aeobrien/DronemakerClonev3/docs/audio-interface/Whole-Component-Left-Sideview.JPG

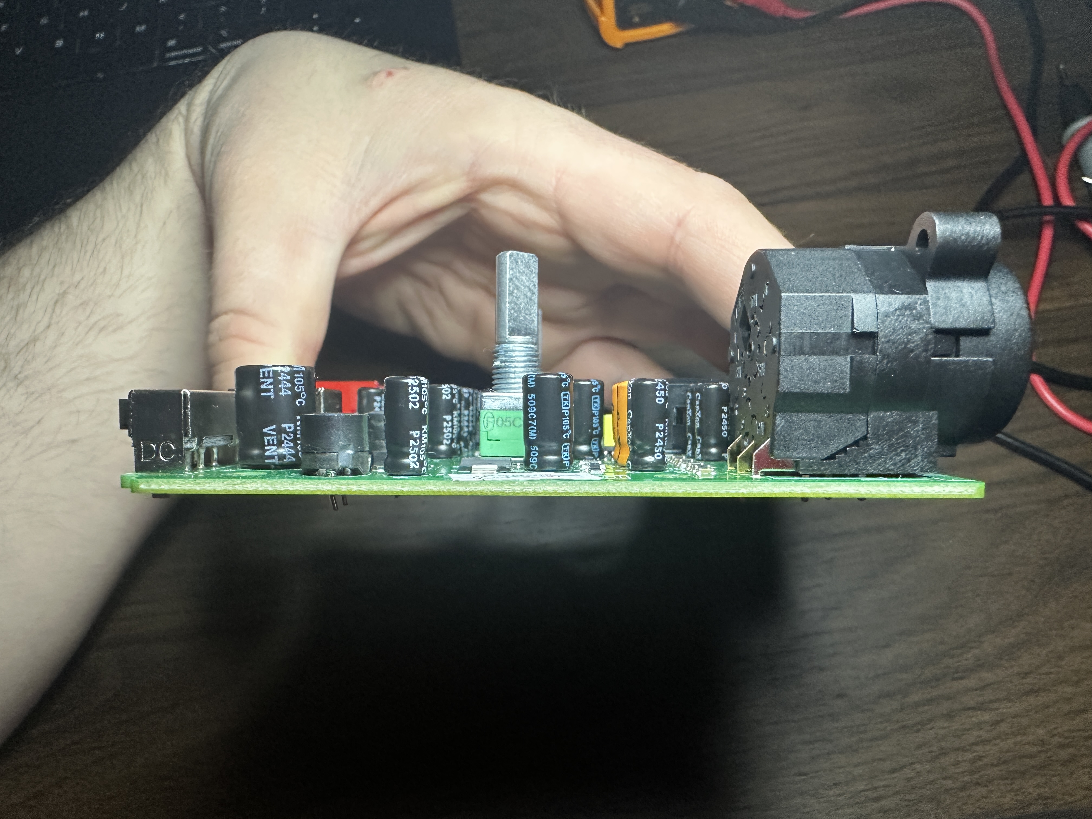
docs/audio-interface/Whole-Component-Left-Sideview.JPG
