aeobrien/DronemakerClonev3/docs/audio-interface/Whole-Component-Above.JPG

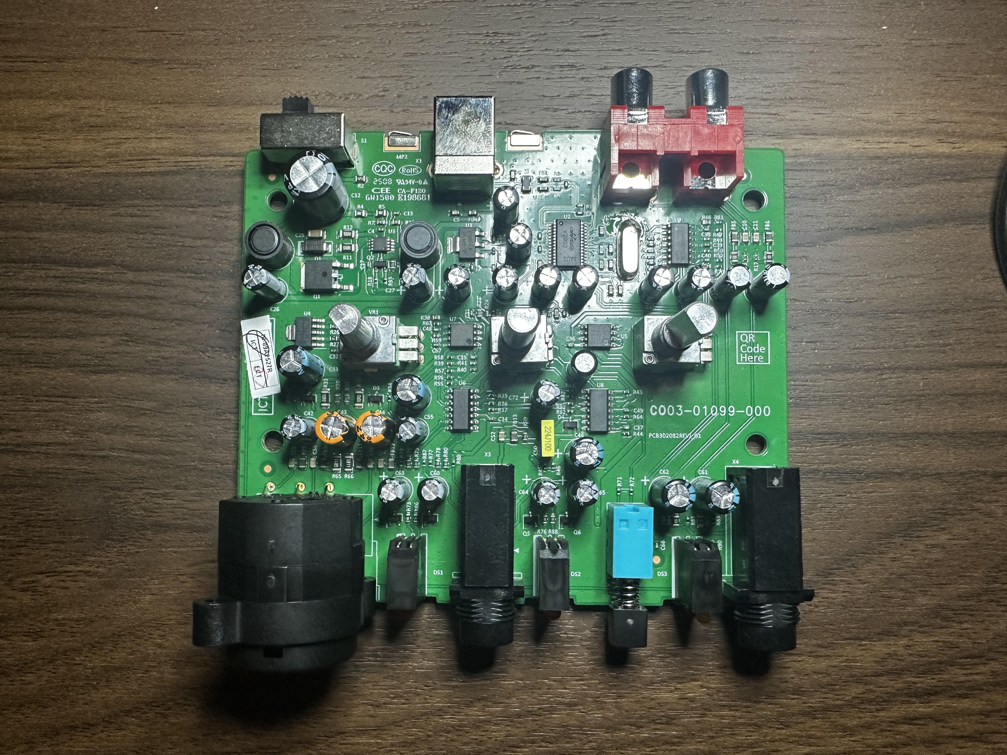
docs/audio-interface/Whole-Component-Above.JPG
