aeobrien/DronemakerClonev3/docs/reference/DronemakerClone — Notepad.md

A3 Printer: https://www.printpond.co.uk/
