aeobrien/DronemakerClonev3/ledger/decisions/LOG.md

# Decision Log

Decisions are recorded when there was a genuine choice between alternatives. Routine implementation details do not need entries.

| # | Date | Decision | Alternatives | Rationale | Impacts |
|---|---|---|---|---|---|
| 1 | 2026-03-30 | Use Behringer UM2 as audio interface, modified for panel-mount | Custom audio input stage; higher-end interface | Affordable (low-risk to modify), single PCB, all through-hole, USB audio class compliant on Linux | Audio Interface, Enclosure |
| 2 | 2026-03-30 | Teensy 4.1 for MIDI controller MCU | Direct Pi GPIO; Arduino | Native USB MIDI, ample pins, 3.3V logic, hardware encoder support, small footprint | MIDI Controller |
| 3 | 2026-03-30 | Shift registers at 3.3V (not 5V) for LED driving | 5V logic with level shifters | Teensy is 3.3V logic; common-anode LEDs still switch correctly (5V anode, 3.3V cathode = below Vf = off) | MIDI Controller |
| 4 | 2026-03-30 | Independent headphone output via Pi (not UM2 headphone jack) | Rewire UM2 headphone output | UM2 headphone was linked to main output; need independent monitor bus for loops/sub-mixes | Headphone Monitor, Audio Interface |
| 5 | 2026-03-30 | USB MIDI for encoder communication (not Pi GPIO) | Direct GPIO encoder reading | Modular, avoids Linux userspace jitter, leverages JUCE MIDI handling, extends to external controllers | MIDI Controller, Software |
| 6 | 2026-03-30 | Reuse original UM2 pots (not replacements) | Alpha replacement pots | Originals cleanly removed; eliminates value/taper matching concerns | Audio Interface |
| 7 | 2026-03-30 | Neutrik NAUSB3-W-B for Pi power input (USB-C, D-size) | Panel-mount DC jack + PD trigger; hardwired | Clean, consistent with other Neutrik connectors, standard D-size cutout | Enclosure |
| 8 | 2026-03-30 | Neutrik NAUSB-W-B for external MIDI USB-A (D-size) | Custom USB-A panel mount | Matches other Neutrik D-size connectors on backplate | Enclosure |
| 9 | 2026-03-30 | InnoMaker HiFi DAC HAT (PCM5122) for headphone output | Second USB DAC; rewire UM2 headphone | Already owned, I2S (no USB contention), well-supported on Pi | Headphone Monitor |
| 10 | 2026-03-30 | Headphone default mirrors main output; PFL button solos selected channel | Always-independent mix | Simpler default, PFL gives the preview capability needed for performance | Headphone Monitor, Software |
| 11 | 2026-03-30 | Phantom power switch stays on board, not panel-mounted; phantom left permanently on | Panel-mount toggle switch | No realistic risk — ribbon mics are the only concern, and user has never encountered one in 20 years of engineering | Audio Interface, Enclosure |
| 12 | 2026-03-30 | Reuse original UM2 pots with hookup wire (not Alpha replacements) | Replace with Alpha 9mm pots | Originals cleanly removed; eliminates all value/taper matching concerns | Audio Interface |
| 13 | 2026-03-31 | JLCPCB for MIDI controller PCB fabrication (DHL Express) | PCBWay; PCB Train (UK domestic) | Cheapest option (~£15-25 all-in), 5-7 day delivery, VAT at checkout (no customs risk), gerbers already packaged | MIDI Controller |
| 14 | 2026-03-31 | No separate headphone amp — use TPA6133A2 built into InnoMaker DAC HAT | External amp module (PAM8403, MAX97220, etc.); opamp circuit | HAT already includes TPA6133A2 headphone amp (138mW@16Ω, adequate for 32-250Ω). Eliminates extra board, power draw, and enclosure space | Headphone Monitor |
| 15 | 2026-03-31 | Passive pot for headphone volume (dual A10K spare) | Software-only volume; active gain stage | Simple wiring (amp output → pot → jack), no extra electronics. A10K functional, A1K ideal. Software volume via PCM5122 digital register available as secondary trim | Headphone Monitor |
| 16 | 2026-03-31 | Software level meters on touchscreen (not hardware VU/LED bargraph) | Tap UM2 audio signal + hardware peak detector + LED bargraph | Hardware metering would require modifying UM2 analogue circuit. JUCE already has level data — just needs UI rendering. Much simpler, no circuit risk | Audio Interface, Software |
| 17 | 2026-03-31 | Faceplate layout: buttons on short edge, screen on slope, 8 encoders below screen, 2 pots left (gains), 2 pots right (volumes), 4 LEDs by left pots | Various alternative arrangements | Encoder knobs align with screen width (19.87mm c-to-c, 4.77mm gaps). Pots grouped by function (input left, output right). LEDs indicate input levels only | Enclosure |
| 18 | 2026-03-31 | Headphone jack on backplate (not faceplate) | Faceplate | Groups all audio I/O connectors together on rear panel. Backplate has space (7 D-size cutouts in 233.4mm) | Enclosure |
| 19 | 2026-03-31 | TUK KUCC1820BPM for USB-C power input (not Neutrik NAUSB3-W-B) | Neutrik NAUSB3-W-B (unavailable); Cliff CP30201X (disclaims PD) | Pigtail design avoids PD passthrough risk — plug goes directly into Pi. Keystone mount, not D-size. Cutout dimensions TBD. | Enclosure |
| 20 | 2026-03-31 | Neutrik NAUSB3-B for USB-A data (USB-A outside, USB-B inside) | USB-A to USB-A feedthrough | Standard USB-A/B cable connects inside to Pi. D-size cutout, USB 3.0. | Enclosure |
| 21 | 2026-04-01 | TUK KUCC1820BPM is standard keystone mount (16.2 × 14.7mm cutout) | N/A | Confirmed from TUK product page: "standard profile keystone socket" | Enclosure |
| 22 | 2026-04-01 | Screen cutout sized to active display area (155 × 87mm, Option A) | Full board cutout (165 × 107mm, Option B) | Board mounts behind panel, bezel overlaps cutout edges. Hides asymmetry and positioning errors. Display active area offset from mount holes by X=+1.9mm, Z=-5.15mm. | Enclosure |
| 23 | 2026-04-01 | Headphone volume pot taper shaping: 1KΩ resistor wiper-to-ground per channel | Source a dual A1K pot (unavailable in 9mm dual-gang) | Standard technique reshapes A10K taper for low-impedance headphone loads. Two resistors, no new pot needed. | Headphone Monitor |
| 24 | 2026-04-01 | Outsource panel CAD to professional designer (Fiverr) | Continue iterating with FreeCAD scripting | Boolean STEP operations produced persistent geometry artifacts. A CAD designer with proper parametric modelling will produce a clean manufacturing-ready file. Design brief prepared. | Enclosure |
| 25 | 2026-04-02 | LED bezel hole size: 6.2mm | 6.3mm (extra clearance) | Measured: body ~6.1-6.2mm, flange 7.8mm. 6.2mm gives 0.8mm flange overlap per side — sufficient retention. 6.3mm buys nothing. | Enclosure |
| 26 | 2026-04-02 | Backplate connector order: Headphone, L Out, R Out, Instrument XLR, TRS, USB-A, USB-C | Previous order (XLR first) | Groups outputs on the left, inputs in the middle, data/power on the right | Enclosure |
| 27 | 2026-04-02 | Screen cutout centred on panel; mount holes offset −1.9mm from centre | Centre mount holes on panel | Active display area must appear centred to the user. The display board's active area is offset +1.9mm from its mount holes, so mount holes shift left. HDMI/USB ports on right edge (viewed from front). | Enclosure |
| 28 | 2026-04-02 | Design brief restructured: SVGs are layout guides, not technical drawings; designer owns accuracy | Provide DXF technical drawings | We cannot guarantee DXF accuracy — safer to provide visual guides + dimensions table and let the designer produce the technical files. | Enclosure |
| 29 | 2026-04-06 | MIDI-learned mappings take priority over VirtualEncoderBank dispatch | Encoder bank intercepts first (original order) | Encoder bank hardcodes CC 20-27; any MIDI Learn mapping for those CCs was silently dead because the encoder bank handled them first. Now learned mappings are checked before the encoder bank. | Software — UI & Control |
| 30 | 2026-04-06 | Pi layout as default on all platforms | Only auto-enable on Linux | Pi layout is the primary target UI; defaulting to it on macOS enables testing without CLI flags. `--desktop-layout` still available as override. | Software — UI & Control |
| 31 | 2026-04-08 | Mount Waveshare display inverted (180°), flip in software | Rearrange panel layout for right-way-up mounting | Designer's CAD requires inverted screen. Mounting right-way-up would push encoder row further from screen — unacceptable for ergonomics. Software rotation is trivial (`display_rotate=2` or JUCE transform). | Enclosure, Software — UI & Control, Raspberry Pi Platform |
| 32 | 2026-04-08 | Encoder holes reduced to 9.3mm (from 9.5mm), 3.3mm locator holes added | Previous spec (9.5mm, no locator holes) | Datasheet specifies 9.3mm mounting hole. Locator holes (3.3mm, 9mm above encoder centre) were missing from original design brief — needed to prevent encoder rotation in panel. Sent to designer. | Enclosure |
| 33 | 2026-04-10 | Non-polarised 47µF electrolytic capacitors acceptable for C4/C5 | Order specified polarised caps | Same capacitance (47µF) and voltage rating (100V). NP caps work in either direction — superset of the DC application. Physically larger (10×20mm vs 8×10mm) but fits pad spacing. Marked NP on body. | MIDI Controller |
| 34 | 2026-04-10 | Cheltenham Hackspace for CNC fabrication advice and membership | Online CNC services; Fiverr machinist | Emily's suggestion. Local resource, can learn CNC there. Visited open evening Apr 9, email sent Apr 10. Signing up for Standard + Plus One membership. | Enclosure |
| 35 | 2026-04-10 | PEC16-4xxxF encoder pinout: A (bottom left), B (bottom middle), C/common (bottom right), S/W (top two, interchangeable) | N/A | Confirmed from datasheet page 2 bottom diagram. GND bridges C and one S/W pin. Wiring: black=A, red=B, yellow=GND(C+S), white=SW. | MIDI Controller |
| 36 | 2026-04-11 | Swap CLOCK/LATCH in firmware (pin 34=CLOCK, pin 33=LATCH) + physical pin swap on U2 only | Pin-lift U1 and U3 (2 chips); cut traces and bodge wire; re-order corrected PCBs | PCB layout bug: SRCLK (pin 11) and RCLK (pin 12) are transposed on U1 and U3 but correct on U2. Confirmed by continuity testing. Firmware swap fixes the majority (2 of 3 chips), leaving only U2 needing a physical pin-lift — one chip instead of two. Least invasive fix. | MIDI Controller |
| 37 | 2026-04-13 | Request PCB revision from Tanveer: (1) correct U1/U3 SRCLK/RCLK swap, (2) add encoder RC debounce filters (32x 10kΩ + 16x 10nF) | Continue with firmware workaround + manual pin-lift | Proper fix is cheaper than debugging time. Encoder filters needed per PEC16 datasheet (same issue found independently on Loom). Combined £100 revision request with Loom brain board. | MIDI Controller |
