aeobrien/DronemakerClonev3/docs/audio-interface/Headphone-Out-Below.JPG

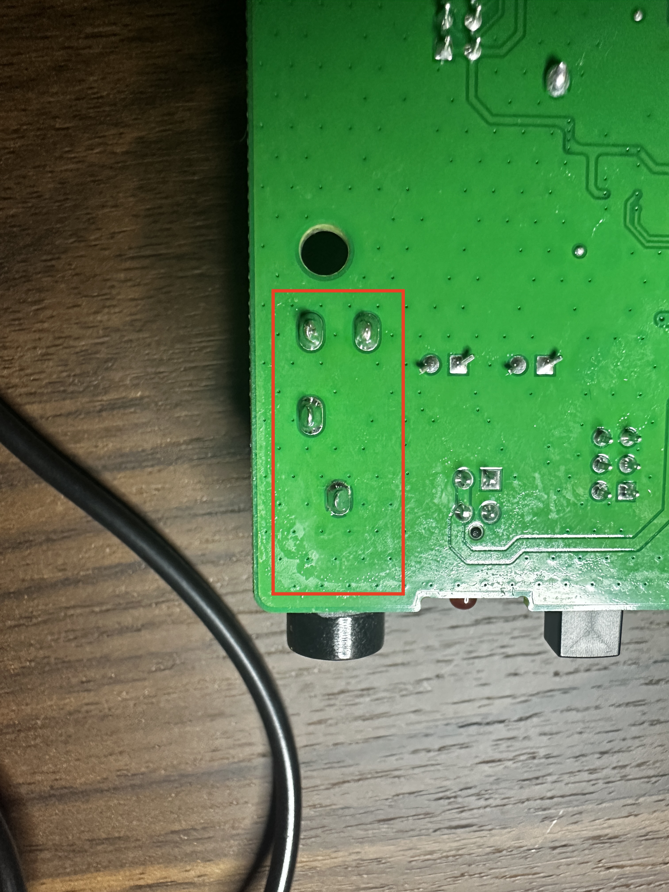
docs/audio-interface/Headphone-Out-Below.JPG
