aeobrien/DronemakerClonev3/docs/audio-interface/Instrument-In-Below.JPG

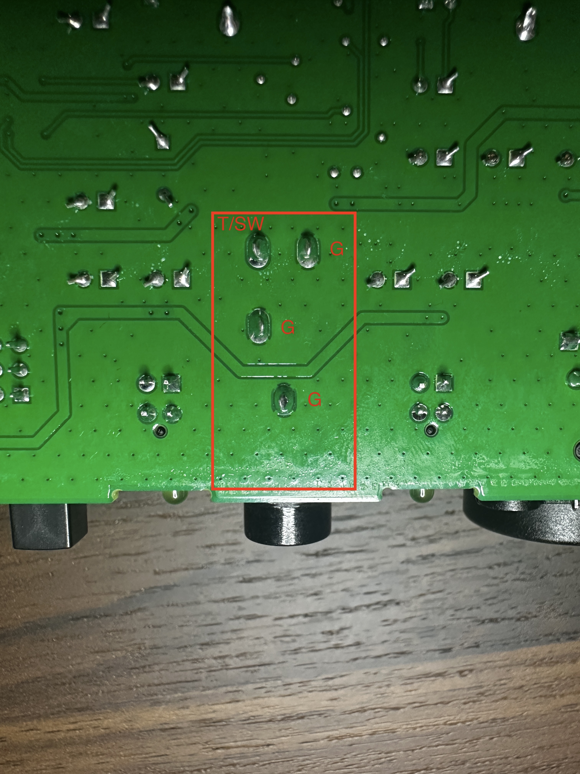
docs/audio-interface/Instrument-In-Below.JPG
