aeobrien/DronemakerClonev3/docs/audio-interface/Instrument-In-LEDs-Above.JPG

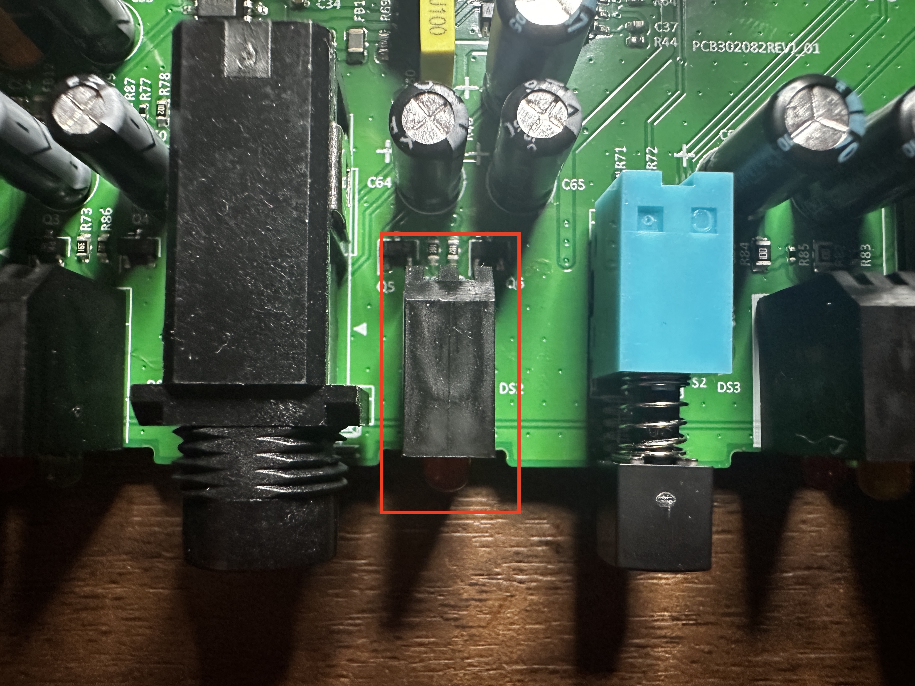
docs/audio-interface/Instrument-In-LEDs-Above.JPG
