aeobrien/DronemakerClonev3/docs/audio-interface/Instrument-In-LEDs-Below.JPG

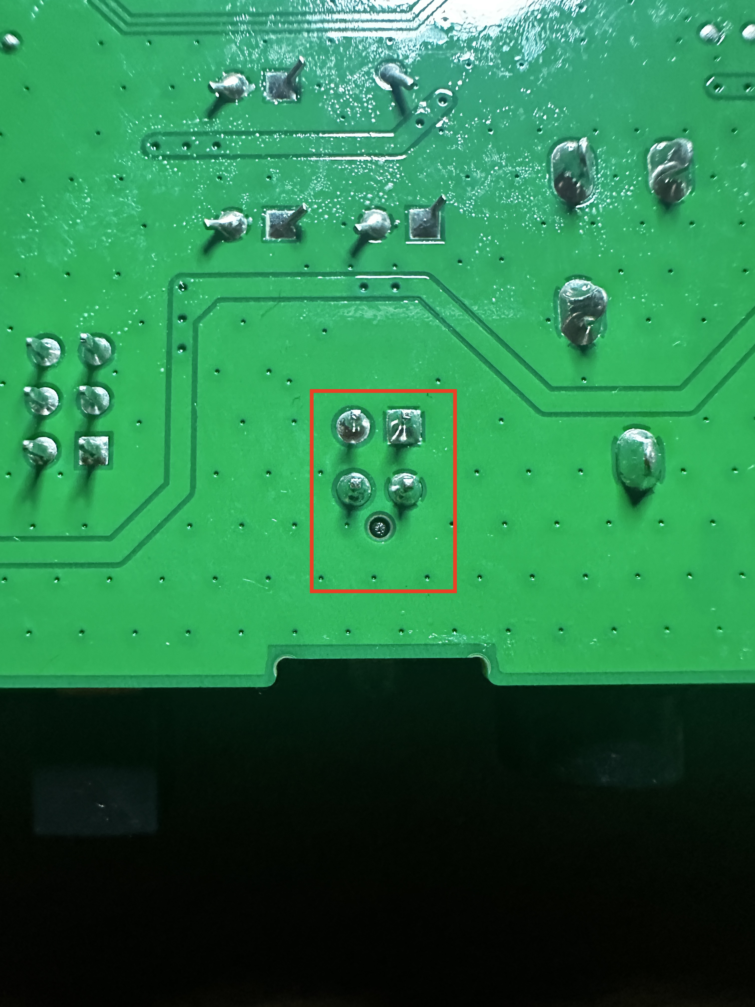
docs/audio-interface/Instrument-In-LEDs-Below.JPG
