aeobrien/DronemakerClonev3/docs/audio-interface/Instrument-In-Pot-Below.JPG

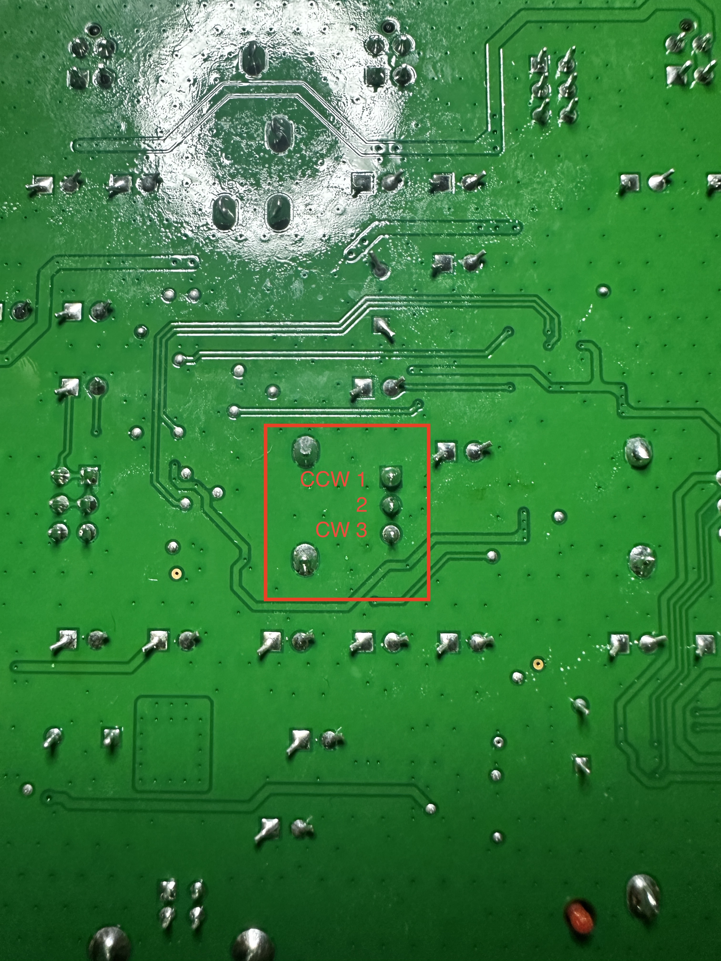
docs/audio-interface/Instrument-In-Pot-Below.JPG
