aeobrien/DronemakerClonev3/docs/audio-interface/Output-Pot-Below.JPG

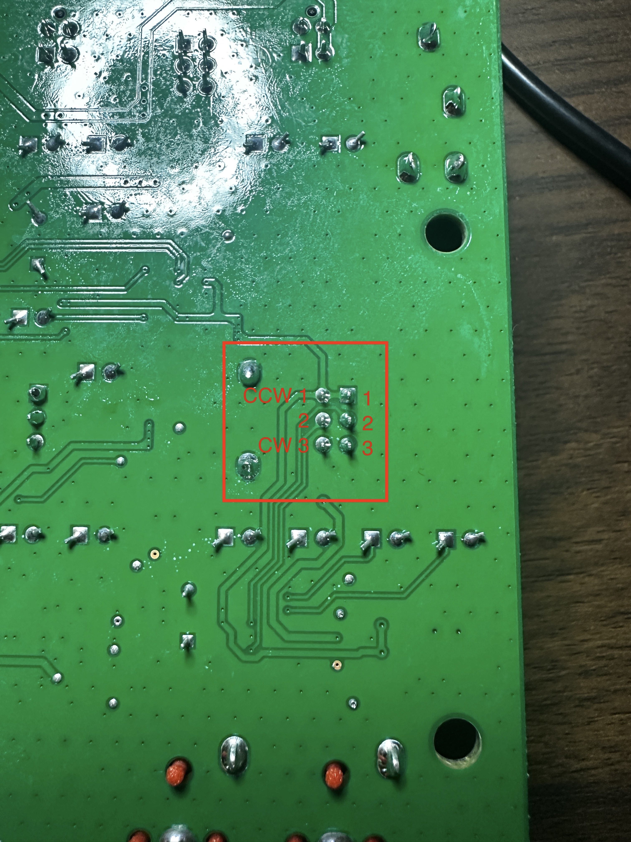
docs/audio-interface/Output-Pot-Below.JPG
