aeobrien/DronemakerClonev3/docs/audio-interface/Phantom-Switch-Below.JPG

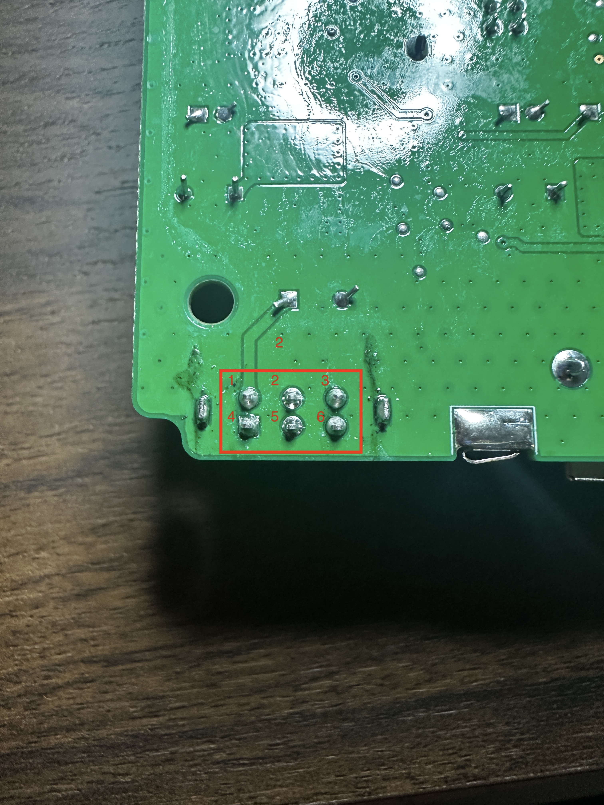
docs/audio-interface/Phantom-Switch-Below.JPG
