aeobrien/DronemakerClonev3/docs/audio-interface/Power-Phantom-LEDs-Above.JPG

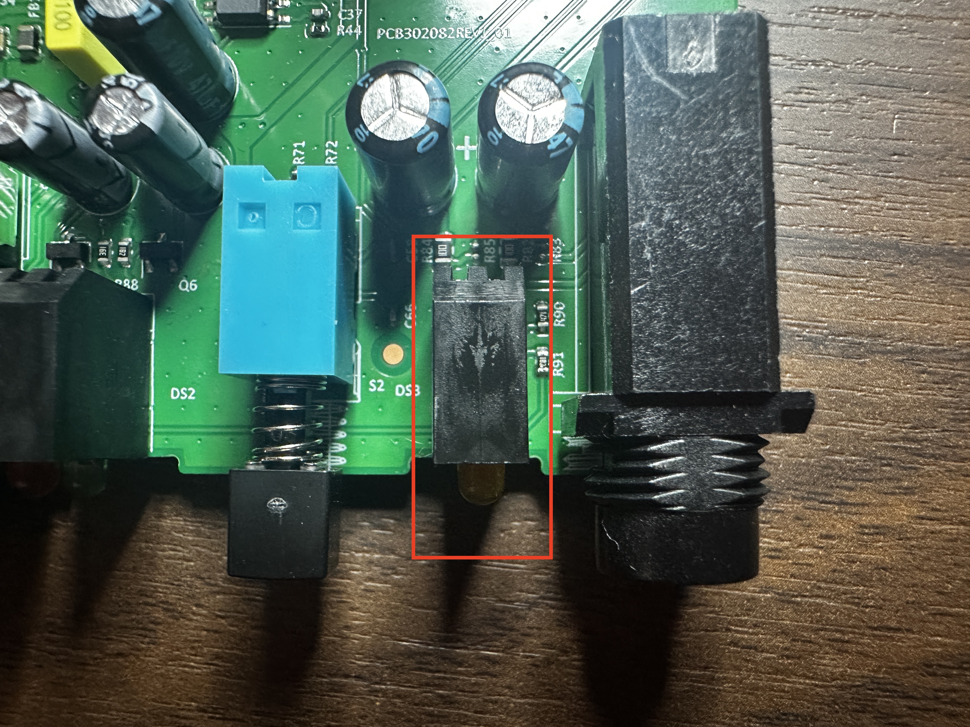
docs/audio-interface/Power-Phantom-LEDs-Above.JPG
