aeobrien/DronemakerClonev3/docs/audio-interface/Power-Phantom-LEDs-Below.JPG

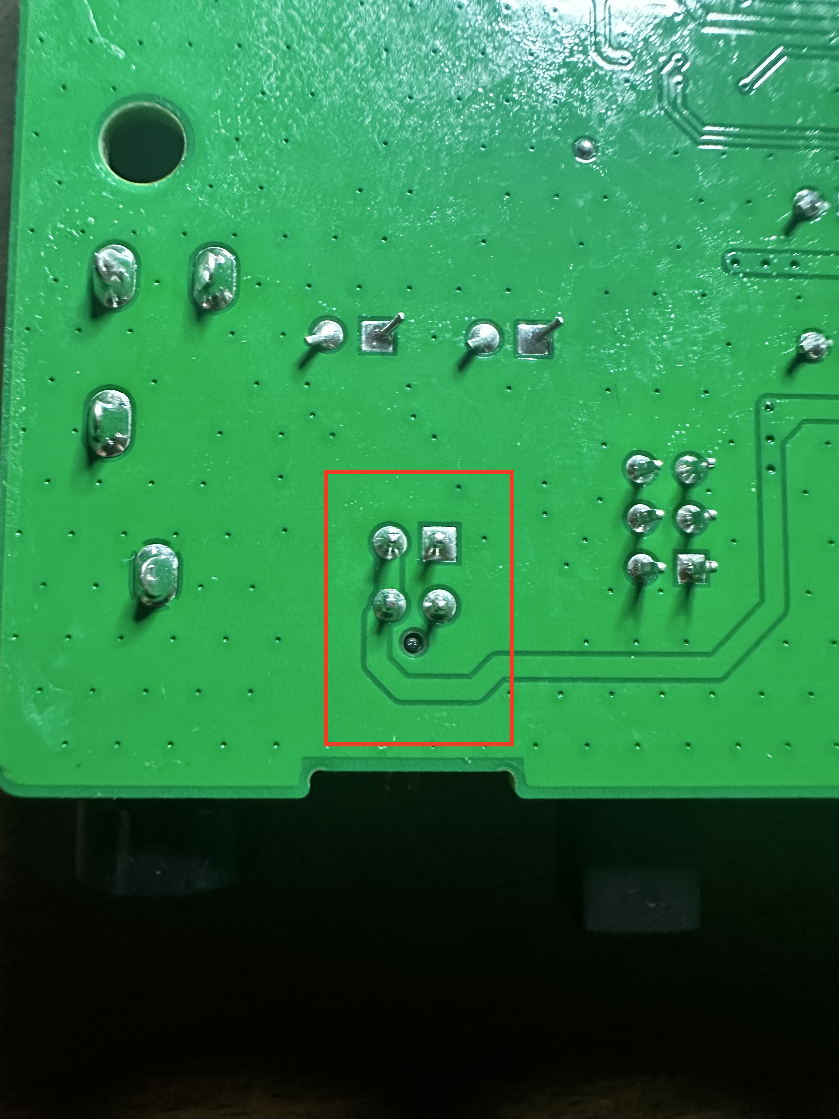
docs/audio-interface/Power-Phantom-LEDs-Below.JPG
