aeobrien/DronemakerClonev3/docs/audio-interface/RCA-Out-Below.JPG

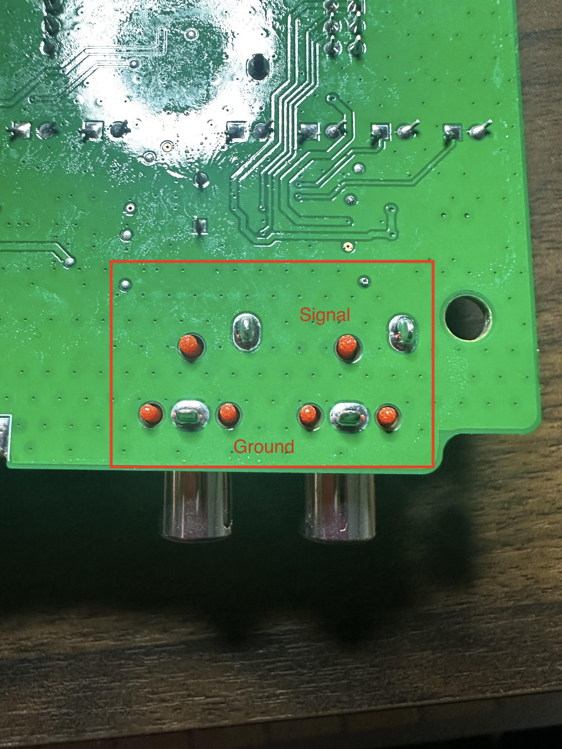
docs/audio-interface/RCA-Out-Below.JPG
