aeobrien/DronemakerClonev3/docs/audio-interface/XLR-TRS-Below.JPG

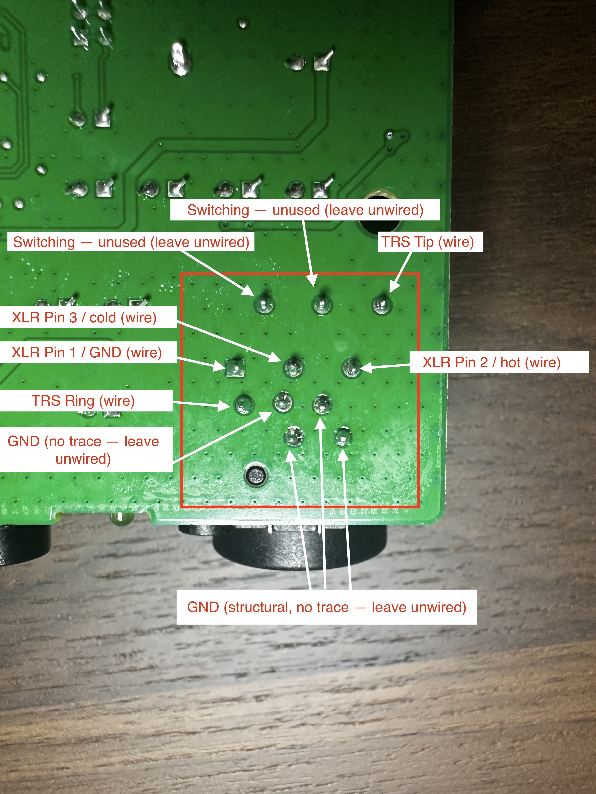
docs/audio-interface/XLR-TRS-Below.JPG
