aeobrien/DronemakerClonev3/docs/audio-interface/XLR-TRS-LEDs-Above.JPG

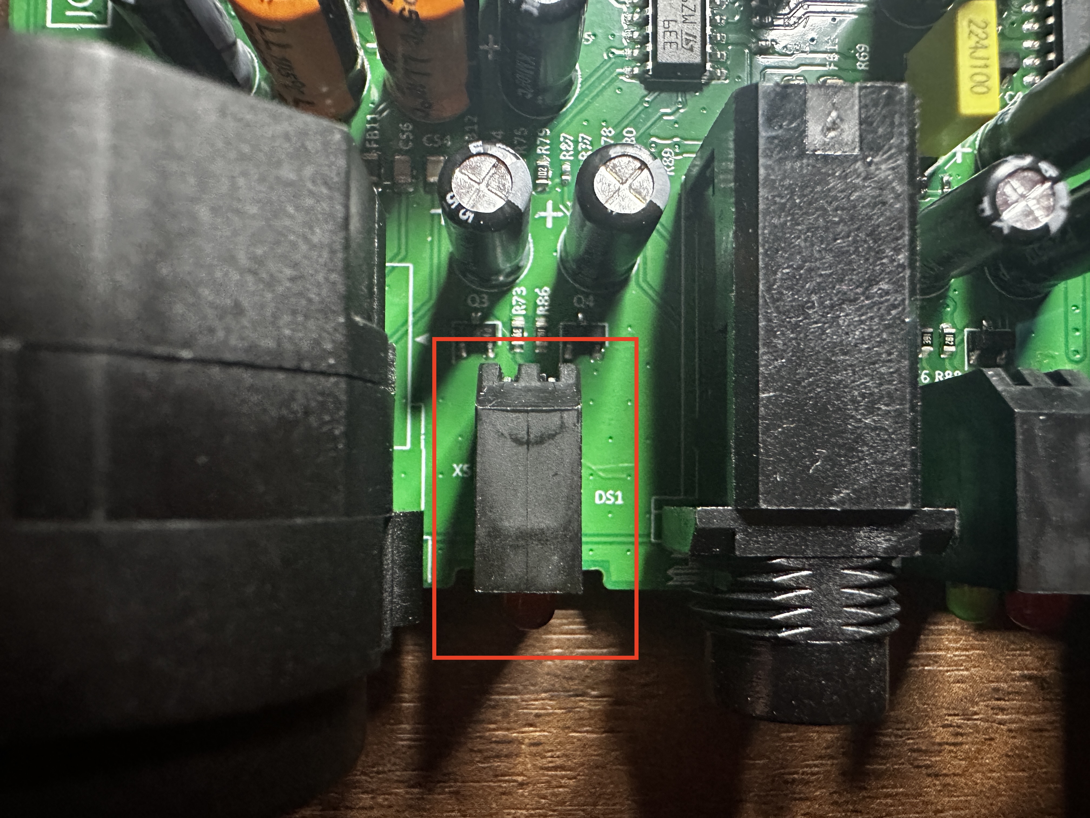
docs/audio-interface/XLR-TRS-LEDs-Above.JPG
