aeobrien/DronemakerClonev3/docs/audio-interface/XLR-TRS-LEDs-Below.JPG

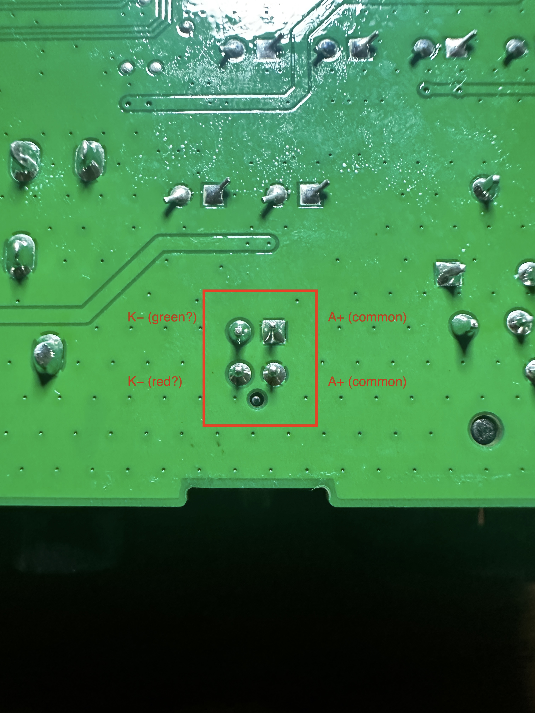
docs/audio-interface/XLR-TRS-LEDs-Below.JPG
