aeobrien/DronemakerClonev3/docs/audio-interface/XLR-TRS-Pot-Below.JPG

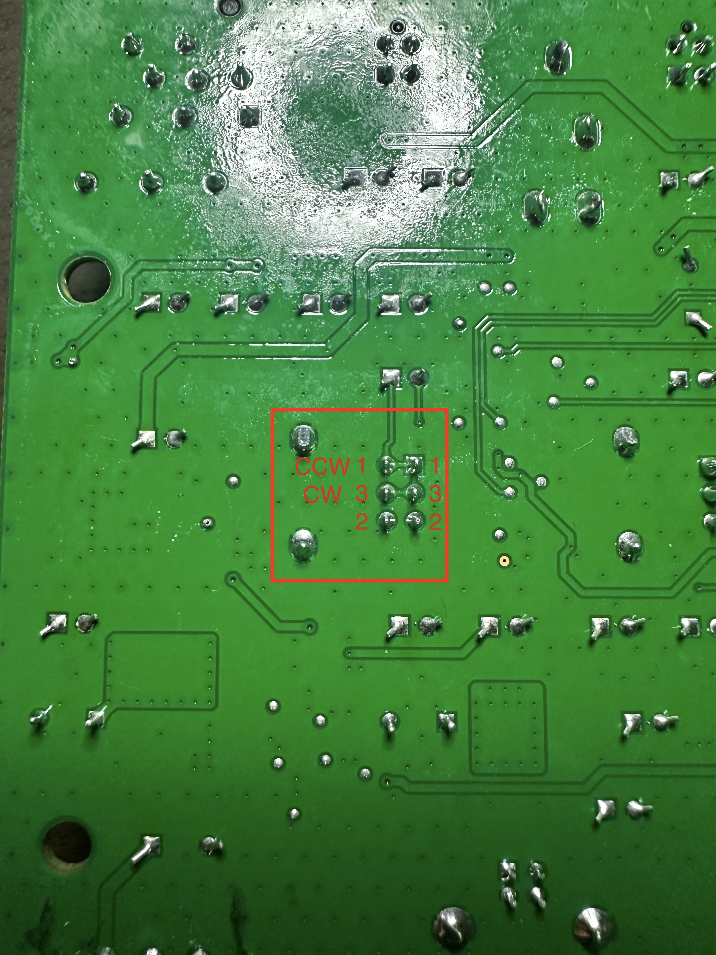
docs/audio-interface/XLR-TRS-Pot-Below.JPG
