aeobrien/DronemakerClonev3/docs/audio-interface/XLR-TRS-SideView.JPG

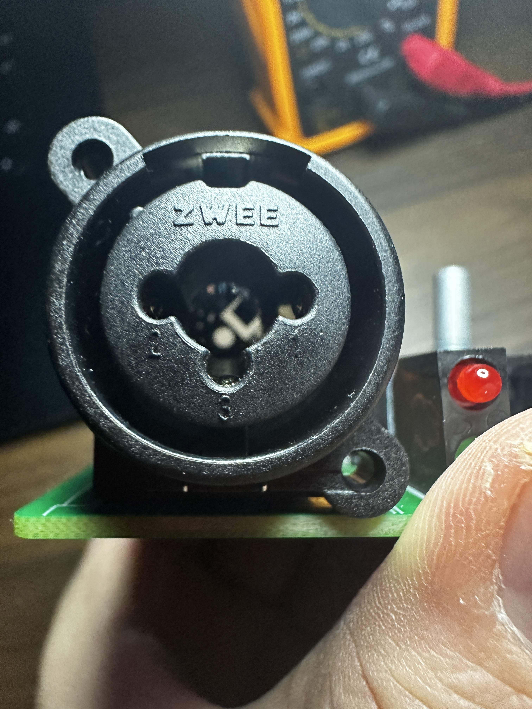
docs/audio-interface/XLR-TRS-SideView.JPG
