aeobrien/DronemakerClonev3/docs/midi-controller/MIDI Controller PCB Layout.jpeg

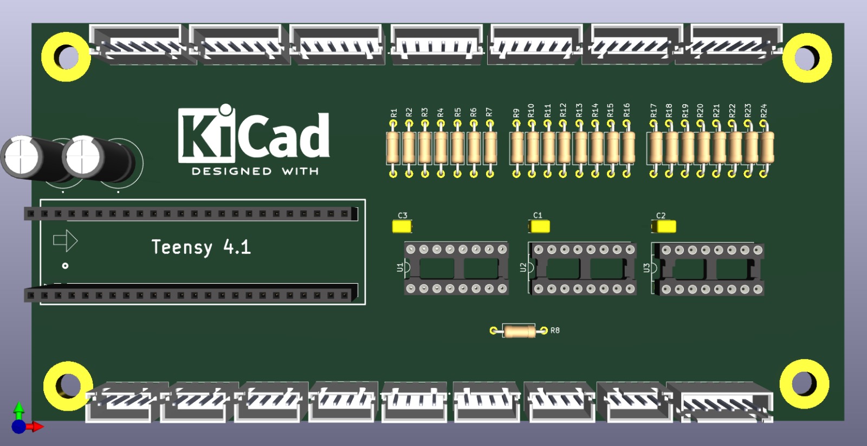
docs/midi-controller/MIDI Controller PCB Layout.jpeg
