aeobrien/DronemakerClonev3/ledger/SHOPPING_LIST.md

# Shopping List

> Items still needed. Updated: 2026-04-02

## Still To Buy

| Item | Spec | Purpose | Source | Ref |
|---|---|---|---|-----|
| Adhesive PCB clips (4mm) | Self-adhesive snap-in, 4mm hole | Mount UM2 PCB (×4) | Amazon / eBay / CPC | #42b |
| PCB mounting for Pi + MIDI controller | **Decision pending** — VHB tape, 3.18mm clips, or adhesive foam pads | Mount Pi 5 (2.7mm holes) + MIDI controller (5mm holes) | TBD | #42a/c |
| M3 screws (×4) | Length TBD after measuring panel + standoff depth | Screen mounting | Check stock | — |

## To Verify — May Already Have

| Item | Check |
|---|---|
| 1KΩ resistors ×2 | In stock (confirmed by user) |
| Hookup wire (stranded, 22–26 AWG) | In stock (confirmed by user) |
| M3 nylon standoffs/screws | Check existing kit for screen mounting |

## Ordered — In Transit

| Item | Ordered | Source | Ref |
|---|---|---|-----|
| MIDI Controller PCB ×5 | 2026-03-31, Order Y3-12248591A | JLCPCB (DHL Express) | #25 |
| TUK KUCC1820BPM USB-C panel mount | 2026-03-31 | CPC | #28 |
| Neutrik NAUSB3-B USB 3.0 feedthrough | 2026-03-31 | CPC | #29 |
| 3.5mm TRS plug | 2026-03-31 | CPC | #39 |
| Loctite 222 (purple) | 2026-03-31 | eBay | #41 |
| Heat shrink tubing kit (Eventronic) | 2026-04-01 | Amazon | #40 |
| 5mm LED bezels ×4 (chrome) | 2026-04-01 | eBay | #15 |
| Foam adhesive tape (1mm EVA) | 2026-04-01 | Amazon | #43 |
| Micro USB to USB-A cable (~15cm) | 2026-04-01 | Amazon | #45 |
| USB-A to USB-B cables (~15cm) ×2 | 2026-04-01 | Amazon | #46 |

## Waiting On (Not Yet Orderable)

| Item | Blocker |
|---|---|
| Faceplate/backplate (single panel) | CAD design needs outsourcing to professional designer. Brief ready at `hardware/enclosure/design-brief/` |

## Notes

- **LED bezel hole size:** confirm ~7.5mm when 5mm bezels arrive (currently spec'd as 8mm, may need adjustment)
- **Headphone pot:** using spare dual A10K (#38) + 1KΩ taper-shaping resistors (#44). All in hand.
- **Screen mounting:** M3 holes at 157.0 × 115.0mm spacing. Screen bolts directly to panel.
- **Panel design:** all cutout dimensions confirmed. Outsource to Fiverr CAD designer using the design brief.
