aeobrien/DronemakerClonev3/ledger/components/REGISTER.md

# Component Register

## Index

| # | Component | Type | Manufacturer | Part Number | Subsystem | Status | Qty |
|---|---|---|---|---|---|---|-----|
| 1 | Raspberry Pi 5 | SBC | Raspberry Pi | Raspberry Pi 5 (4GB or 8GB) | Pi Platform | In hand | 1 |
| 2 | Waveshare 7" HDMI LCD (C) | Display | Waveshare | 7inch HDMI LCD (C) | Pi Platform | In hand | 1 |
| 3 | Pi 5 27W USB-C PSU | Power supply | Raspberry Pi | Official Pi 5 PSU | Pi Platform | In hand | 1 |
| 4 | Behringer UM2 | Audio interface | Behringer | UM2 (PCB302082REVJ_01) | Audio Interface | In hand (modded) | 1 |
| 5 | Neutrik Combo XLR/TRS Jack | Connector | Neutrik | NCJ6FI-S (or NCJ9FI-S) | Audio Interface | In hand (TBC part) | 1 |
| 6 | Neutrik 1/4" Jack (instrument in) | Connector | Neutrik | NJ3FP6C-BAG | Audio Interface | In hand | 1 |
| 7 | Neutrik 1/4" Jack (L output) | Connector | Neutrik | NJ3FP6C-BAG | Audio Interface | In hand | 1 |
| 8 | Neutrik 1/4" Jack (R output) | Connector | Neutrik | NJ3FP6C-BAG | Audio Interface | In hand | 1 |
| 9 | Neutrik 1/4" Jack (headphone) | Connector | Neutrik | NJ3FP6C-BAG | Headphone Monitor | In hand | 1 |
| 10 | DPDT Toggle Switch (phantom) | Switch | Multicomp Pro | 1MD1T1B1M1QE | Audio Interface | In hand (staying on board) | 1 |
| 11 | UM2 Mic/Line Gain Pot | Potentiometer | Behringer (original) | 05C50K dual-gang | Audio Interface | In hand (reattached) | 1 |
| 12 | UM2 Instrument Gain Pot | Potentiometer | Behringer (original) | W50K single-gang | Audio Interface | In hand (reattached) | 1 |
| 13 | UM2 Output Volume Pot | Potentiometer | Behringer (original) | A20K dual-gang | Audio Interface | In hand (reattached) | 1 |
| 14 | 5mm LED Kit (clip/signal indicators) | LED | Various | 5mm red + green | Audio Interface | In hand | 1 kit |
| 15 | 5mm LED Bezels | Hardware | Various | Chrome ring, 6.2mm hole, 7.8mm flange | Audio Interface | In hand (arrived 2026-04-02) | 4 |
| 16 | Teensy 4.1 (with Ethernet + headers) | MCU | PJRC | Teensy 4.1 | MIDI Controller | In hand | 1 |
| 17 | Bourns PEC16 Rotary Encoder | Encoder | Bourns | PEC16-4220F-S0024 | MIDI Controller | In hand | 9 (8+1 spare) |
| 18 | 16mm RGB Momentary Pushbutton | Button | Adafruit | 3350 | MIDI Controller | In hand | 8 |
| 19 | 74HC595 Shift Register + DIP-16 Socket | IC | TE / TI | SN74HC595N / 2-1571552-4 | MIDI Controller | In hand | 3 (from pack of 20) |
| 20 | 220Ω Resistor (axial) | Resistor | Various | 220Ω 1/4W | MIDI Controller | In hand | 24 |
| 21 | 100nF Ceramic Capacitor | Capacitor | Various | 50V 100nF monolithic | MIDI Controller | In hand | 3 (from pack of 50) |
| 22 | 47µF Electrolytic Capacitor | Capacitor | Various | ECA2AM470B | MIDI Controller | In hand | 2 |
| 23 | JST XH 4-pin Headers + Housings | Connector | JST | B4B-XH-A / XH-4Y | MIDI Controller | In hand | 8 (from 460pc kit) |
| 24 | JST XH 6-pin Headers + Housings | Connector | JST | B6B-XH-A / XH-6Y | MIDI Controller | In hand | 8 (from 460pc kit) |
| 25 | MIDI Controller PCB | PCB | JLCPCB | Teensy_4.1_Based_MCU (Order Y3-12248591A) | MIDI Controller | Ordered 2026-03-31, 2-day build + DHL Express | 5 |
| 26 | Solid Aluminium Control Knob (6mm) | Hardware | Various | Plain, no position indicator | MIDI Controller | In hand | 9 |
| 27 | Hammond Console Enclosure | Enclosure | Hammond | 1456KK4BKBK | Enclosure | In hand | 1 |
| 28 | TUK USB-C Panel Mount (Pi power) | Connector | TUK | KUCC1820BPM | Enclosure | Ordered 2026-03-31 from CPC (CN21767). Panel cutout TBD — email TUK | 1 |
| 29 | Neutrik USB 3.0 Feedthrough (ext MIDI/data) | Connector | Neutrik | NAUSB3-B | Enclosure | Ordered 2026-03-31 from CPC (CN20592) | 1 |
| 30 | Faceplate (laser cut aluminium) | Panel | ProtoCase (TBC) | Custom | Enclosure | Not designed | 1 |
| 31 | Backplate (laser cut aluminium) | Panel | ProtoCase (TBC) | Custom | Enclosure | Not designed | 1 |
| 32 | InnoMaker HiFi DAC HAT | Audio DAC | InnoMaker | PCM5122 DAC HAT | Headphone Monitor | In hand | 1 |
| 33 | ~~Headphone Amplifier~~ | ~~Audio amp~~ | ~~TBD~~ | ~~TBD~~ | ~~Headphone Monitor~~ | Not needed — TPA6133A2 built into DAC HAT (#32) | — |
| 38 | Headphone Volume Pot | Potentiometer | Alpha (spare) | RD902F-40-15R1-A10K (dual A10K) | Headphone Monitor | In hand (spare from #36). Use with 1KΩ taper-shaping resistors | 1 |
| 44 | Taper-shaping Resistors | Resistor | Various | 1KΩ 1/4W axial | Headphone Monitor | To source (or check stock) | 2 |
| 39 | 3.5mm TRS Plug/Cable | Cable | Various | 3.5mm TRS to bare wire (short) | Headphone Monitor | Ordered 2026-03-31 from CPC | 1 |
| 40 | Heat Shrink Tubing Kit | Consumable | Eventronic | Assorted 1.5–13mm, 2:1 ratio, 600 pcs | General | Ordered 2026-04-01 | 1 kit |
| 41 | Loctite 222 (purple threadlocker) | Consumable | Henkel | Loctite 222 | General | Ordered 2026-03-31 | 1 tube |
| 42 | Internal PCB mounting hardware | Hardware | Various | Approach TBD — see enclosure open questions | General | Decision pending | — |
| 45 | Micro USB to USB-A cable | Cable | Various | ~15cm, USB 2.0 | MIDI Controller | Ordered 2026-04-01 | 1 |
| 46 | USB-A to USB-B cable | Cable | Various | ~15cm, USB 2.0 | General | Ordered 2026-04-01 | 2 |
| 43 | Foam Adhesive Tape (1mm, single-sided) | Hardware | PATIKIL | EVA, 10mm wide | Enclosure | Ordered 2026-04-01 | 1 roll |
| 47 | Large Aluminium Control Knob (20mm, 6mm hole) | Hardware | Various | Solid aluminium, grub screw | Enclosure | In hand | 4 |
| 34 | Perfboard (5×7cm double-sided) | PCB | GTIWUNG | Universal PCB 5cmx7cm | MIDI Controller | In hand (superseded by custom PCB) | 10 |
| 35 | Alpha 9mm A50K Pot (round shaft) | Potentiometer | Alpha | RD901F-40-15R1-A50K | Audio Interface | In hand (superseded — originals reused) | 1 |
| 36 | Alpha 9mm Dual A10K Pot | Potentiometer | Alpha | RD902F-40-15R1-A10K | Audio Interface | In hand (superseded — originals reused) | 2 |
| 37 | Alpha 9mm Dual C50K Pot | Potentiometer | Alpha | RD902F-40-15R1-C50K | Audio Interface | In hand (superseded — originals reused) | 1 |

---

## Component Details

### #4 — Behringer UM2

Core audio interface PCB, board rev PCB302082REVJ_01. Stripped from original enclosure, user-facing components desoldered and replaced with panel-mount equivalents. Pots (#11-13) cleanly removed and reattached with hookup wire. XLR/TRS jack and LEDs still to complete.

Full teardown documentation: `docs/audio-interface/`

### #5 — Neutrik Combo XLR/TRS Jack

Part selection not finalised: NCJ6FI-S vs NCJ9FI-S depends on pin compatibility with phantom power wiring. See audio interface open questions.

### #10 — Phantom Power Toggle Switch

Originally planned for panel-mount backplate. Decision changed: phantom power left permanently on, switch stays soldered to UM2 board. Component in hand but not being relocated.

### #14-15 — UM2 Replacement LEDs

Original UM2 LEDs were 3mm, housed in a dual-LED plastic component. Cannot be reused in original form. Replacements are individual 5mm LEDs in 5mm chrome panel-mount bezels. **Bezels arrived 2026-04-02.** Measured: body ~6.1-6.2mm, flange 7.8mm. Panel hole: **6.2mm**. Need to verify forward voltage/current of originals to confirm compatibility — likely not critical for indicator LEDs.

### #16 — Teensy 4.1

Ethernet variant with headers. The Ethernet jack (if present on this specific board) is unused — check clearance during dry-fit. Sits in 2×24 pin socket headers (HC-PM254-8.5H-1x24PZ, 8.5mm height) on the custom PCB.

### #17 — Bourns PEC16-4220F-S0024

20mm flatted D-shaft, 24 detents, 24 pulses/rev, with push switch. Mounting hole 9.5mm. Max panel thickness ~2.7mm with washer+nut (Hammond top panel is 1.63mm — fine).

Datasheet: https://eu.mouser.com/datasheet/3/40/1/pec16.pdf

### #18 — Adafruit 3350 RGB Pushbutton

16mm mounting hole, panel thickness 1-7mm. Common-anode RGB LED (6V rated, operates 3-6V). Switch and LED circuits isolated. Cathodes driven via 220Ω resistors from shift registers.

Product page: https://thepihut.com/products/rugged-metal-pushbutton-16mm-6v-rgb-momentary

### #25 — MIDI Controller PCB

Ordering from JLCPCB via DHL Express. 163.6 × 81.1mm, 2-layer, 1.6mm, 1oz copper, green solder mask, HASL finish. Gerbers in `hardware/midi-controller/gerber_to_order/`.

### #26 — Aluminium Control Knobs

Plain solid aluminium, no position indicator, 6mm round/splined bore. Note: Alpha 9mm pots (and PEC16 encoders) have 6.0mm shafts, NOT 6.35mm (1/4"). These knobs are listed for 6mm so should fit. Verify on arrival.

Source: https://www.ebay.co.uk/itm/386817735048

### #28 — TUK KUCC1820BPM (USB-C Panel Mount)

USB-C socket on panel side with 200mm USB-C plug pigtail on inside. Plugs directly into Pi 5 USB-C power port. Rated 5A / 100W / 20V max. All pins pass through (including CC for PD negotiation). Standard profile keystone mount — **panel cutout: 16.2 × 14.7mm** (standard keystone opening). Purchased from CPC (CN21767), £9.58 inc VAT.

### #29 — Neutrik NAUSB3-B (USB 3.0 Feedthrough)

USB-A on outside, USB-B on inside. Reversible insert (can swap A/B sides without tools). Standard Neutrik D-size cutout (24.0 × 19.2mm). USB 3.0 (5 Gbps). Connect inside USB-B to Pi USB-A port with standard USB-A to USB-B cable. Zinc diecast housing, nickel plated. Purchased from CPC (CN20592).

### #32 — InnoMaker HiFi DAC HAT

PCM5122 DAC (384kHz/32bit) + TPA6133A2 headphone amplifier, I2S connection to Pi GPIO. Already owned. Will provide second audio output for independent headphone monitoring. The TPA6133A2 drives headphones directly — no separate amp needed. Output wired through passive dual-gang pot (#38) to panel-mount TRS jack. Untested with JUCE dual-device output.

### #33 — Headphone Amplifier (NOT NEEDED)

Originally planned as a separate component. The InnoMaker DAC HAT (#32) includes a TPA6133A2 headphone amp IC. Adequate for 32–250Ω headphones. No separate amp required.

### #38 — Headphone Volume Pot

Spare dual A10K from #36 (Alpha 9mm, originally bought for UM2 replacement). Wired as passive voltage divider between TPA6133A2 headphone output and panel-mount TRS jack. **With 1KΩ resistor from wiper to ground on each gang (#44)**, the taper is reshaped to give a usable volume sweep across the full rotation. Without the resistor, most of the volume change is crammed into the last 20% of rotation with low-impedance headphones. Mounts on faceplate, right side, bottom position.

### #34-37 — Superseded Components

These were originally planned but are no longer needed for their original purpose:
- **#34 Perfboards:** Replaced by custom PCB (#25)
- **#35-37 Alpha replacement pots:** Superseded by decision to reuse original UM2 pots (#11-13)

May be useful as spares or for other projects.

---

## Datasheet Links

| # | Component | Datasheet |
|---|---|---|
| 17 | PEC16 Encoder | https://eu.mouser.com/datasheet/3/40/1/pec16.pdf |
| 18 | RGB Pushbutton | https://thepihut.com/products/rugged-metal-pushbutton-16mm-6v-rgb-momentary |
| 10 | DPDT Toggle | https://www.farnell.com/datasheets/3122492.pdf |
| 5 | NCJ6FI-S | https://www.neutrik.com/en/product/ncj6fi-s |
| 6-9 | NJ3FP6C-BAG | https://www.farnell.com/datasheets/2119817.pdf |
| 19 | 74HC595 | http://www.ti.com/lit/ds/symlink/sn74hc595.pdf |
| 35 | Alpha 9mm A50K | https://www.taydaelectronics.com/datasheets/files/7930.pdf |
| 36 | Alpha 9mm Dual A10K | https://www.taydaelectronics.com/datasheets/files/RV162-41-15R1.pdf |
