aeobrien/DronemakerClonev3/docs/audio-interface/Whole-Component-Back-SideView.JPG

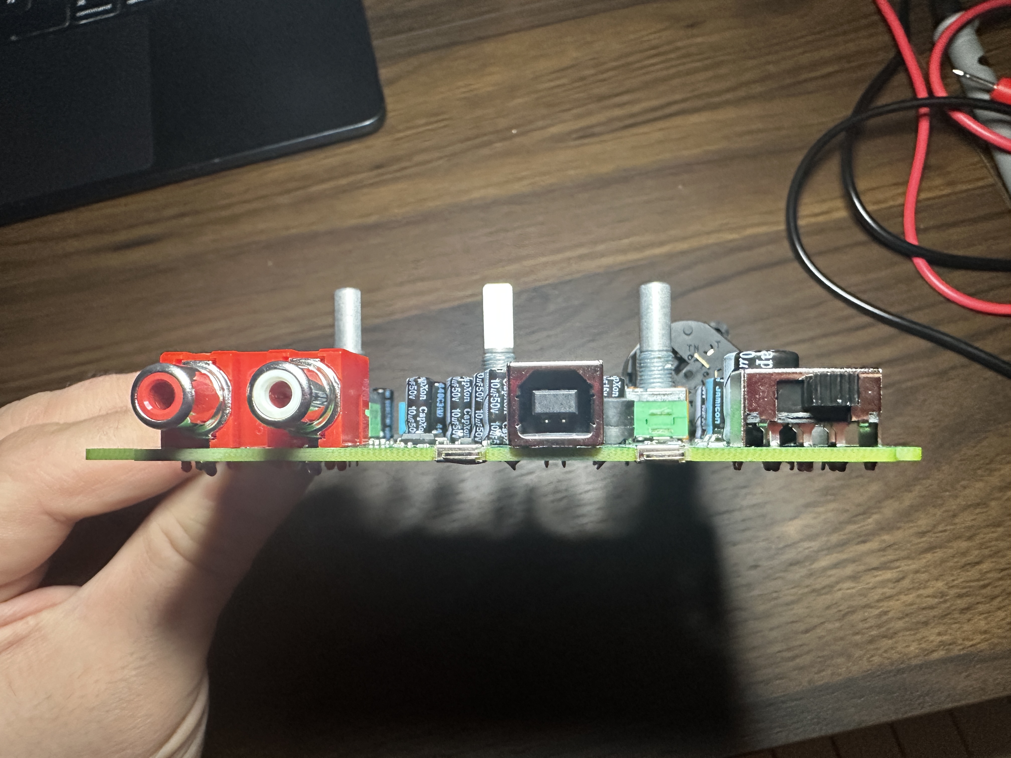
docs/audio-interface/Whole-Component-Back-SideView.JPG
