aeobrien/DronemakerClonev3/docs/audio-interface/Whole-Component-Below.JPG

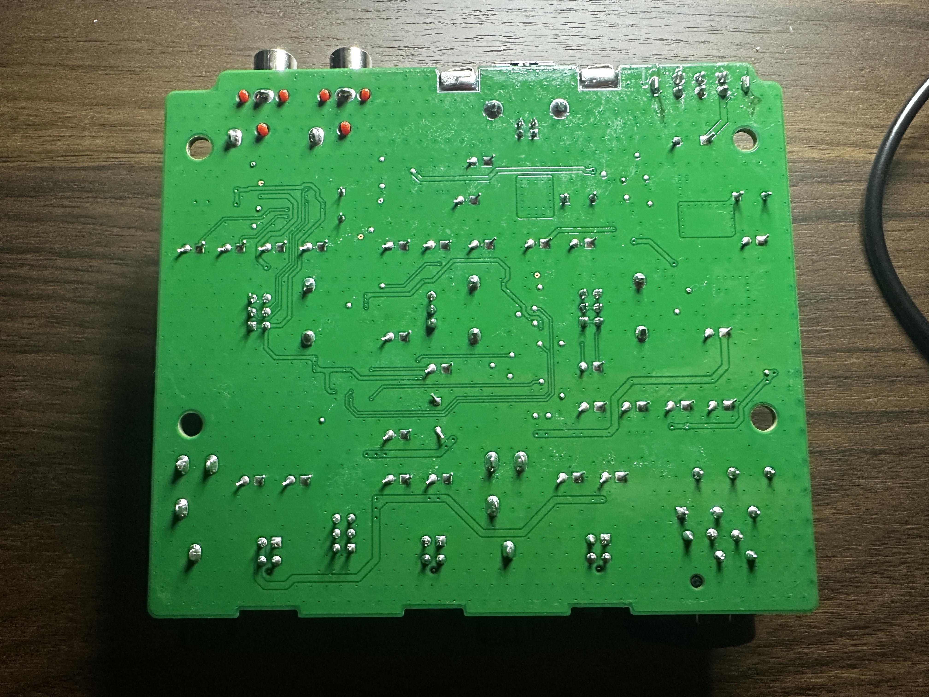
docs/audio-interface/Whole-Component-Below.JPG
