aeobrien/DronemakerClonev3/docs/audio-interface/Whole-Component-Front-SideView.JPG

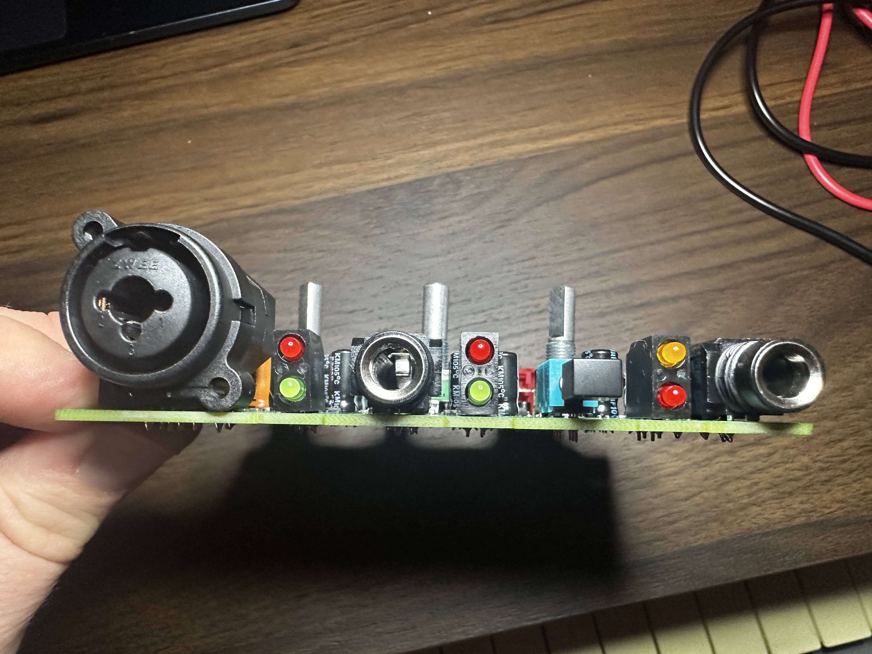
docs/audio-interface/Whole-Component-Front-SideView.JPG
