aeobrien/DronemakerClonev3/docs/audio-interface/Whole-Component-Right-Sideview.JPG

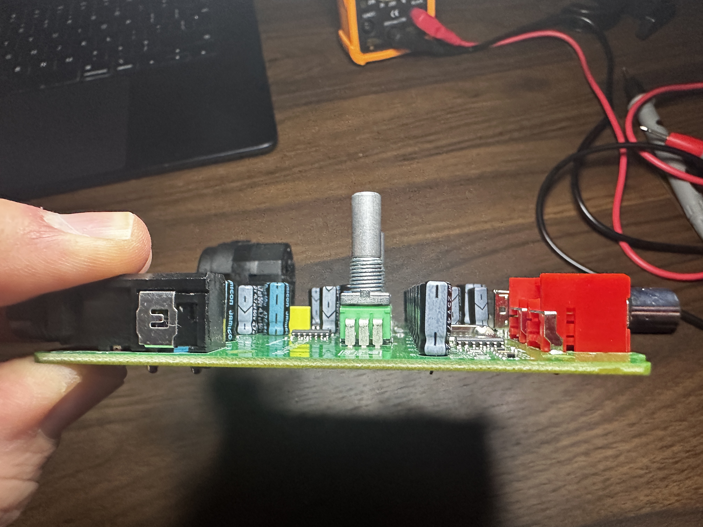
docs/audio-interface/Whole-Component-Right-Sideview.JPG
