aeobrien/DronemakerClonev3/hardware/enclosure/design-brief/models/1456KK4BKBK_whole_enclosure.stp

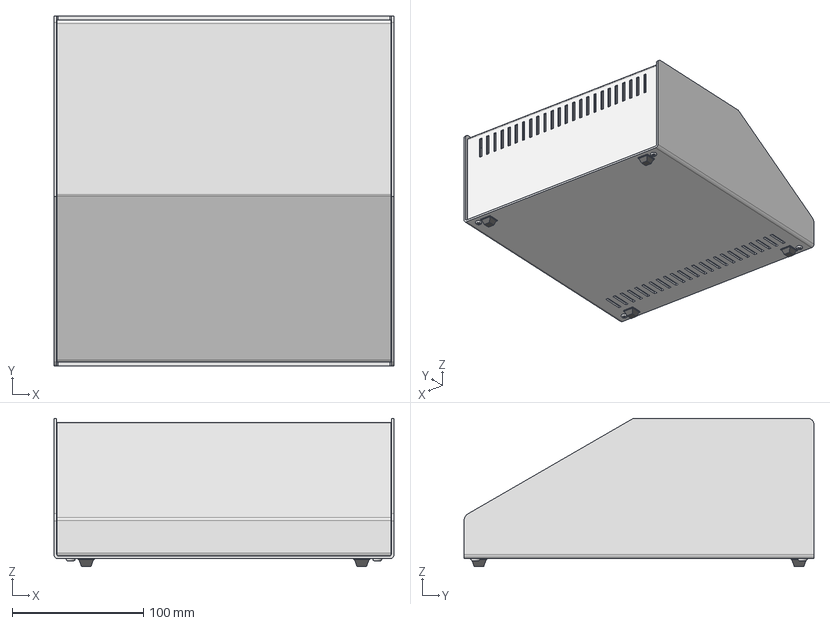
[picture p31: CAD file, 2026-06-22]
hardware/enclosure/design-brief/models/1456KK4BKBK_whole_enclosure.stp
258.6 x 266.3 x 112.9 mm
3M SJ-5018 RUBBER FOOT (PFR1421T3) x 4
