aeobrien/DronemakerClonev3/hardware/enclosure/Faceplate_v9_assembly.step

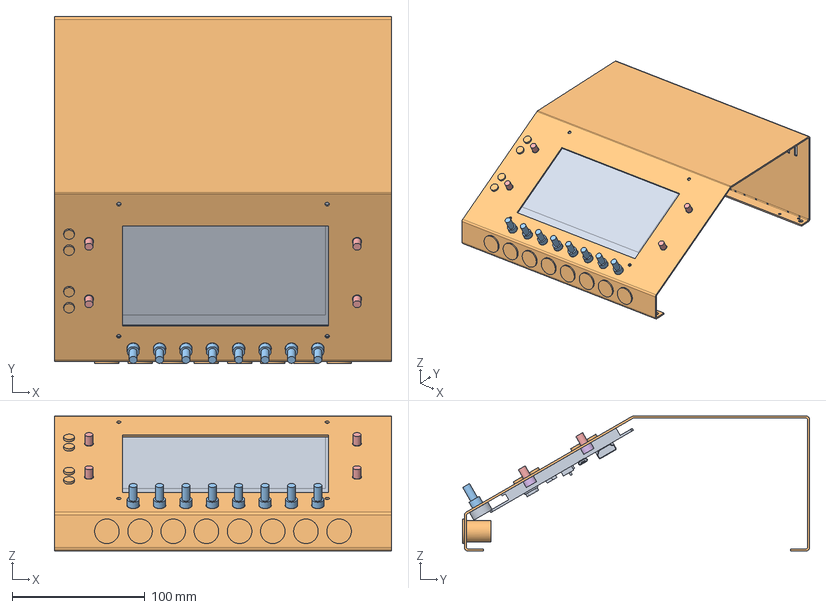
[picture p32: CAD file, 2026-06-22]
hardware/enclosure/Faceplate_v9_assembly.step
254.0 x 261.4 x 101.6 mm
