aeobrien/DronemakerClonev3/hardware/components/display.stp

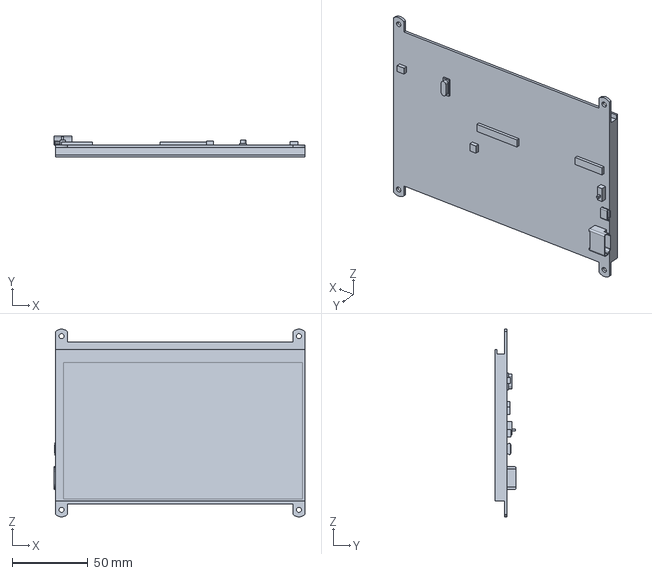
[picture p33: CAD file, 2026-06-22]
hardware/components/display.stp
166.0 x 14.1 x 124.1 mm
