aeobrien/DronemakerClonev3/hardware/enclosure/design-brief 2/models/1456KK4BKBK_faceplate_only.stp

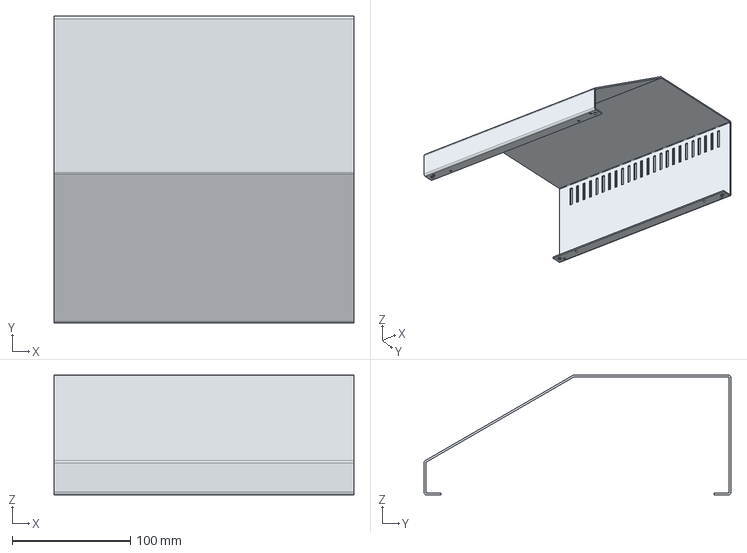
[picture p34: CAD file, 2026-06-22]
hardware/enclosure/design-brief 2/models/1456KK4BKBK_faceplate_only.stp
254.0 x 259.9 x 101.6 mm
