aeobrien/DronemakerClonev3/hardware/enclosure/design-brief-assembly/layout_slope_face.FCStd

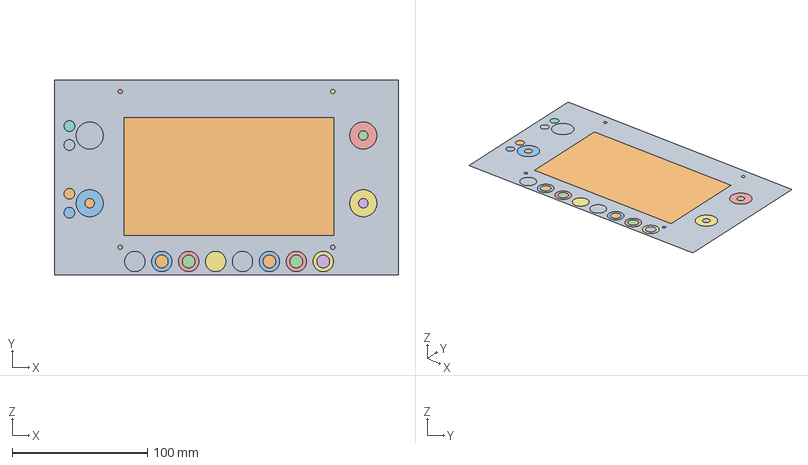
[picture p35: CAD file, 2026-06-22]
hardware/enclosure/design-brief-assembly/layout_slope_face.FCStd
254.0 x 144.0 x 0 mm
Panel_Slope_254x144
CUTOUT_Screen_155x87
REF_Active_Pixels_154.21x85.92
Mount_M3_3.3mm
Mount_M3_3.3mm001
Mount_M3_3.3mm002
Mount_M3_3.3mm003
Encoder_1_Hole_9.5mm
Encoder_1_Knob_15.1mm_REF
Encoder_2_Hole_9.5mm
Encoder_2_Knob_15.1mm_REF
Encoder_3_Hole_9.5mm
Encoder_3_Knob_15.1mm_REF
Encoder_4_Hole_9.5mm
Encoder_4_Knob_15.1mm_REF
Encoder_5_Hole_9.5mm
Encoder_5_Knob_15.1mm_REF
Encoder_6_Hole_9.5mm
Encoder_6_Knob_15.1mm_REF
Encoder_7_Hole_9.5mm
Encoder_7_Knob_15.1mm_REF
Encoder_8_Hole_9.5mm
Encoder_8_Knob_15.1mm_REF
Pot_XLR_Gain_7mm
Pot_XLR_Gain_Knob_20.1mm_REF
Pot_Inst_Gain_7mm
Pot_Inst_Gain_Knob_20.1mm_REF
Pot_Master_Vol_7mm
Pot_Master_Vol_Knob_20.1mm_REF
Pot_HP_Vol_7mm
Pot_HP_Vol_Knob_20.1mm_REF
LED_8mm_TBC
LED_8mm_TBC001
LED_8mm_TBC002
LED_8mm_TBC003
