aeobrien/DronemakerClonev3/hardware/enclosure/design-brief-assembly/layout_back_panel.FCStd

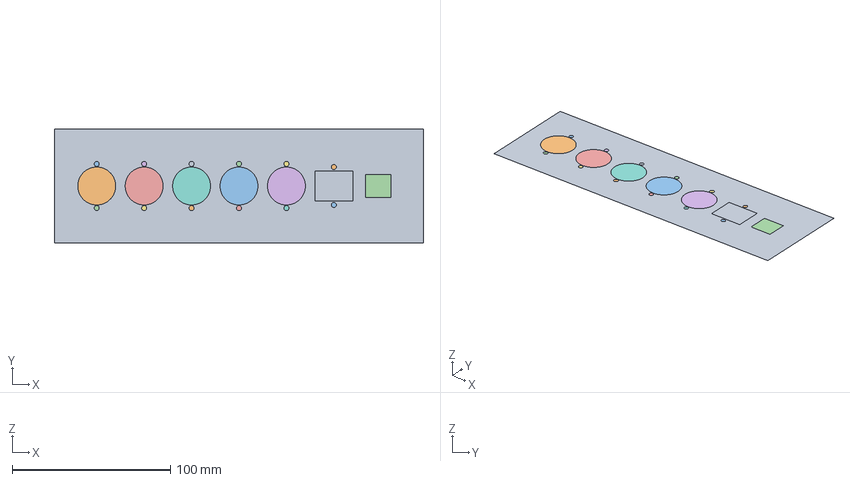
[picture p36: CAD file, 2026-06-22]
hardware/enclosure/design-brief-assembly/layout_back_panel.FCStd
233.4 x 72.2 x 0 mm
Panel_Opening_233.4x72.2
XLR_TRS_In_D-size_24.0mm
XLR_TRS_In_screw_top
XLR_TRS_In_screw_bot
Instrument_In_D-size_24.0mm
Instrument_In_screw_top
Instrument_In_screw_bot
L_Out_D-size_24.0mm
L_Out_screw_top
L_Out_screw_bot
R_Out_D-size_24.0mm
R_Out_screw_top
R_Out_screw_bot
Headphone_D-size_24.0mm
Headphone_screw_top
Headphone_screw_bot
USB-A_NAUSB3-B_D-size_24x19.2
USB-A_screw_top
USB-A_screw_bot
USB-C_Keystone_16.2x14.7
