aeobrien/DronemakerClonev3/hardware/enclosure/design-brief-assembly/layout_front_face.FCStd

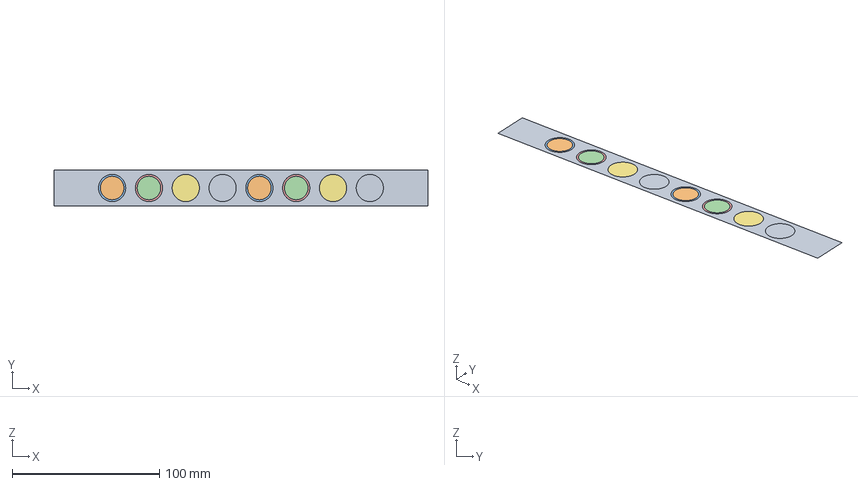
[picture p37: CAD file, 2026-06-22]
hardware/enclosure/design-brief-assembly/layout_front_face.FCStd
254.0 x 24.7 x 0 mm
Panel_Front_254x24.7
Button_1_16mm
Button_1_Cap_18.5mm_REF
Button_2_16mm
Button_2_Cap_18.5mm_REF
Button_3_16mm
Button_3_Cap_18.5mm_REF
Button_4_16mm
Button_4_Cap_18.5mm_REF
Button_5_16mm
Button_5_Cap_18.5mm_REF
Button_6_16mm
Button_6_Cap_18.5mm_REF
Button_7_16mm
Button_7_Cap_18.5mm_REF
Button_8_16mm
Button_8_Cap_18.5mm_REF
