aeobrien/DronemakerClonev3/hardware/enclosure/Faceplate_v6_fix.step

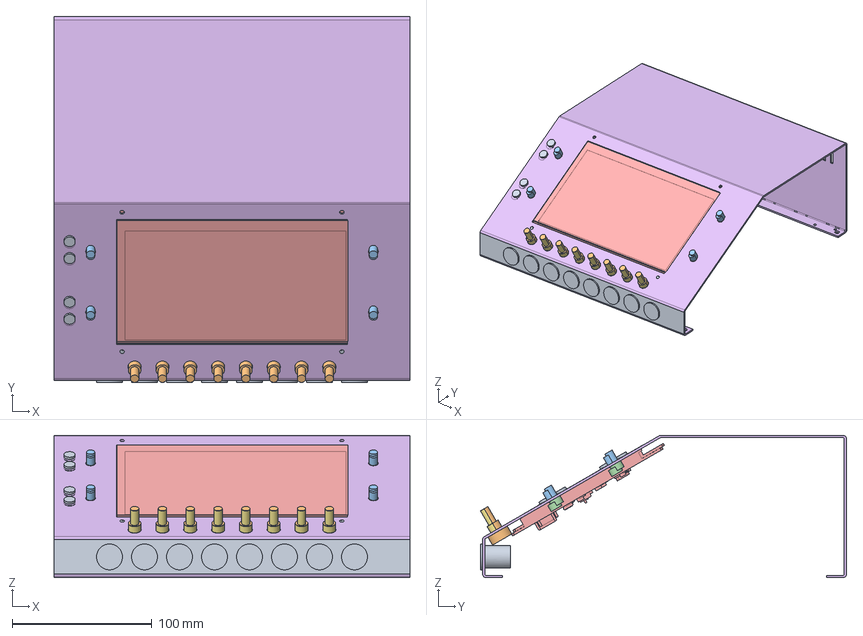
[picture p38: CAD file, 2026-06-22]
hardware/enclosure/Faceplate_v6_fix.step
254.0 x 261.4 x 101.6 mm
