aeobrien/DronemakerClonev3/hardware/enclosure/Faceplate_v9.step

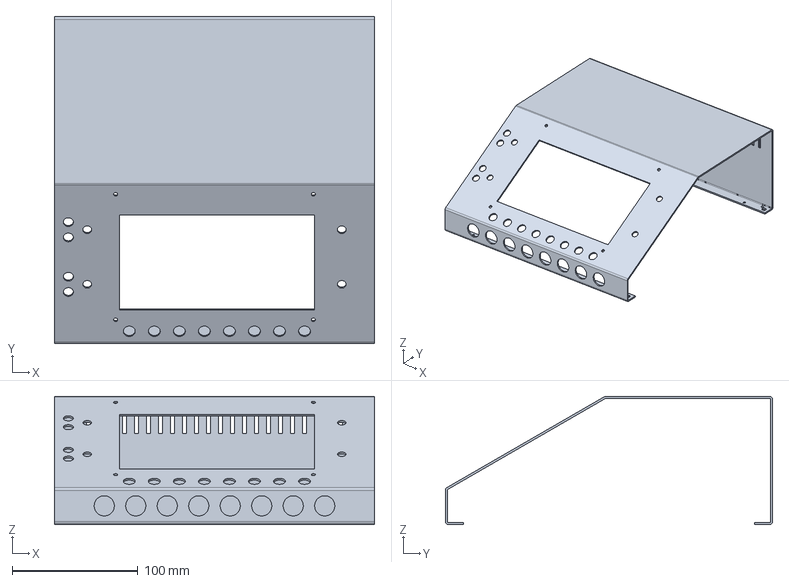
[picture p39: CAD file, 2026-06-22]
hardware/enclosure/Faceplate_v9.step
254.0 x 259.9 x 101.6 mm
