aeobrien/DronemakerClonev3/hardware/enclosure/Faceplate_v7_assembly.step

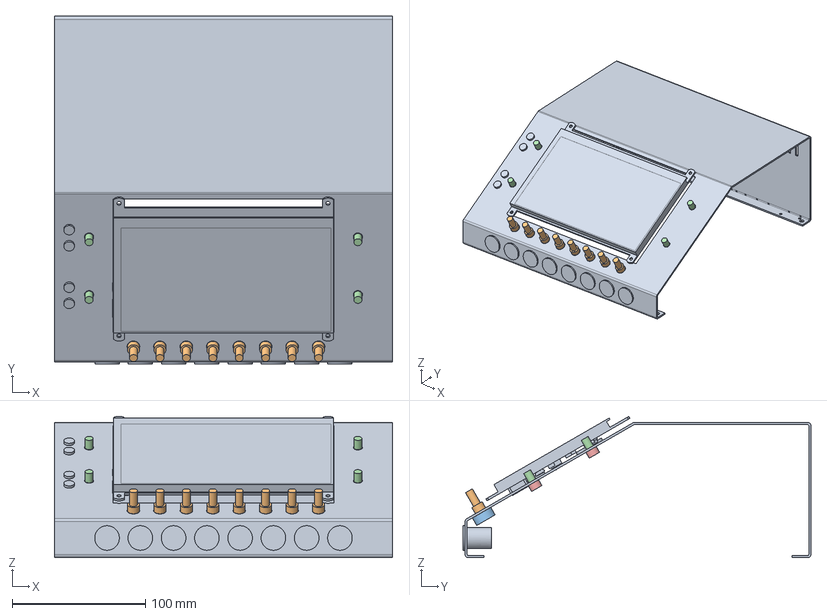
[picture p40: CAD file, 2026-06-22, an earlier design]
hardware/enclosure/Faceplate_v7_assembly.step
254.0 x 261.4 x 106.2 mm
