aeobrien/DronemakerClonev3/hardware/enclosure/Faceplate_v3_assembly.step

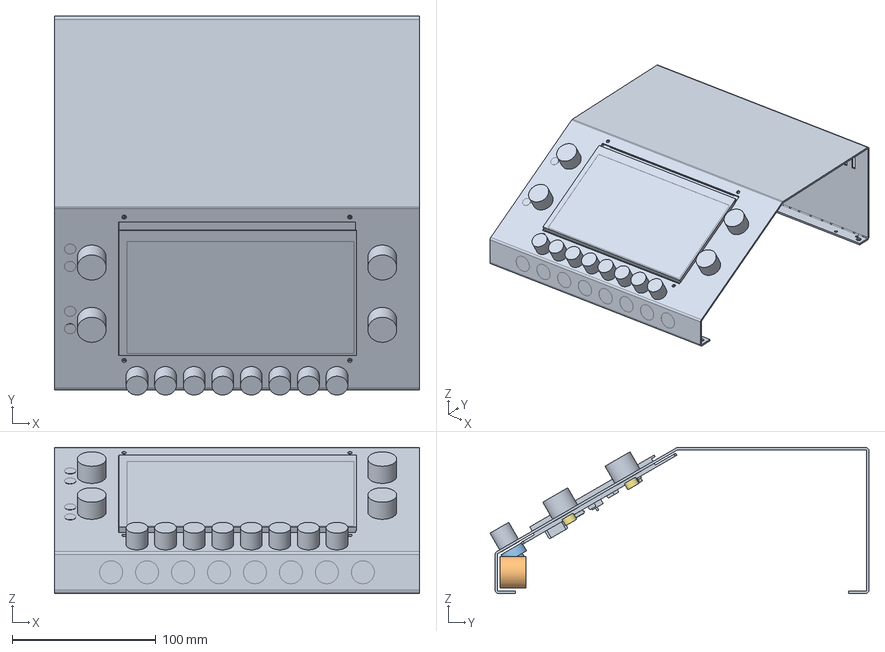
[picture p41: CAD file, 2026-06-22, an earlier design]
hardware/enclosure/Faceplate_v3_assembly.step
254.0 x 263.5 x 101.6 mm
