aeobrien/DronemakerClonev3/(list of files, cad)

Other CAD files:
hardware/enclosure/Faceplate_v3_with_components.step
hardware/enclosure/Faceplate_v4_assembly.step
hardware/enclosure/Faceplate_v1.step
hardware/enclosure/Faceplate_v2.step
hardware/enclosure/Faceplate_v2_with_components.step
hardware/enclosure/Faceplate_v3.step
hardware/enclosure/Faceplate_v4.step
hardware/enclosure/Faceplate_v5.step
hardware/enclosure/Faceplate_v5_assembly.step
hardware/enclosure/Faceplate_v6.step
hardware/enclosure/Faceplate_v6_assembly.step
hardware/enclosure/Faceplate_v7.step
hardware/enclosure/Faceplate_v8.step
hardware/enclosure/Faceplate_v8_assembly.step
hardware/enclosure/design-brief-assembly/layout_back_panel.dxf
hardware/enclosure/design-brief-assembly/layout_front_face.dxf
hardware/enclosure/design-brief-assembly/layout_slope_face.dxf
