aeobrien/DronemakerClonev3/docs/midi-controller/MIDI Controller Schematic.pdf

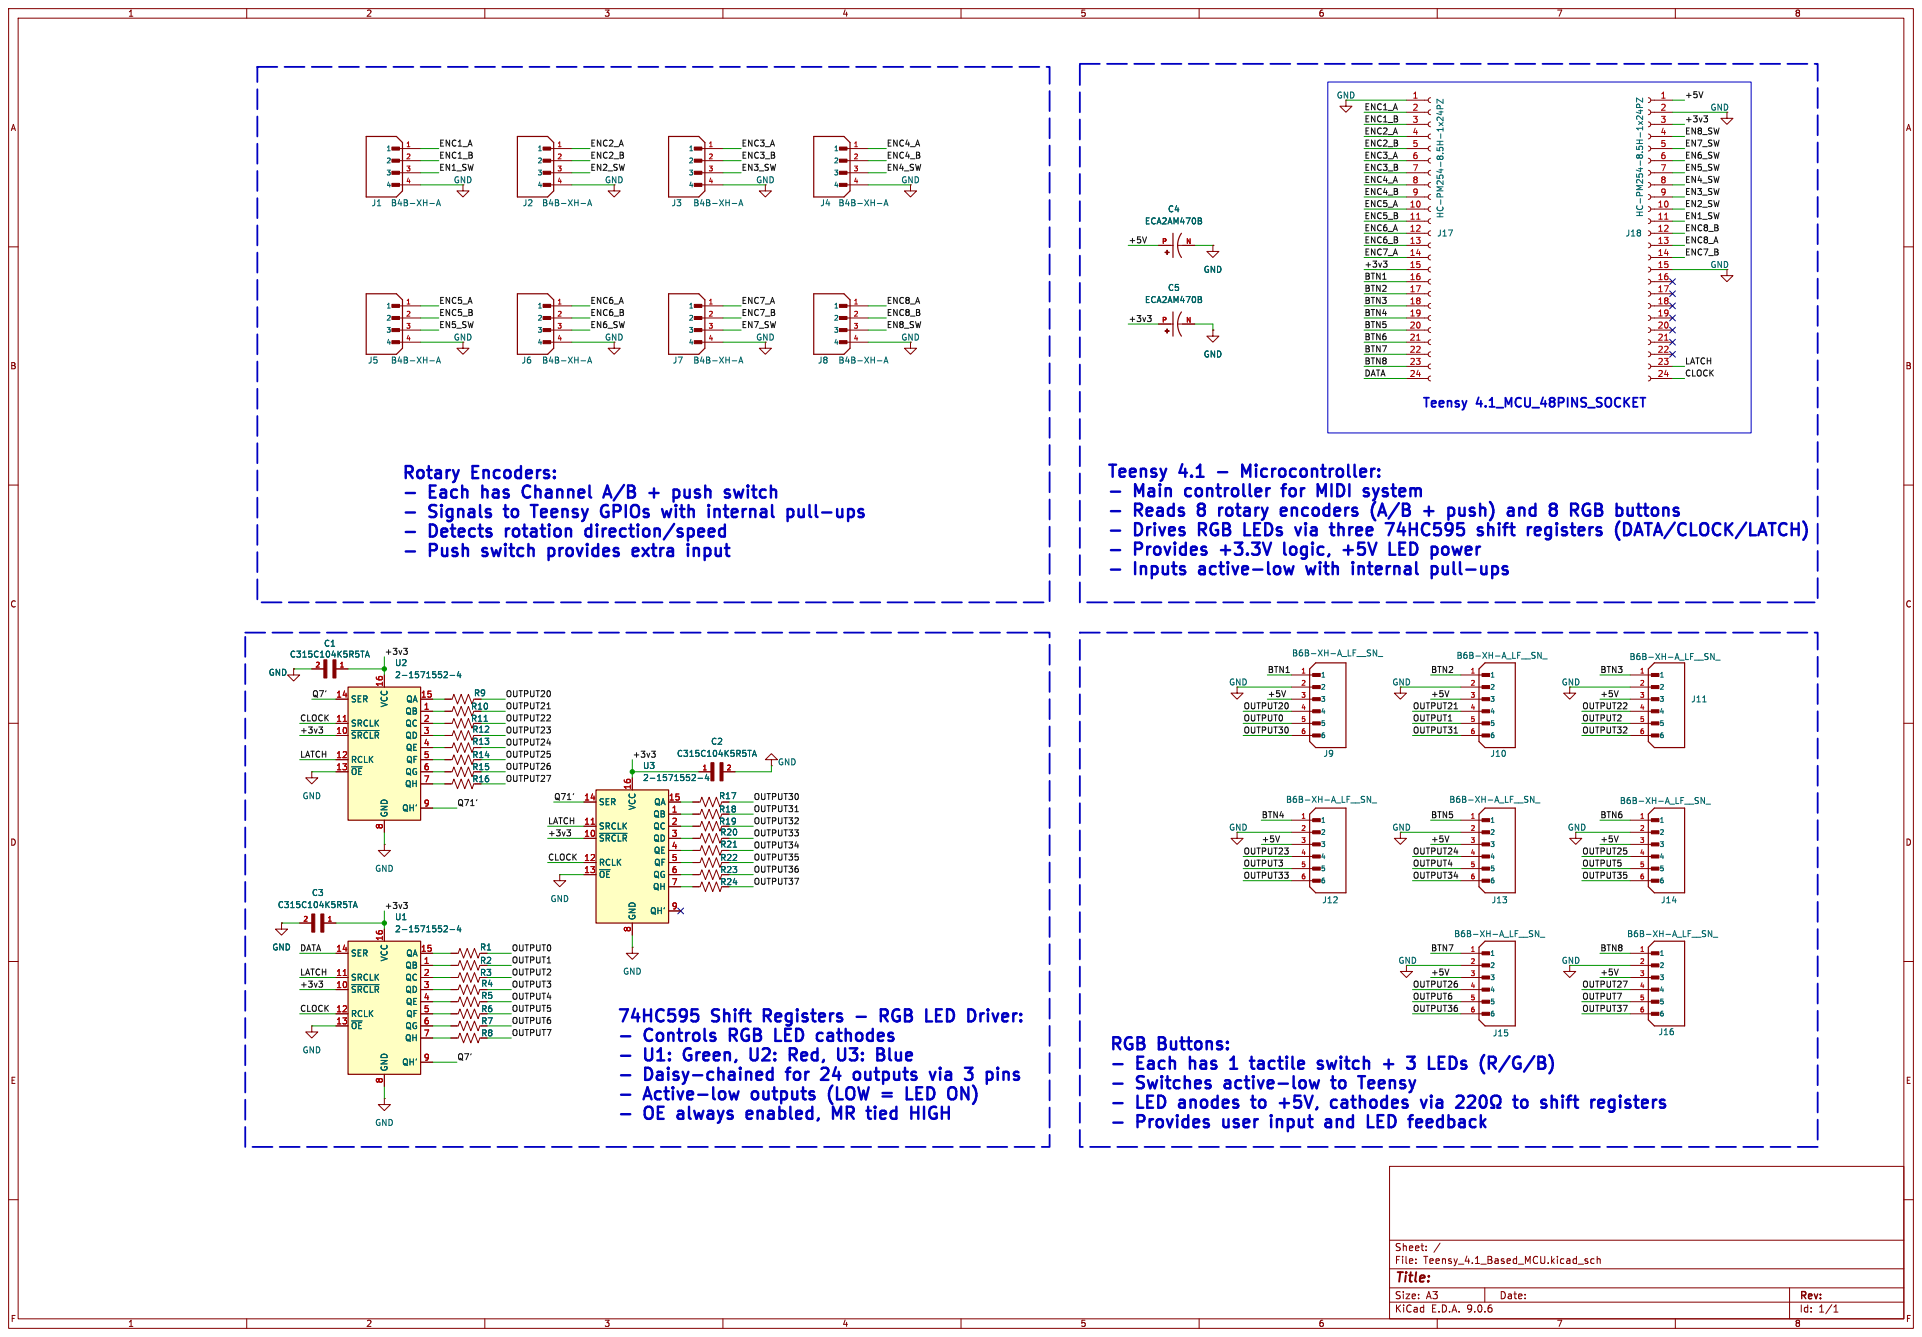
[picture p42: page 1]

Teensy 4.1 - Microcontroller:
- Reads 8 rotary encoders (A/B + push) and 8 RGB buttons
- Provides +3.3V logic, +5V LED power

Rotary Encoders:
- Each has Channel A/B + push switch
- Signals to Teensy GPIOs with internal pull-ups
- Detects rotation direction/speed
- Push switch provides extra input
+3v3 +3v3 CLOCK

8 QA 15 QB 1 QC 2 QD 3 QE 4 QF 5 QG 6 QH 7 QH' 9 GND

2-1571552-4 GND

- Controls RGB LED cathodes
- U1: Green, U2: Red, U3: Blue
- OE always enabled, MR tied HIGH

RGB Buttons:
- Each has 1 tactile switch + 3 LEDs (R/G/B)
- LED anodes to +5V, cathodes via þÿ220©to shift registers
- Provides user input and LED feedback

Id: 1/1 Title: File: Teensy_4.1_Based_MCU.kicad_sch Sheet: /
