aeobrien/DronemakerClonev3/hardware/midi-controller/Teensy_4.1_Based_MCU.kicad_pcb

## KiCad design hardware/midi-controller/Teensy_4.1_Based_MCU.kicad_pcb (2026-06-22)

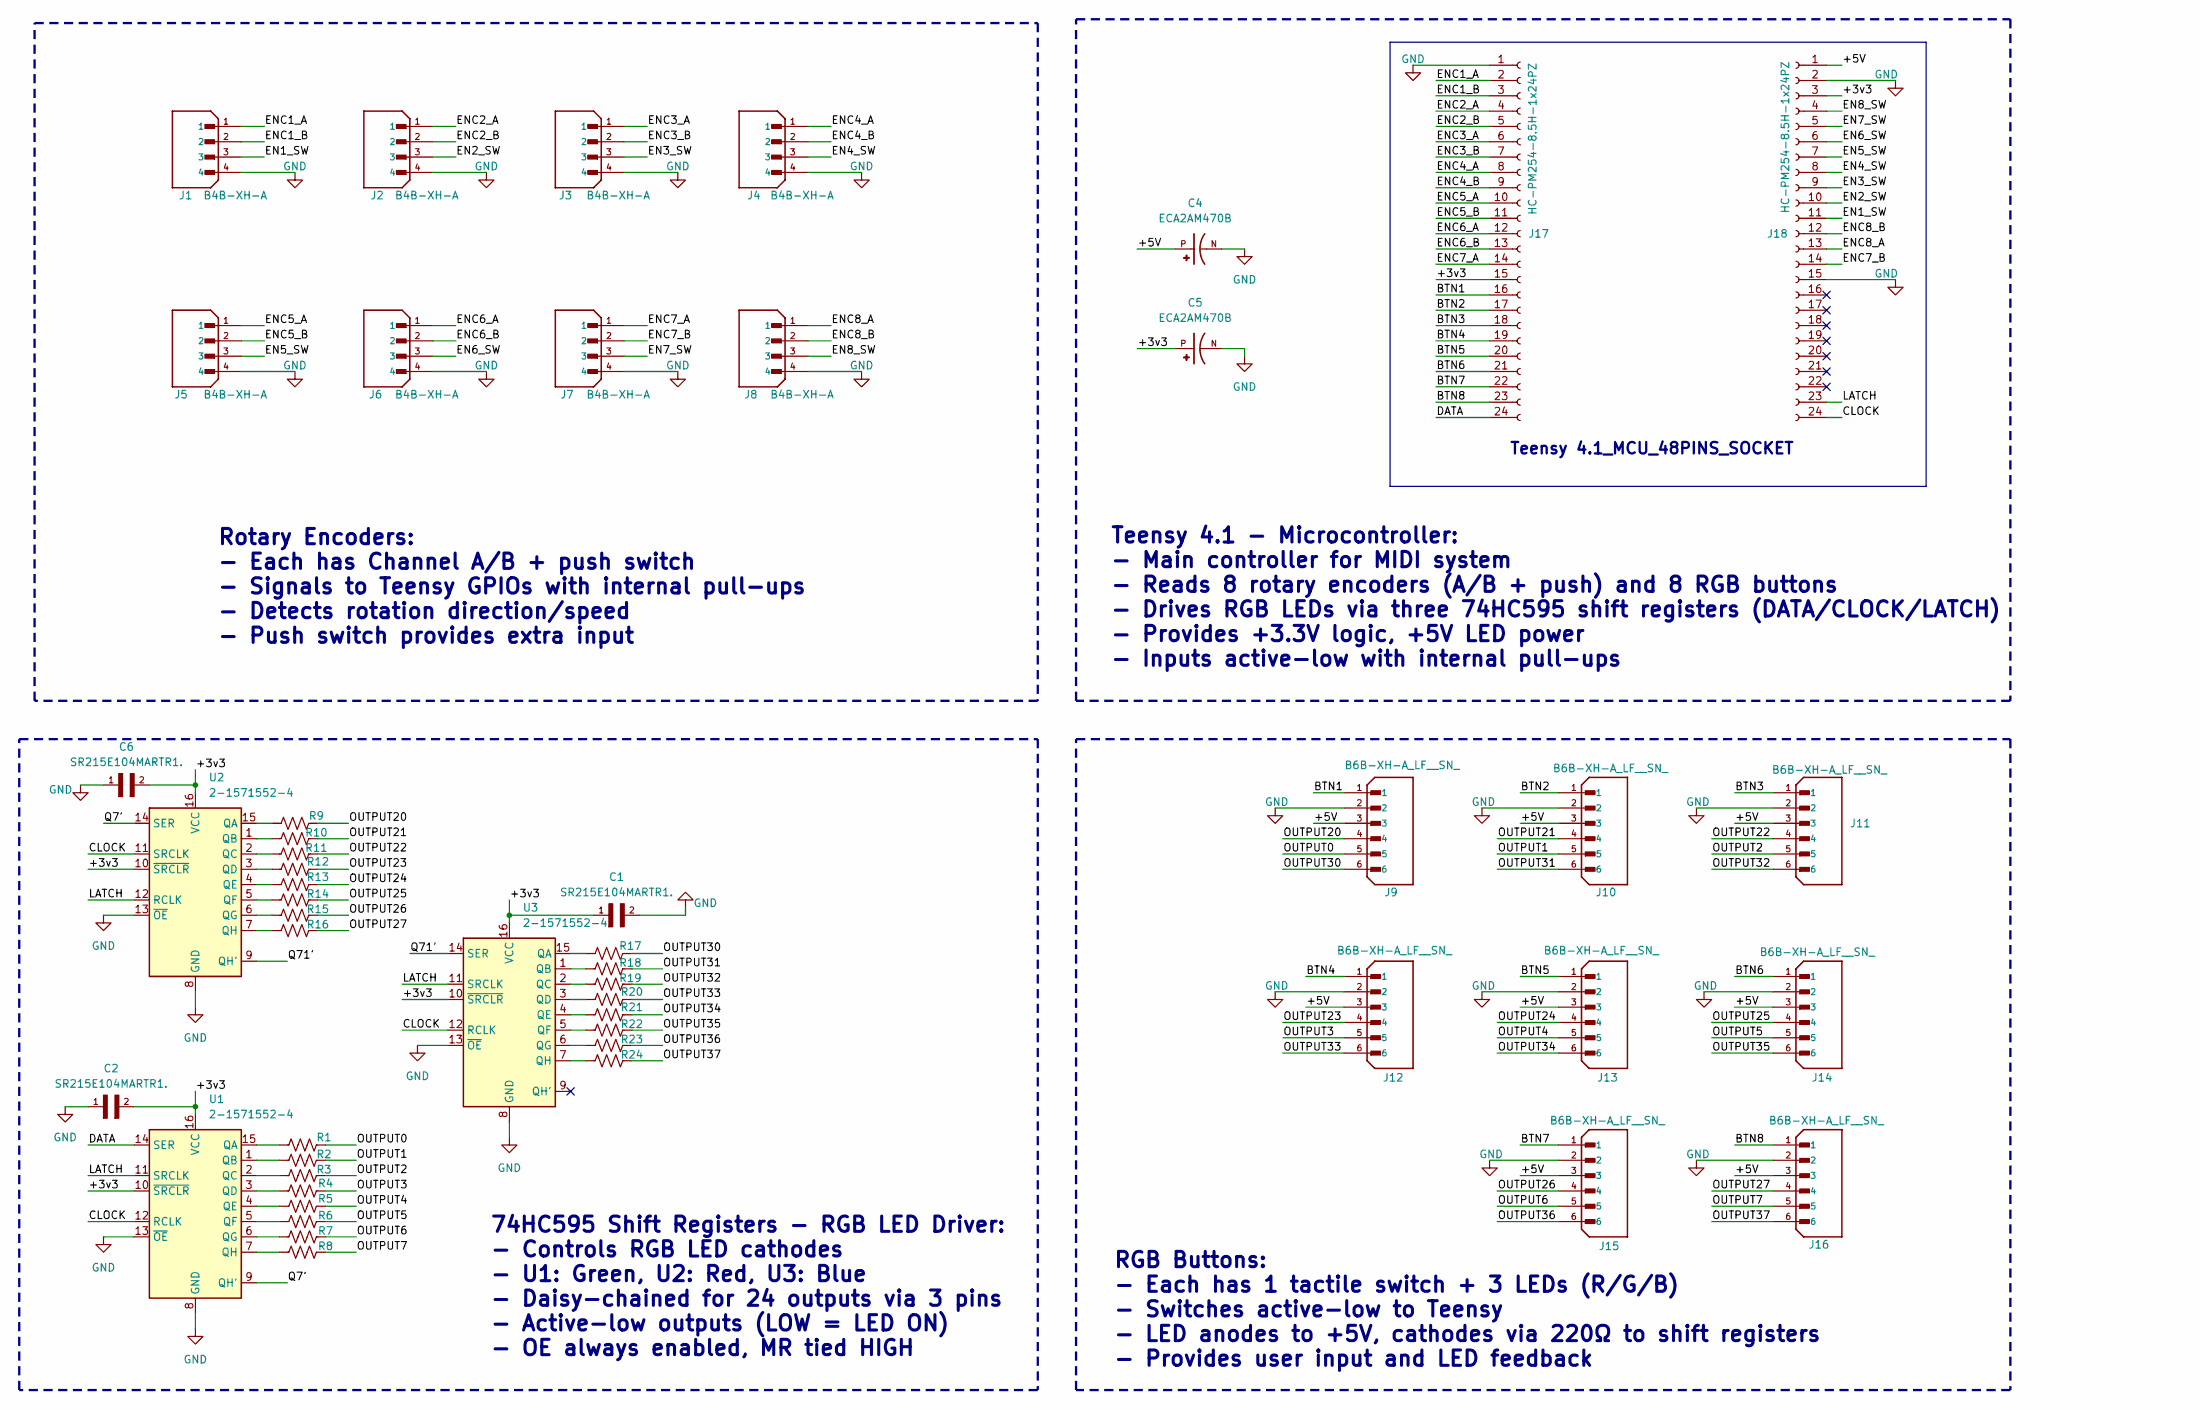
[picture p43: schematic Teensy_4.1_Based_MCU.kicad_sch]

Parts:
C1, C2, C6: SR215E104MARTR1.; CAPRR508W50L508T317H508; PARTREV 081816
C4, C5: ECA2AM470B; CAPPRD500W60D1000H2000; PARTREV 20-DEC-19
J1, J2, J3, J4, J5, J6, J7, J8: B4B-XH-A; JST_B4B-XH-A; PARTREV 7/4/21
J9, J10, J11, J12, J13, J14, J15, J16: B6B-XH-A_LF__SN_; JST_B6B-XH-A; PARTREV 7/4/21
J17, J18: HC-PM254-8.5H-1x24PZ; PinSocket_1x24_P2.54mm_Vertical
R1, R2, R3, R4, R5, R6, R7, R8, R9, R10, R11, R12, R13, R14, R15, R16, R17, R18, R19, R20, R21, R22, R23, R24: 220R; R_Axial_DIN0207_L6.3mm_D2.5mm_P10.16mm_Horizontal
U1, U2, U3: 2-1571552-4; DIP-16_W7.62mm_Socket

Connections:
/+3v3: C1.1, C2.2, C5.P, C6.2, J17.15, J18.3, U1.10 (~SRCLR), U1.16 (VCC), U2.10 (~SRCLR), U2.16 (VCC), U3.10 (~SRCLR), U3.16 (VCC)
/+5V: C4.P, J9.3, J10.3, J11.3, J12.3, J13.3, J14.3, J15.3, J16.3, J18.1
/BTN1: J9.1, J17.16
/BTN2: J10.1, J17.17
/BTN3: J11.1, J17.18
/BTN4: J12.1, J17.19
/BTN5: J13.1, J17.20
/BTN6: J14.1, J17.21
/BTN7: J15.1, J17.22
/BTN8: J16.1, J17.23
/CLOCK: J18.24, U1.12 (RCLK), U2.11 (SRCLK), U3.12 (RCLK)
/DATA: J17.24, U1.14 (SER)
/EN1_SW: J1.3, J18.11
/EN2_SW: J2.3, J18.10
/EN3_SW: J3.3, J18.9
/EN4_SW: J4.3, J18.8
/EN5_SW: J5.3, J18.7
/EN6_SW: J6.3, J18.6
/EN7_SW: J7.3, J18.5
/EN8_SW: J8.3, J18.4
/ENC1_A: J1.1, J17.2
/ENC1_B: J1.2, J17.3
/ENC2_A: J2.1, J17.4
/ENC2_B: J2.2, J17.5
/ENC3_A: J3.1, J17.6
/ENC3_B: J3.2, J17.7
/ENC4_A: J4.1, J17.8
/ENC4_B: J4.2, J17.9
/ENC5_A: J5.1, J17.10
/ENC5_B: J5.2, J17.11
/ENC6_A: J6.1, J17.12
/ENC6_B: J6.2, J17.13
/ENC7_A: J7.1, J17.14
/ENC7_B: J7.2, J18.14
/ENC8_A: J8.1, J18.13
/ENC8_B: J8.2, J18.12
/LATCH: J18.23, U1.11 (SRCLK), U2.12 (RCLK), U3.11 (SRCLK)
/OUTPUT0: J9.5, R1.2
/OUTPUT1: J10.5, R2.2
/OUTPUT2: J11.5, R3.2
/OUTPUT3: J12.5, R4.2
/OUTPUT4: J13.5, R5.2
/OUTPUT5: J14.5, R6.2
/OUTPUT6: J15.5, R7.2
/OUTPUT7: J16.5, R8.2
/OUTPUT20: J9.4, R9.2
/OUTPUT21: J10.4, R10.2
/OUTPUT22: J11.4, R11.2
/OUTPUT23: J12.4, R12.2
/OUTPUT24: J13.4, R13.2
/OUTPUT25: J14.4, R14.2
/OUTPUT26: J15.4, R15.2
/OUTPUT27: J16.4, R16.2
/OUTPUT30: J9.6, R17.2
/OUTPUT31: J10.6, R18.2
/OUTPUT32: J11.6, R19.2
/OUTPUT33: J12.6, R20.2
/OUTPUT34: J13.6, R21.2
/OUTPUT35: J14.6, R22.2
/OUTPUT36: J15.6, R23.2
/OUTPUT37: J16.6, R24.2
/Q7': U1.9 (QH'), U2.14 (SER)
/Q71': U2.9 (QH'), U3.14 (SER)
GND: C1.2, C2.1, C4.N, C5.N, C6.1, J1.4, J2.4, J3.4, J4.4, J5.4, J6.4, J7.4, J8.4, J9.2, J10.2, J11.2, J12.2, J13.2, J14.2, J15.2, J16.2, J17.1, J18.2, J18.15, U1.8 (GND), U1.13 (~OE), U2.8 (GND), U2.13 (~OE), U3.8 (GND), U3.13 (~OE)
unnamed: R1.1, U1.15 (QA)
unnamed: R2.1, U1.1 (QB)
unnamed: R3.1, U1.2 (QC)
unnamed: R4.1, U1.3 (QD)
unnamed: R5.1, U1.4 (QE)
unnamed: R6.1, U1.5 (QF)
unnamed: R7.1, U1.6 (QG)
unnamed: R8.1, U1.7 (QH)
unnamed: R9.1, U2.15 (QA)
unnamed: R10.1, U2.1 (QB)
unnamed: R11.1, U2.2 (QC)
unnamed: R12.1, U2.3 (QD)
unnamed: R13.1, U2.4 (QE)
unnamed: R14.1, U2.5 (QF)
unnamed: R15.1, U2.6 (QG)
unnamed: R16.1, U2.7 (QH)
unnamed: R17.1, U3.15 (QA)
unnamed: R18.1, U3.1 (QB)
unnamed: R19.1, U3.2 (QC)
unnamed: R20.1, U3.3 (QD)
unnamed: R21.1, U3.4 (QE)
unnamed: R22.1, U3.5 (QF)
unnamed: R23.1, U3.6 (QG)
unnamed: R24.1, U3.7 (QH)

Notes on the sheet:
Rotary Encoders: - Each has Channel A/B + push switch - Signals to Teensy GPIOs with internal pull-ups - Detects rotation direction/speed - Push switch provides extra input
Teensy 4.1_MCU_48PINS_SOCKET
Teensy 4.1 - Microcontroller: - Main controller for MIDI system - Reads 8 rotary encoders (A/B + push) and 8 RGB buttons - Drives RGB LEDs via three 74HC595 shift registers (DATA/CLOCK/LATCH) - Provides +3.3V logic, +5V LED power - Inputs active-low with internal pull-ups
RGB Buttons: - Each has 1 tactile switch + 3 LEDs (R/G/B) - Switches active-low to Teensy - LED anodes to +5V, cathodes via 220Ω to shift registers - Provides user input and LED feedback
74HC595 Shift Registers - RGB LED Driver: - Controls RGB LED cathodes - U1: Green, U2: Red, U3: Blue - Daisy-chained for 24 outputs via 3 pins - Active-low outputs (LOW = LED ON) - OE always enabled, MR tied HIGH

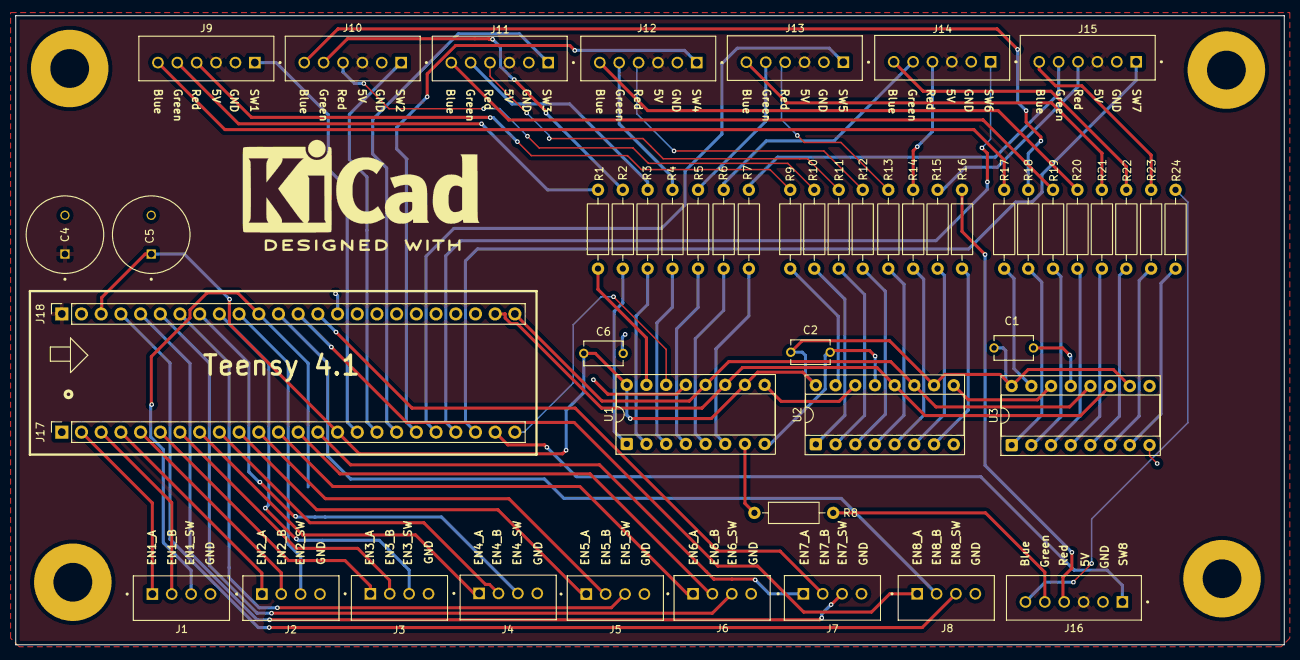
[picture p44: board Teensy_4.1_Based_MCU.kicad_pcb from above]

Board: 2 copper layers, 163.6 x 81.1 mm, 50 parts (0 on the bottom side), 88 nets.
