aeobrien/DronemakerClonev3/DronemakerClonev3/Source/MainComponent.cpp

#include "MainComponent.h"
#include <iostream>
#include "Effects/FilterEffect.h"
#include "Effects/DelayEffect.h"
#include "Effects/GranularEffect.h"
#include "Effects/TremoloEffect.h"
#include "Effects/DistortionEffect.h"
#include "Effects/TapeEffect.h"
#include "AutomationPresets.h"

MainComponent::MainComponent()
{
    // Appearance-only LookAndFeel (keeps all functionality unchanged)
    lookAndFeel = std::make_unique<MinimalLookAndFeel>();
    setLookAndFeel (lookAndFeel.get());

    // Initialize audio device
    auto err = deviceManager.initialise (1, 2, nullptr, true);
    if (err.isNotEmpty())
        DBG ("AudioDeviceManager init error: " + err);

    // Auto-select USB audio interface if available (for Pi kiosk mode)
    // Searches for Scarlett, USB, or any non-default device
    #if JUCE_LINUX
    {
        auto typeName = deviceManager.getCurrentAudioDeviceType();
        auto* currentType = deviceManager.getAvailableDeviceTypes().size() > 0
            ? deviceManager.getAvailableDeviceTypes()[0] : nullptr;
        for (auto* dt : deviceManager.getAvailableDeviceTypes())
            if (dt->getTypeName() == typeName) { currentType = dt; break; }
        if (currentType != nullptr)
        {
            currentType->scanForDevices();
            auto deviceNames = currentType->getDeviceNames();
            juce::String bestDevice;
            for (const auto& name : deviceNames)
            {
                auto lower = name.toLowerCase();
                if (lower.contains ("scarlett"))
                {
                    bestDevice = name;
                    break;  // Scarlett is the top pick
                }
                else if (lower.contains ("usb") && bestDevice.isEmpty())
                {
                    bestDevice = name;
                }
            }
            if (bestDevice.isNotEmpty())
            {
                juce::AudioDeviceManager::AudioDeviceSetup autoSetup;
                deviceManager.getAudioDeviceSetup (autoSetup);
                autoSetup.outputDeviceName = bestDevice;
                autoSetup.inputDeviceName = bestDevice;
                deviceManager.setAudioDeviceSetup (autoSetup, true);
                std::cerr << "Auto-selected audio device: " << bestDevice << std::endl;
            }
        }
    }
    #endif

    // Set default buffer size and ensure input channel is enabled
    juce::AudioDeviceManager::AudioDeviceSetup setup;
    deviceManager.getAudioDeviceSetup (setup);
    setup.bufferSize = 2048;
    setup.inputChannels.setBit (0);
    deviceManager.setAudioDeviceSetup (setup, true);

    deviceManager.addAudioCallback (this);

    // Settings button
    settingsButton.onClick = [this] {
        auto* dialog = new SettingsDialog (deviceManager);
        juce::DialogWindow::LaunchOptions options;
        options.content.setOwned (dialog);
        options.dialogTitle = "Audio Settings";
        options.dialogBackgroundColour = juce::Colour (0xff2a2b31);
        options.escapeKeyTriggersCloseButton = true;
        options.useNativeTitleBar = true;
        options.resizable = false;
        options.launchAsync();
    };
    addAndMakeVisible (settingsButton);

    // Resources button
    resourcesButton.onClick = [this] {
        auto* monitor = new ResourceMonitor (cpuLoad);
        juce::DialogWindow::LaunchOptions options;
        options.content.setOwned (monitor);
        options.dialogTitle = "System Resources";
        options.dialogBackgroundColour = juce::Colour (0xff1a1a2e);
        options.escapeKeyTriggersCloseButton = true;
        options.useNativeTitleBar = true;
        options.resizable = false;
        options.launchAsync();
    };
    addAndMakeVisible (resourcesButton);

    // Master bypass button (starts active/red since bypass is on by default)
    bypassButton.setColour (juce::TextButton::buttonColourId, juce::Colours::red);
    bypassButton.onClick = [this] {
        bool newState = !masterBypass.load();
        masterBypass.store (newState);
        if (usePiLayout)
        {
            bypassButton.setButtonText (newState ? "OFF" : "ON");
            bypassButton.setColour (juce::TextButton::buttonColourId,
                                     newState ? PiColours::recording.withAlpha (0.3f) : PiColours::buttonBg);
            bypassButton.setColour (juce::TextButton::textColourOffId,
                                     newState ? PiColours::recording : PiColours::textNormal);
        }
        else
        {
            bypassButton.setColour (juce::TextButton::buttonColourId,
                                     newState ? juce::Colours::red : juce::Colour (0xff2a2b31));
        }
    };
    addAndMakeVisible (bypassButton);

    // MIDI Learn button
    midiLearnButton.setColour (juce::TextButton::buttonColourId, juce::Colour (0xff2a2b31));
    midiLearnButton.onClick = [this] {
        toggleMidiLearnMode();
    };
    addAndMakeVisible (midiLearnButton);

    // Tab buttons for Drone/Loops/Modulation sections
    auto updateTabColors = [this] {
        droneTabButton.setColour (juce::TextButton::buttonColourId,
            activeTab == 0 ? juce::Colour (0xff5dd6c6).withAlpha (0.3f) : juce::Colour (0xff2a2b31));
        loopsTabButton.setColour (juce::TextButton::buttonColourId,
            activeTab == 1 ? juce::Colour (0xff5dd6c6).withAlpha (0.3f) : juce::Colour (0xff2a2b31));
        modulationTabButton.setColour (juce::TextButton::buttonColourId,
            activeTab == 2 ? juce::Colour (0xff5dd6c6).withAlpha (0.3f) : juce::Colour (0xff2a2b31));
    };

    droneTabButton.onClick = [this, updateTabColors] {
        activeTab = 0;
        updateTabColors();
        resized();
    };
    addAndMakeVisible (droneTabButton);

    loopsTabButton.onClick = [this, updateTabColors] {
        activeTab = 1;
        updateTabColors();
        resized();
    };
    addAndMakeVisible (loopsTabButton);

    modulationTabButton.onClick = [this, updateTabColors] {
        activeTab = 2;
        updateTabColors();
        resized();
    };
    addAndMakeVisible (modulationTabButton);

    updateTabColors();  // Set initial colors

    // Create modulation panel
    modulationPanel = std::make_unique<ModulationPanel> (modulationManager);
    addAndMakeVisible (modulationPanel.get());

    // Master volume knob
    masterVolumeKnob.setSliderStyle (juce::Slider::RotaryHorizontalVerticalDrag);
    masterVolumeKnob.setTextBoxStyle (juce::Slider::NoTextBox, false, 0, 0);
    masterVolumeKnob.setRange (0.0, 1.5, 0.01);  // Allow boost up to 150%
    masterVolumeKnob.setValue (1.0);
    masterVolumeKnob.onValueChange = [this] {
        masterVolume.store ((float) masterVolumeKnob.getValue());
    };
    masterVolumeKnob.onDragStart = [this]() {
        if (midiLearnActive.load())
            selectControlForMidiLearn (&masterVolumeKnob);
    };
    addAndMakeVisible (masterVolumeKnob);
    masterVolumeLabel.setText ("Master", juce::dontSendNotification);
    masterVolumeLabel.setVisible (false);  // Will be drawn rotated

    // Enable MIDI input for all available devices (also re-scanned periodically in timerCallback)
    refreshMidiInputs();

    // ===== DRONE SECTION =====
    // Helper for knobs with rotated labels (no value display)
    // Labels will be drawn rotated in paint(), so we don't make them visible
    auto setupRotatedKnob = [this](juce::Slider& knob, juce::Label& label, const juce::String& name,
                                    double min, double max, double step, double initial) {
        knob.setSliderStyle (juce::Slider::RotaryHorizontalVerticalDrag);
        knob.setTextBoxStyle (juce::Slider::NoTextBox, false, 0, 0);
        knob.setRange (min, max, step);
        knob.setValue (initial);

        // MIDI learn click support
        knob.onDragStart = [this, &knob]() {
            if (midiLearnActive.load())
                selectControlForMidiLearn (&knob);
        };

        addAndMakeVisible (knob);

        // Store label text but don't show it - we'll draw it rotated
        label.setText (name, juce::dontSendNotification);
        label.setVisible (false);
    };

    setupRotatedKnob (dryWetKnob, dryWetLabel, "Dry/Wet", 0.0, 1.0, 0.01, 0.2);
    dryWetKnob.onValueChange = [this] {
        float v = (float) dryWetKnob.getValue();
        fftProcessorL.setInterpFactor (v);
        fftProcessorR.setInterpFactor (v);
    };

    setupRotatedKnob (smoothingKnob, smoothingLabel, "Smooth", 0.01, 0.5, 0.01, 0.05);
    smoothingKnob.onValueChange = [this] {
        float v = (float) smoothingKnob.getValue();
        fftProcessorL.setSmoothingFactor (v);
        fftProcessorR.setSmoothingFactor (v);
    };

    setupRotatedKnob (thresholdKnob, thresholdLabel, "Thresh", 0.0, 0.01, 0.0001, 0.001);
    thresholdKnob.onValueChange = [this] {
        float v = (float) thresholdKnob.getValue();
        fftProcessorL.setThreshold (v);
        fftProcessorR.setThreshold (v);
    };

    setupRotatedKnob (tiltKnob, tiltLabel, "Tilt", -6.0, 6.0, 0.1, 0.0);
    tiltKnob.onValueChange = [this] {
        float v = (float) tiltKnob.getValue();
        fftProcessorL.setSpectralTilt (v);
        fftProcessorR.setSpectralTilt (v);
    };

    setupRotatedKnob (delayKnob, delayLabel, "Delay", 0.0, 1.0, 0.01, 0.0);
    delayKnob.onValueChange = [this] {
        float v = (float) delayKnob.getValue();
        fftProcessorL.setDroneDelay (v);
        fftProcessorR.setDroneDelay (v);
    };

    setupRotatedKnob (decayKnob, decayLabel, "Decay", 0.99, 1.0, 0.0001, 1.0);
    decayKnob.onValueChange = [this] {
        float v = (float) decayKnob.getValue();
        fftProcessorL.setDecayRate (v);
        fftProcessorR.setDecayRate (v);
    };

    setupRotatedKnob (historyKnob, historyLabel, "History", 0.5, 10.0, 0.1, 4.5);
    historyKnob.onValueChange = [this] {
        float v = (float) historyKnob.getValue();
        fftProcessorL.setHistorySeconds (v);
        fftProcessorR.setHistorySeconds (v);
    };

    setupRotatedKnob (stereoWidthKnob, stereoWidthLabel, "Stereo", 0.0, 1.0, 0.01, 1.0);
    stereoWidthKnob.onValueChange = [this] {
        stereoWidth.store ((float) stereoWidthKnob.getValue());
    };

    peakToggle.setToggleState (true, juce::dontSendNotification);
    peakToggle.onClick = [this] {
        bool v = peakToggle.getToggleState();
        fftProcessorL.setUsePeakAmplitudes (v);
        fftProcessorR.setUsePeakAmplitudes (v);
    };
    addAndMakeVisible (peakToggle);

    phaseToggle.setToggleState (true, juce::dontSendNotification);
    phaseToggle.onClick = [this] {
        bool v = phaseToggle.getToggleState();
        fftProcessorL.setRandomizePhases (v);
        fftProcessorR.setRandomizePhases (v);
    };
    addAndMakeVisible (phaseToggle);

    // ===== PITCH SECTION (now part of Drone column) =====
    // Pitch knobs with rotated labels and value display
    pitchKnob.setSliderStyle (juce::Slider::RotaryHorizontalVerticalDrag);
    pitchKnob.setTextBoxStyle (juce::Slider::TextBoxBelow, false, 50, 14);
    pitchKnob.setRange (-24.0, 24.0, 0.1);
    pitchKnob.setValue (0.0);
    pitchKnob.setTextValueSuffix (" st");
    pitchKnob.onValueChange = [this] {
        float v = (float) pitchKnob.getValue();
        fftProcessorL.setPitchShiftSemitones (v);
        fftProcessorR.setPitchShiftSemitones (v);
    };
    pitchKnob.onDragStart = [this]() {
        if (midiLearnActive.load())
            selectControlForMidiLearn (&pitchKnob);
    };
    addAndMakeVisible (pitchKnob);
    pitchLabel.setText ("Semitones", juce::dontSendNotification);
    pitchLabel.setVisible (false);  // Will be drawn rotated

    octaveKnob.setSliderStyle (juce::Slider::RotaryHorizontalVerticalDrag);
    octaveKnob.setTextBoxStyle (juce::Slider::TextBoxBelow, false, 50, 14);
    octaveKnob.setRange (-4.0, 4.0, 1.0);
    octaveKnob.setValue (0.0);
    octaveKnob.setTextValueSuffix (" oct");
    octaveKnob.onValueChange = [this] {
        float v = (float) octaveKnob.getValue();
        fftProcessorL.setPitchShiftOctaves (v);
        fftProcessorR.setPitchShiftOctaves (v);
    };
    octaveKnob.onDragStart = [this]() {
        if (midiLearnActive.load())
            selectControlForMidiLearn (&octaveKnob);
    };
    addAndMakeVisible (octaveKnob);
    octaveLabel.setText ("Octaves", juce::dontSendNotification);
    octaveLabel.setVisible (false);  // Will be drawn rotated

    // Live/Loop mix knob (in drone section, same row as pitch)
    loopMixKnob.setSliderStyle (juce::Slider::RotaryHorizontalVerticalDrag);
    loopMixKnob.setTextBoxStyle (juce::Slider::NoTextBox, false, 0, 0);
    loopMixKnob.setRange (0.0, 1.0, 0.01);
    loopMixKnob.setValue (0.0);
    loopMixKnob.onValueChange = [this] {
        loopMix.store ((float) loopMixKnob.getValue());
    };
    loopMixKnob.onDragStart = [this]() {
        if (midiLearnActive.load())
            selectControlForMidiLearn (&loopMixKnob);
    };
    addAndMakeVisible (loopMixKnob);
    loopMixLabel.setText ("Live/Loop", juce::dontSendNotification);
    loopMixLabel.setVisible (false);  // Will be drawn rotated

    // ===== LOOPS SECTION =====

    // Per-loop controls
    for (int i = 0; i < 8; ++i)
    {
        // Volume slider (vertical slider)
        loopVolumeSliders[i].setSliderStyle (juce::Slider::LinearVertical);
        loopVolumeSliders[i].setTextBoxStyle (juce::Slider::NoTextBox, false, 0, 0);
        loopVolumeSliders[i].setRange (0.0, 1.0, 0.01);
        loopVolumeSliders[i].setValue (1.0);
        loopVolumeSliders[i].onValueChange = [this, i] {
            loopRecorder.setSlotVolume (i, (float) loopVolumeSliders[i].getValue());
        };
        loopVolumeSliders[i].onDragStart = [this, i]() {
            if (midiLearnActive.load())
                selectControlForMidiLearn (&loopVolumeSliders[i]);
        };
        addAndMakeVisible (loopVolumeSliders[i]);

        loopVolumeLabels[i].setText ("Vol", juce::dontSendNotification);
        loopVolumeLabels[i].setJustificationType (juce::Justification::centred);
        loopVolumeLabels[i].setFont (juce::Font (9.0f));
        loopVolumeLabels[i].setColour (juce::Label::textColourId, juce::Colours::lightgrey);
        addAndMakeVisible (loopVolumeLabels[i]);

        // High-pass knob with frequency display
        loopHPSliders[i].setSliderStyle (juce::Slider::RotaryHorizontalVerticalDrag);
        loopHPSliders[i].setTextBoxStyle (juce::Slider::NoTextBox, false, 0, 0);
        loopHPSliders[i].setRange (20.0, 2000.0, 1.0);
        loopHPSliders[i].setSkewFactorFromMidPoint (200.0);
        loopHPSliders[i].setValue (20.0);
        loopHPSliders[i].onValueChange = [this, i] {
            loopRecorder.setSlotHighPass (i, (float) loopHPSliders[i].getValue());
            int freq = (int) loopHPSliders[i].getValue();
            loopHPLabels[i].setText (juce::String (freq) + " Hz", juce::dontSendNotification);
        };
        loopHPSliders[i].onDragStart = [this, i]() {
            if (midiLearnActive.load())
                selectControlForMidiLearn (&loopHPSliders[i]);
        };
        addAndMakeVisible (loopHPSliders[i]);

        loopHPLabels[i].setText ("20 Hz", juce::dontSendNotification);
        loopHPLabels[i].setJustificationType (juce::Justification::centred);
        loopHPLabels[i].setFont (juce::Font (9.0f));
        loopHPLabels[i].setColour (juce::Label::textColourId, juce::Colours::lightgrey);
        addAndMakeVisible (loopHPLabels[i]);

        // Low-pass knob with frequency display
        loopLPSliders[i].setSliderStyle (juce::Slider::RotaryHorizontalVerticalDrag);
        loopLPSliders[i].setTextBoxStyle (juce::Slider::NoTextBox, false, 0, 0);
        loopLPSliders[i].setRange (500.0, 20000.0, 1.0);
        loopLPSliders[i].setSkewFactorFromMidPoint (4000.0);
        loopLPSliders[i].setValue (20000.0);
        loopLPSliders[i].onValueChange = [this, i] {
            loopRecorder.setSlotLowPass (i, (float) loopLPSliders[i].getValue());
            int freq = (int) loopLPSliders[i].getValue();
            if (freq >= 1000)
                loopLPLabels[i].setText (juce::String (freq / 1000.0f, 1) + "k", juce::dontSendNotification);
            else
                loopLPLabels[i].setText (juce::String (freq) + " Hz", juce::dontSendNotification);
        };
        loopLPSliders[i].onDragStart = [this, i]() {
            if (midiLearnActive.load())
                selectControlForMidiLearn (&loopLPSliders[i]);
        };
        addAndMakeVisible (loopLPSliders[i]);

        loopLPLabels[i].setText ("20k", juce::dontSendNotification);
        loopLPLabels[i].setJustificationType (juce::Justification::centred);
        loopLPLabels[i].setFont (juce::Font (9.0f));
        loopLPLabels[i].setColour (juce::Label::textColourId, juce::Colours::lightgrey);
        addAndMakeVisible (loopLPLabels[i]);

        // Pitch selector
        loopPitchCombos[i].addItem ("-2 oct", 1);
        loopPitchCombos[i].addItem ("-1 oct", 2);
        loopPitchCombos[i].addItem ("Normal", 3);
        loopPitchCombos[i].addItem ("+1 oct", 4);
        loopPitchCombos[i].addItem ("+2 oct", 5);
        loopPitchCombos[i].setSelectedId (3);
        loopPitchCombos[i].onChange = [this, i] {
            int octave = loopPitchCombos[i].getSelectedId() - 3;  // -2, -1, 0, +1, +2
            loopRecorder.setSlotPitchOctave (i, octave);
        };
        addAndMakeVisible (loopPitchCombos[i]);

        loopPitchLabels[i].setText ("Pitch", juce::dontSendNotification);
        loopPitchLabels[i].setJustificationType (juce::Justification::centred);
        loopPitchLabels[i].setFont (juce::Font (9.0f));
        loopPitchLabels[i].setColour (juce::Label::textColourId, juce::Colours::lightgrey);
        addAndMakeVisible (loopPitchLabels[i]);

        // Auto button for loop automation settings
        loopAutoButtons[i].setButtonText ("Auto");
        loopAutoButtons[i].setColour (juce::TextButton::buttonColourId, juce::Colour (0xff2a2b31));
        loopAutoButtons[i].onClick = [this, i] {
            auto* editor = new LoopAutomationEditor (loopRecorder, i);
            juce::DialogWindow::LaunchOptions options;
            options.content.setOwned (editor);
            options.dialogTitle = "Loop " + juce::String (i + 1) + " Automation";
            options.dialogBackgroundColour = juce::Colour (0xff17181d);
            options.escapeKeyTriggersCloseButton = true;
            options.useNativeTitleBar = true;
            options.resizable = false;
            options.launchAsync();
        };
        addAndMakeVisible (loopAutoButtons[i]);

        // Progress bar for loop playhead position (click to show waveform)
        loopProgressBars[i] = std::make_unique<LoopProgressBar> (loopRecorder, i);
        addAndMakeVisible (*loopProgressBars[i]);

        // Loop button
        loopButtons[i].setButtonText ("Loop " + juce::String (i + 1));
        loopButtons[i].setColour (juce::TextButton::buttonColourId, juce::Colour (0xff2a2b31));
        loopButtons[i].onClick = [this, i] {
            // In MIDI learn mode, select this button for mapping
            if (midiLearnActive.load())
            {
                selectLoopButtonForMidiLearn (i);
                return;
            }

            if (loopRecorder.isRecording() && loopRecorder.getRecordingSlot() == i)
                loopRecorder.stopRecording();
            else if (loopRecorder.isSlotActive (i))
                loopRecorder.clearSlot (i);
            else
                loopRecorder.startRecording (i);
        };
        addAndMakeVisible (loopButtons[i]);
    }

    clearLoopsButton.onClick = [this] {
        loopRecorder.clearAll();
    };
    addAndMakeVisible (clearLoopsButton);

    // ===== EFFECTS CHAIN SECTION =====
    const char* effectNames[] = { "Filter", "Delay", "Granular", "Tremolo", "Distort", "Tape" };

    for (int i = 0; i < 6; ++i)
    {
        effectButtons[i].setButtonText (effectNames[i]);
        effectButtons[i].setColour (juce::TextButton::buttonColourId, juce::Colour (0xff2a2b31));
        effectButtons[i].onClick = [this, i] {
            // Single click: select this effect and show its parameters
            // Right-click or ctrl-click: toggle enable
            if (juce::ModifierKeys::currentModifiers.isRightButtonDown() ||
                juce::ModifierKeys::currentModifiers.isCtrlDown())
            {
                // Toggle enable
                auto order = effectsChain.getOrder();
                int effectType = order[i];
                auto* effect = effectsChain.getEffect (effectType);
                if (effect)
                    effect->setEnabled (!effect->isEnabled());
                updateEffectButtonColors();
            }
            else
            {
                // Select this slot
                selectedEffectSlot = i;
                updateEffectButtonColors();
                updateEffectParameterKnobs();
            }
        };
        addAndMakeVisible (effectButtons[i]);
    }

    moveLeftButton.onClick = [this] {
        if (selectedEffectSlot > 0)
        {
            effectsChain.swapPositions (selectedEffectSlot, selectedEffectSlot - 1);
            selectedEffectSlot--;
            updateEffectButtonColors();
            updateEffectParameterKnobs();
        }
    };
    addAndMakeVisible (moveLeftButton);

    moveRightButton.onClick = [this] {
        if (selectedEffectSlot >= 0 && selectedEffectSlot < 5)
        {
            effectsChain.swapPositions (selectedEffectSlot, selectedEffectSlot + 1);
            selectedEffectSlot++;
            updateEffectButtonColors();
            updateEffectParameterKnobs();
        }
    };
    addAndMakeVisible (moveRightButton);

    // ===== EFFECT PARAMETER KNOBS =====
    for (int i = 0; i < maxParamKnobs; ++i)
    {
        paramKnobs[i].setSliderStyle (juce::Slider::RotaryHorizontalVerticalDrag);
        paramKnobs[i].setTextBoxStyle (juce::Slider::TextBoxBelow, false, 50, 14);
        paramKnobs[i].setVisible (false);

        // Capture index for MIDI learn click handling
        paramKnobs[i].onDragStart = [this, i]() {
            if (midiLearnActive.load())
            {
                selectControlForMidiLearn (&paramKnobs[i]);
            }
        };

        addAndMakeVisible (paramKnobs[i]);

        paramLabels[i].setJustificationType (juce::Justification::centred);
        paramLabels[i].setFont (juce::Font (10.0f));
        paramLabels[i].setColour (juce::Label::textColourId, juce::Colours::lightgrey);
        paramLabels[i].setVisible (false);
        addAndMakeVisible (paramLabels[i]);
    }

    for (int i = 0; i < 4; ++i)
    {
        paramCombos[i].setVisible (false);
        addAndMakeVisible (paramCombos[i]);

        paramComboLabels[i].setJustificationType (juce::Justification::centred);
        paramComboLabels[i].setFont (juce::Font (10.0f));
        paramComboLabels[i].setColour (juce::Label::textColourId, juce::Colours::lightgrey);
        paramComboLabels[i].setVisible (false);
        addAndMakeVisible (paramComboLabels[i]);

        paramToggles[i].setVisible (false);
        addAndMakeVisible (paramToggles[i]);
    }

    startTimerHz (30);

    // Detect Pi layout: use on Linux, or override with command line
    #if JUCE_LINUX
        usePiLayout = true;
    #endif
    if (juce::JUCEApplication::getCommandLineParameterArray().contains ("--pi-layout"))
        usePiLayout = true;
    if (juce::JUCEApplication::getCommandLineParameterArray().contains ("--desktop-layout"))
        usePiLayout = false;

    if (usePiLayout)
    {
        initPiLayout();
        setSize (1024, 600);
    }
    else
    {
        setSize (1000, 700);
    }

    // Initialize with Filter selected
    updateEffectButtonColors();
    updateEffectParameterKnobs();
}

MainComponent::~MainComponent()
{
    setLookAndFeel (nullptr);
    lookAndFeel.reset();

    // Clean up MIDI callbacks for all devices we registered
    for (const auto& id : knownMidiInputIds)
        deviceManager.removeMidiInputDeviceCallback (id, this);

    deviceManager.removeAudioCallback (this);
}

void MainComponent::setupKnob (juce::Slider& knob, juce::Label& label, const juce::String& name,
                                double min, double max, double step, double initial,
                                const juce::String& suffix)
{
    knob.setSliderStyle (juce::Slider::RotaryHorizontalVerticalDrag);
    knob.setTextBoxStyle (juce::Slider::TextBoxBelow, false, 52, 14);
    knob.setRange (min, max, step);
    knob.setValue (initial);
    if (suffix.isNotEmpty())
        knob.setTextValueSuffix (suffix);
    addAndMakeVisible (knob);

    label.setText (name, juce::dontSendNotification);
    label.setJustificationType (juce::Justification::centred);
    label.setFont (juce::Font (10.5f, juce::Font::plain));
    label.setColour (juce::Label::textColourId, juce::Colours::lightgrey);
    addAndMakeVisible (label);
}

void MainComponent::updateEffectButtonColors()
{
    const char* effectNames[] = { "Filter", "Delay", "Granular", "Tremolo", "Distort", "Tape" };
    auto order = effectsChain.getOrder();

    for (int i = 0; i < 6; ++i)
    {
        int effectType = order[i];
        auto* effect = effectsChain.getEffect (effectType);
        bool enabled = effect ? effect->isEnabled() : true;

        // Show effect name with enable indicator
        juce::String buttonText = effectNames[effectType];
        if (!enabled)
            buttonText = "[" + buttonText + "]";

        effectButtons[i].setButtonText (buttonText);

        if (i == selectedEffectSlot)
        {
            effectButtons[i].setColour (juce::TextButton::buttonColourId,
                usePiLayout ? PiColours::accent.withAlpha (0.25f) : juce::Colour (0xff5dd6c6));
            effectButtons[i].setColour (juce::TextButton::textColourOffId,
                usePiLayout ? PiColours::accentBright : juce::Colours::white);
        }
        else if (enabled)
        {
            effectButtons[i].setColour (juce::TextButton::buttonColourId,
                usePiLayout ? PiColours::buttonBg : juce::Colour (0xff1f2a27));
            effectButtons[i].setColour (juce::TextButton::textColourOffId,
                usePiLayout ? PiColours::textNormal : juce::Colours::white);
        }
        else
        {
            effectButtons[i].setColour (juce::TextButton::buttonColourId,
                usePiLayout ? juce::Colour (0xff14161c) : juce::Colour (0xff2a2b31));
            effectButtons[i].setColour (juce::TextButton::textColourOffId,
                usePiLayout ? PiColours::textDim : juce::Colours::white.withAlpha (0.5f));
        }
    }
}

void MainComponent::updateEffectParameterKnobs()
{
    // If we're in Pi loop mode, delegate to loop knobs instead
    if (usePiLayout && piLoopMode)
    {
        updateLoopParameterKnobs();
        return;
    }

    // Hide all existing param controls
    for (int i = 0; i < maxParamKnobs; ++i)
    {
        paramKnobs[i].setVisible (false);
        paramKnobs[i].onValueChange = nullptr;
        paramKnobs[i].textFromValueFunction = nullptr;
        paramLabels[i].setVisible (false);
    }
    for (int i = 0; i < 4; ++i)
    {
        paramCombos[i].setVisible (false);
        paramCombos[i].onChange = nullptr;
        paramCombos[i].clear();
        paramComboLabels[i].setVisible (false);
        paramToggles[i].setVisible (false);
        paramToggles[i].onClick = nullptr;
    }

    numActiveKnobs = 0;
    numActiveCombos = 0;
    numActiveToggles = 0;
    encoderBank.clearAll();

    if (selectedEffectSlot < 0)
        return;

    auto order = effectsChain.getOrder();
    int effectType = order[selectedEffectSlot];

    auto addKnob = [this](const juce::String& name, double min, double max, double step,
                          double value, std::function<void(float)> onChange, const juce::String& suffix = "") {
        if (numActiveKnobs >= maxParamKnobs) return;
        int knobIndex = numActiveKnobs;
        auto& knob = paramKnobs[knobIndex];
        auto& label = paramLabels[knobIndex];

        knob.setRange (min, max, step);
        knob.setValue (value, juce::dontSendNotification);
        knob.setTextValueSuffix (suffix);
        knob.onValueChange = [&knob, onChange] { onChange ((float) knob.getValue()); };
        knob.setVisible (true);

        label.setText (name, juce::dontSendNotification);
        label.setVisible (true);

        // Bind to virtual encoder bank for MIDI CC control
        if (knobIndex < VirtualEncoderBank::numEncoders)
        {
            encoderBank.bindEncoder (knobIndex, name, min, max, step,
                [this, knobIndex, onChange](float v) {
                    paramKnobs[knobIndex].setValue (v, juce::dontSendNotification);
                    onChange (v);
                },
                [this, knobIndex]() -> float {
                    return (float) paramKnobs[knobIndex].getValue();
                },
                suffix);
        }

        numActiveKnobs++;
    };

    // On Pi, everything is a knob. On desktop, keep combos/toggles.
    auto addCombo = [this, &addKnob](const juce::String& name, juce::StringArray items, int selectedIdx,
                           std::function<void(int)> onChange) {
        if (usePiLayout)
        {
            // Render as a discrete knob (0 to N-1), showing item name in text box
            int knobIdx = numActiveKnobs;  // capture before addKnob increments it
            addKnob (name, 0, items.size() - 1, 1, selectedIdx,
                     [onChange](float v) { onChange ((int) v); });
            paramKnobs[knobIdx].textFromValueFunction = [items](double v) {
                int idx = juce::jlimit (0, items.size() - 1, (int) v);
                return items[idx];
            };
            paramKnobs[knobIdx].updateText();
            return;
        }
        if (numActiveCombos >= 4) return;
        auto& combo = paramCombos[numActiveCombos];
        auto& label = paramComboLabels[numActiveCombos];

        combo.clear();
        for (int i = 0; i < items.size(); ++i)
            combo.addItem (items[i], i + 1);
        combo.setSelectedId (selectedIdx + 1, juce::dontSendNotification);
        combo.onChange = [&combo, onChange] { onChange (combo.getSelectedId() - 1); };
        combo.setVisible (true);

        label.setText (name, juce::dontSendNotification);
        label.setVisible (true);

        numActiveCombos++;
    };

    auto addToggle = [this, &addKnob](const juce::String& name, bool value, std::function<void(bool)> onChange) {
        if (usePiLayout)
        {
            // Render as a knob: 0 = Off, 1 = On, showing state name in text box
            int knobIdx = numActiveKnobs;
            addKnob (name, 0, 1, 1, value ? 1.0 : 0.0,
                     [onChange](float v) { onChange (v >= 0.5f); });
            paramKnobs[knobIdx].textFromValueFunction = [](double v) {
                return juce::String (v >= 0.5 ? "On" : "Off");
            };
            paramKnobs[knobIdx].updateText();
            return;
        }
        if (numActiveToggles >= 4) return;
        auto& toggle = paramToggles[numActiveToggles];

        toggle.setButtonText (name);
        toggle.setToggleState (value, juce::dontSendNotification);
        toggle.onClick = [&toggle, onChange] { onChange (toggle.getToggleState()); };
        toggle.setVisible (true);

        numActiveToggles++;
    };

    switch (effectType)
    {
        case EffectsChain::Filter:
            if (auto* fx = effectsChain.getFilter())
            {
                addKnob ("HP Freq", 20, 5000, 1, fx->getHighPassFreq(),
                         [fx](float v) { fx->setHighPassFreq (v); }, " Hz");
                addKnob ("HP Poles", 1, 8, 1, fx->getHighPassPoles(),
                         [fx](float v) { fx->setHighPassPoles ((int) v); });
                addKnob ("LP Freq", 200, 20000, 1, fx->getLowPassFreq(),
                         [fx](float v) { fx->setLowPassFreq (v); }, " Hz");
                addKnob ("LP Poles", 1, 8, 1, fx->getLowPassPoles(),
                         [fx](float v) { fx->setLowPassPoles ((int) v); });
                addKnob ("Harmonic", 0, 1, 0.01, fx->getHarmonicIntensity(),
                         [fx](float v) { fx->setHarmonicIntensity (v); });
                addToggle ("Harm On", fx->isHarmonicEnabled(),
                           [fx](bool v) { fx->setHarmonicEnabled (v); });
                addCombo ("Root", { "C", "C#", "D", "D#", "E", "F", "F#", "G", "G#", "A", "A#", "B" },
                          fx->getRootNote(), [fx](int v) { fx->setRootNote (v); });
                addCombo ("Scale", { "Oct", "5th", "Ion", "Dor", "Phr", "Lyd", "Mix", "Aeo", "Loc", "PMaj", "PMin" },
                          fx->getScaleType(), [fx](int v) { fx->setScaleType (v); });
            }
            break;

        case EffectsChain::Delay:
            if (auto* fx = effectsChain.getDelay())
            {
                addKnob ("Time", 1, 2000, 1, fx->getDelayTimeMs(),
                         [fx](float v) { fx->setDelayTimeMs (v); }, " ms");
                addKnob ("Feedback", 0, 0.95, 0.01, fx->getFeedback(),
                         [fx](float v) { fx->setFeedback (v); });
                addKnob ("Dry/Wet", 0, 1, 0.01, fx->getDryWet(),
                         [fx](float v) { fx->setDryWet (v); });
                addToggle ("Ping Pong", fx->isPingPong(),
                           [fx](bool v) { fx->setPingPong (v); });
            }
            break;

        case EffectsChain::Granular:
            if (auto* fx = effectsChain.getGranular())
            {
                addKnob ("Grain Min", 10, 2000, 1, fx->getGrainSizeMin(),
                         [fx](float v) { fx->setGrainSizeMin (v); }, " ms");
                addKnob ("Grain Max", 10, 2000, 1, fx->getGrainSizeMax(),
                         [fx](float v) { fx->setGrainSizeMax (v); }, " ms");
                addKnob ("Delay Min", 10, 4000, 1, fx->getDelayMin(),
                         [fx](float v) { fx->setDelayMin (v); }, " ms");
                addKnob ("Delay Max", 10, 4000, 1, fx->getDelayMax(),
                         [fx](float v) { fx->setDelayMax (v); }, " ms");
                addKnob ("Pitch", -24, 24, 0.1, fx->getPitch(),
                         [fx](float v) { fx->setPitch (v); }, " st");
                addKnob ("Density", 0.1, 4, 0.1, fx->getDensity(),
                         [fx](float v) { fx->setDensity (v); });
                addKnob ("Feedback", 0, 0.95, 0.01, fx->getFeedback(),
                         [fx](float v) { fx->setFeedback (v); });
                addKnob ("Dry/Wet", 0, 1, 0.01, fx->getDryWet(),
                         [fx](float v) { fx->setDryWet (v); });
            }
            break;

        case EffectsChain::Tremolo:
            if (auto* fx = effectsChain.getTremolo())
            {
                addKnob ("Rate", 0.1, 20, 0.1, fx->getRate(),
                         [fx](float v) { fx->setRate (v); }, " Hz");
                addKnob ("Depth", 0, 1, 0.01, fx->getDepth(),
                         [fx](float v) { fx->setDepth (v); });
                addCombo ("Wave", { "Sine", "Triangle", "Square" }, fx->getWaveform(),
                          [fx](int v) { fx->setWaveform (v); });
                addToggle ("Stereo", fx->isStereo(),
                           [fx](bool v) { fx->setStereo (v); });
            }
            break;

        case EffectsChain::Distortion:
            if (auto* fx = effectsChain.getDistortion())
            {
                addCombo ("Type", { "Soft", "Hard", "Fold", "Crush" }, fx->getAlgorithm(),
                          [fx](int v) { fx->setAlgorithm (v); });
                addKnob ("Drive", 1, 20, 0.1, fx->getDrive(),
                         [fx](float v) { fx->setDrive (v); });
                addKnob ("Tone", 0, 1, 0.01, fx->getTone(),
                         [fx](float v) { fx->setTone (v); });
                addKnob ("Dry/Wet", 0, 1, 0.01, fx->getDryWet(),
                         [fx](float v) { fx->setDryWet (v); });
                addKnob ("Asymmetry", -1, 1, 0.01, fx->getAsymmetry(),
                         [fx](float v) { fx->setAsymmetry (v); });
                {
                    // Pre-HP: log-scaled 0-1 normalized, mapped to 20-5000 Hz
                    const double hpMin = 20.0, hpMax = 5000.0;
                    double currentHP = fx->getPreHighPass();
                    double hpNorm = (std::log (currentHP) - std::log (hpMin)) / (std::log (hpMax) - std::log (hpMin));
                    hpNorm = juce::jlimit (0.0, 1.0, hpNorm);
                    addKnob ("Pre HP", 0, 1, 0.005, hpNorm,
                             [fx](float v) {
                                 float hz = 20.0f * std::pow (5000.0f / 20.0f, v);
                                 fx->setPreHighPass (hz);
                             });
                    paramKnobs[numActiveKnobs - 1].textFromValueFunction = [](double v) {
                        float hz = 20.0f * std::pow (5000.0f / 20.0f, (float) v);
                        int freq = (int) hz;
                        if (freq >= 1000) return juce::String (freq / 1000.0f, 1) + "k";
                        return juce::String (freq) + " Hz";
                    };
                    paramKnobs[numActiveKnobs - 1].updateText();
                }
                if (fx->getAlgorithm() == DistortionEffect::Bitcrush)
                {
                    addKnob ("Bits", 1, 16, 0.5, fx->getBitDepth(),
                             [fx](float v) { fx->setBitDepth (v); });
                    addKnob ("SR Reduce", 1, 64, 1, fx->getSampleRateReduction(),
                             [fx](float v) { fx->setSampleRateReduction (v); }, "x");
                }
            }
            break;

        case EffectsChain::Tape:
            if (auto* fx = effectsChain.getTape())
            {
                addKnob ("Saturation", 0, 2, 0.01, fx->getSaturation(),
                         [fx](float v) { fx->setSaturation (v); });
                addKnob ("Bias", 0, 1, 0.01, fx->getBias(),
                         [fx](float v) { fx->setBias (v); });
                addKnob ("Wow Rate", 0.1, 2, 0.01, fx->getWowRate(),
                         [fx](float v) { fx->setWowRate (v); }, " Hz");
                addKnob ("Wow Depth", 0, 1, 0.01, fx->getWowDepth(),
                         [fx](float v) { fx->setWowDepth (v); });
                addKnob ("Flutter Rate", 2, 15, 0.1, fx->getFlutterRate(),
                         [fx](float v) { fx->setFlutterRate (v); }, " Hz");
                addKnob ("Flutter Depth", 0, 1, 0.01, fx->getFlutterDepth(),
                         [fx](float v) { fx->setFlutterDepth (v); });
                addKnob ("HF Loss", 0, 1, 0.01, fx->getHfLoss(),
                         [fx](float v) { fx->setHfLoss (v); });
                addKnob ("Dry/Wet", 0, 1, 0.01, fx->getDryWet(),
                         [fx](float v) { fx->setDryWet (v); });
            }
            break;
    }

    resized();
}

void MainComponent::updateEffectParameterModulation()
{
    if (selectedEffectSlot < 0)
        return;

    auto order = effectsChain.getOrder();
    int effectType = order[selectedEffectSlot];

    // Define which knobs map to which modulation targets for each effect
    // The order must match the order knobs are added in updateEffectParameterKnobs()
    switch (effectType)
    {
        case EffectsChain::Filter:
        {
            // HP Freq, HP Poles, LP Freq, LP Poles, Harmonic
            if (numActiveKnobs > 0)
            {
                bool hpMod = modulationManager.isTargetModulated (ModulationTarget::Type::FilterHP);
                if (hpMod)
                {
                    float val = modulationManager.getModulatedValue (ModulationTarget::Type::FilterHP);
                    if (val >= 0.0f)
                        paramKnobs[0].setValue (val, juce::dontSendNotification);
                }
                paramKnobs[0].setEnabled (!hpMod);
            }
            if (numActiveKnobs > 2)
            {
                bool lpMod = modulationManager.isTargetModulated (ModulationTarget::Type::FilterLP);
                if (lpMod)
                {
                    float val = modulationManager.getModulatedValue (ModulationTarget::Type::FilterLP);
                    if (val >= 0.0f)
                        paramKnobs[2].setValue (val, juce::dontSendNotification);
                }
                paramKnobs[2].setEnabled (!lpMod);
            }
            if (numActiveKnobs > 4)
            {
                bool harmMod = modulationManager.isTargetModulated (ModulationTarget::Type::FilterHarmonicIntensity);
                if (harmMod)
                {
                    float val = modulationManager.getModulatedValue (ModulationTarget::Type::FilterHarmonicIntensity);
                    if (val >= 0.0f)
                        paramKnobs[4].setValue (val, juce::dontSendNotification);
                }
                paramKnobs[4].setEnabled (!harmMod);
            }
            break;
        }

        case EffectsChain::Delay:
        {
            // Time, Feedback, Dry/Wet
            if (numActiveKnobs > 0)
            {
                bool timeMod = modulationManager.isTargetModulated (ModulationTarget::Type::DelayTime);
                if (timeMod)
                {
                    float val = modulationManager.getModulatedValue (ModulationTarget::Type::DelayTime);
                    if (val >= 0.0f)
                        paramKnobs[0].setValue (val, juce::dontSendNotification);
                }
                paramKnobs[0].setEnabled (!timeMod);
            }
            if (numActiveKnobs > 1)
            {
                bool fbMod = modulationManager.isTargetModulated (ModulationTarget::Type::DelayFeedback);
                if (fbMod)
                {
                    float val = modulationManager.getModulatedValue (ModulationTarget::Type::DelayFeedback);
                    if (val >= 0.0f)
                        paramKnobs[1].setValue (val, juce::dontSendNotification);
                }
                paramKnobs[1].setEnabled (!fbMod);
            }
            if (numActiveKnobs > 2)
            {
                bool dwMod = modulationManager.isTargetModulated (ModulationTarget::Type::DelayDryWet);
                if (dwMod)
                {
                    float val = modulationManager.getModulatedValue (ModulationTarget::Type::DelayDryWet);
                    if (val >= 0.0f)
                        paramKnobs[2].setValue (val, juce::dontSendNotification);
                }
                paramKnobs[2].setEnabled (!dwMod);
            }
            break;
        }

        case EffectsChain::Tremolo:
        {
            // Rate, Depth
            if (numActiveKnobs > 0)
            {
                bool rateMod = modulationManager.isTargetModulated (ModulationTarget::Type::TremoloRate);
                if (rateMod)
                {
                    float val = modulationManager.getModulatedValue (ModulationTarget::Type::TremoloRate);
                    if (val >= 0.0f)
                        paramKnobs[0].setValue (val, juce::dontSendNotification);
                }
                paramKnobs[0].setEnabled (!rateMod);
            }
            if (numActiveKnobs > 1)
            {
                bool depthMod = modulationManager.isTargetModulated (ModulationTarget::Type::TremoloDepth);
                if (depthMod)
                {
                    float val = modulationManager.getModulatedValue (ModulationTarget::Type::TremoloDepth);
                    if (val >= 0.0f)
                        paramKnobs[1].setValue (val, juce::dontSendNotification);
                }
                paramKnobs[1].setEnabled (!depthMod);
            }
            break;
        }

        case EffectsChain::Distortion:
        {
            // Type (combo), Drive, Tone, Dry/Wet
            if (numActiveKnobs > 0)
            {
                bool driveMod = modulationManager.isTargetModulated (ModulationTarget::Type::DistortionDrive);
                if (driveMod)
                {
                    float val = modulationManager.getModulatedValue (ModulationTarget::Type::DistortionDrive);
                    if (val >= 0.0f)
                        paramKnobs[0].setValue (val, juce::dontSendNotification);
                }
                paramKnobs[0].setEnabled (!driveMod);
            }
            if (numActiveKnobs > 1)
            {
                bool toneMod = modulationManager.isTargetModulated (ModulationTarget::Type::DistortionTone);
                if (toneMod)
                {
                    float val = modulationManager.getModulatedValue (ModulationTarget::Type::DistortionTone);
                    if (val >= 0.0f)
                        paramKnobs[1].setValue (val, juce::dontSendNotification);
                }
                paramKnobs[1].setEnabled (!toneMod);
            }
            if (numActiveKnobs > 2)
            {
                bool dwMod = modulationManager.isTargetModulated (ModulationTarget::Type::DistortionDryWet);
                if (dwMod)
                {
                    float val = modulationManager.getModulatedValue (ModulationTarget::Type::DistortionDryWet);
                    if (val >= 0.0f)
                        paramKnobs[2].setValue (val, juce::dontSendNotification);
                }
                paramKnobs[2].setEnabled (!dwMod);
            }
            break;
        }

        case EffectsChain::Tape:
        {
            // Saturation, Bias, Wow Rate, Wow Depth, Flutter Rate, Flutter Depth, HF Loss, Dry/Wet
            if (numActiveKnobs > 0)
            {
                bool satMod = modulationManager.isTargetModulated (ModulationTarget::Type::TapeSaturation);
                if (satMod)
                {
                    float val = modulationManager.getModulatedValue (ModulationTarget::Type::TapeSaturation);
                    if (val >= 0.0f)
                        paramKnobs[0].setValue (val, juce::dontSendNotification);
                }
                paramKnobs[0].setEnabled (!satMod);
            }
            if (numActiveKnobs > 1)
            {
                bool biasMod = modulationManager.isTargetModulated (ModulationTarget::Type::TapeBias);
                if (biasMod)
                {
                    float val = modulationManager.getModulatedValue (ModulationTarget::Type::TapeBias);
                    if (val >= 0.0f)
                        paramKnobs[1].setValue (val, juce::dontSendNotification);
                }
                paramKnobs[1].setEnabled (!biasMod);
            }
            if (numActiveKnobs > 3)
            {
                bool wowMod = modulationManager.isTargetModulated (ModulationTarget::Type::TapeWowDepth);
                if (wowMod)
                {
                    float val = modulationManager.getModulatedValue (ModulationTarget::Type::TapeWowDepth);
                    if (val >= 0.0f)
                        paramKnobs[3].setValue (val, juce::dontSendNotification);
                }
                paramKnobs[3].setEnabled (!wowMod);
            }
            if (numActiveKnobs > 5)
            {
                bool flutMod = modulationManager.isTargetModulated (ModulationTarget::Type::TapeFlutterDepth);
                if (flutMod)
                {
                    float val = modulationManager.getModulatedValue (ModulationTarget::Type::TapeFlutterDepth);
                    if (val >= 0.0f)
                        paramKnobs[5].setValue (val, juce::dontSendNotification);
                }
                paramKnobs[5].setEnabled (!flutMod);
            }
            if (numActiveKnobs > 7)
            {
                bool dwMod = modulationManager.isTargetModulated (ModulationTarget::Type::TapeDryWet);
                if (dwMod)
                {
                    float val = modulationManager.getModulatedValue (ModulationTarget::Type::TapeDryWet);
                    if (val >= 0.0f)
                        paramKnobs[7].setValue (val, juce::dontSendNotification);
                }
                paramKnobs[7].setEnabled (!dwMod);
            }
            break;
        }

        default:
            break;
    }
}

void MainComponent::paint (juce::Graphics& g)
{
    if (usePiLayout) { paintPi (g); return; }

    // Background
    g.fillAll (juce::Colour (0xff101114));

    // Shared styling
    const auto panelFill   = juce::Colour (0xff17181d);
    const auto panelFill2  = juce::Colour (0xff1d1f26);
    const auto border      = juce::Colours::white.withAlpha (0.06f);
    const auto titleColour = juce::Colours::white.withAlpha (0.78f);
    const auto dimText     = juce::Colours::white.withAlpha (0.40f);

    auto drawPanel = [&](juce::Rectangle<int> area, const juce::String& title, bool showTitle = true)
    {
        // Keep the title strip inside the panel, but do not modify the caller's rectangle
        auto r = area;

        g.setColour (panelFill);
        g.fillRoundedRectangle (r.toFloat(), 12.0f);

        g.setColour (border);
        g.drawRoundedRectangle (r.toFloat().reduced (0.5f), 12.0f, 1.0f);

        if (showTitle && title.isNotEmpty())
        {
            // Title - centered
            auto titleArea = r.removeFromTop (24);
            g.setColour (titleColour);
            g.setFont (juce::Font (12.0f, juce::Font::bold));
            g.drawText (title.toUpperCase(), titleArea, juce::Justification::centred, false);

            // Subtle divider under title
            g.setColour (juce::Colours::white.withAlpha (0.04f));
            g.drawLine ((float) area.getX() + 10.0f,
                        (float) area.getY() + 24.0f,
                        (float) area.getRight() - 10.0f,
                        (float) area.getY() + 24.0f,
                        1.0f);
        }
    };

    // Layout mirrors resized(): header row + two columns + chain row + param row
    auto bounds = getLocalBounds().reduced (10);

    // Header visual area (buttons are laid out in resized())
    auto header = bounds.removeFromTop (40);

    // Header background strip
    {
        auto headerBg = header.toFloat();
        g.setColour (panelFill2);
        g.fillRoundedRectangle (headerBg, 12.0f);

        g.setColour (border);
        g.drawRoundedRectangle (headerBg.reduced (0.5f), 12.0f, 1.0f);
    }

    bounds.removeFromTop (5);

    // Effect parameters section at bottom (no title)
    auto paramArea = bounds.removeFromBottom (100).reduced (5);
    drawPanel (paramArea, "", false);
    bounds.removeFromBottom (5);

    // Effects chain row (no title, taller buttons)
    auto effectsArea = bounds.removeFromBottom (70).reduced (5);
    drawPanel (effectsArea, "", false);
    bounds.removeFromBottom (5);

    // Single full-width panel for active tab
    auto mainArea = bounds.reduced (5);
    if (activeTab == 0)
        drawPanel (mainArea, "Drone");
    else
        drawPanel (mainArea, "Loops");

    // Draw rotated labels for drone knobs
    g.setColour (juce::Colours::lightgrey);
    g.setFont (juce::Font (10.0f));

    auto drawRotatedLabel = [&g](const juce::Label& label) {
        if (label.getText().isEmpty()) return;
        auto bounds = label.getBounds();

        // Save graphics state
        g.saveState();

        // Move to center of label area, rotate, then draw
        float cx = bounds.getCentreX();
        float cy = bounds.getCentreY();

        g.addTransform (juce::AffineTransform::rotation (-juce::MathConstants<float>::halfPi, cx, cy));

        // Draw text centered in the rotated space
        g.drawText (label.getText(),
                    bounds.getX() - (bounds.getHeight() - bounds.getWidth()) / 2,
                    bounds.getY() + (bounds.getHeight() - bounds.getWidth()) / 2,
                    bounds.getHeight(), bounds.getWidth(),
                    juce::Justification::centred, false);

        g.restoreState();
    };

    // Drone section rotated labels (only when drone tab is active)
    if (activeTab == 0)
    {
        drawRotatedLabel (dryWetLabel);
        drawRotatedLabel (smoothingLabel);
        drawRotatedLabel (thresholdLabel);
        drawRotatedLabel (tiltLabel);
        drawRotatedLabel (delayLabel);
        drawRotatedLabel (decayLabel);
        drawRotatedLabel (historyLabel);
        drawRotatedLabel (stereoWidthLabel);
        drawRotatedLabel (pitchLabel);
        drawRotatedLabel (octaveLabel);
    }

    // Live/Loop mix label (always visible in header)
    drawRotatedLabel (loopMixLabel);

    // Master volume label (also rotated)
    drawRotatedLabel (masterVolumeLabel);

    // Input / Output meters inside the header strip (left side)
    {
        const int meterX = 16;
        int meterY = 14;
        const int meterW = 140;
        const int meterH = 10;
        const int gap = 6;

        auto drawMeter = [&](const juce::String& label, float value, juce::Colour colour)
        {
            auto bg = juce::Rectangle<float> ((float) meterX, (float) meterY, (float) meterW, (float) meterH);
            g.setColour (juce::Colours::white.withAlpha (0.06f));
            g.fillRoundedRectangle (bg, 4.0f);

            const float v = juce::jlimit (0.0f, 1.0f, value);
            auto fg = bg.withWidth (bg.getWidth() * v);

            g.setColour (colour.withAlpha (0.85f));
            g.fillRoundedRectangle (fg, 4.0f);

            g.setColour (juce::Colours::white.withAlpha (0.60f));
            g.setFont (juce::Font (10.0f, juce::Font::bold));
            g.drawText (label, meterX, meterY - 1, 30, meterH + 2, juce::Justification::centredLeft, false);

            meterY += meterH + gap;
        };

        drawMeter ("IN",  inputLevel.load(),  juce::Colour (0xff5dd6c6));
        drawMeter ("OUT", outputLevel.load(), juce::Colour (0xff7aa7ff));
    }
}

void MainComponent::resized()
{
    if (usePiLayout) { resizedPi(); return; }

    auto bounds = getLocalBounds().reduced (10);

    // Header row
    auto header = bounds.removeFromTop (35);
    header.removeFromLeft (170);  // Space for meters

    // Tab buttons (center-ish)
    droneTabButton.setBounds (header.removeFromLeft (60).reduced (2));
    header.removeFromLeft (3);
    loopsTabButton.setBounds (header.removeFromLeft (60).reduced (2));
    header.removeFromLeft (3);
    modulationTabButton.setBounds (header.removeFromLeft (50).reduced (2));
    header.removeFromLeft (15);

    // Live/Loop mix knob in header
    const int mixKnobSize = 32;
    const int mixLabelWidth = 50;
    loopMixLabel.setBounds (header.removeFromLeft (mixLabelWidth).reduced (0, 4));
    loopMixLabel.setVisible (true);  // Make visible in header
    loopMixKnob.setBounds (header.removeFromLeft (mixKnobSize).reduced (0, 2));
    header.removeFromLeft (10);

    // Right side buttons
    resourcesButton.setBounds (header.removeFromRight (80));
    header.removeFromRight (5);
    settingsButton.setBounds (header.removeFromRight (70));
    header.removeFromRight (5);
    midiLearnButton.setBounds (header.removeFromRight (85));
    header.removeFromRight (5);
    bypassButton.setBounds (header.removeFromRight (60));
    header.removeFromRight (10);

    // Master volume knob (with rotated label space to the left)
    const int masterKnobSize = 32;
    const int masterLabelWidth = 45;
    int masterX = header.getRight() - masterKnobSize - masterLabelWidth - 5;
    masterVolumeLabel.setBounds (masterX, header.getY(), masterLabelWidth, masterKnobSize);
    masterVolumeKnob.setBounds (masterX + masterLabelWidth, header.getY() + 2, masterKnobSize, masterKnobSize);

    bounds.removeFromTop (5);

    // Effect parameters section at bottom - 8 fixed slots
    auto paramArea = bounds.removeFromBottom (100).reduced (5);
    paramArea.removeFromTop (8);  // Small top padding

    // Always divide into 8 equal slots for physical knob mapping
    const int numSlots = 8;
    const int slotWidth = paramArea.getWidth() / numSlots;
    const int knobSize = 55;
    const int labelHeight = 14;

    // Position knobs in their fixed slots
    for (int i = 0; i < numActiveKnobs && i < numSlots; ++i)
    {
        int slotX = paramArea.getX() + i * slotWidth + (slotWidth - knobSize) / 2;
        paramLabels[i].setBounds (slotX, paramArea.getY(), knobSize, labelHeight);
        paramKnobs[i].setBounds (slotX, paramArea.getY() + labelHeight, knobSize, paramArea.getHeight() - labelHeight - 5);
    }

    // Position combos after knobs in their slots
    for (int i = 0; i < numActiveCombos && (numActiveKnobs + i) < numSlots; ++i)
    {
        int slot = numActiveKnobs + i;
        int slotX = paramArea.getX() + slot * slotWidth + (slotWidth - 65) / 2;
        paramComboLabels[i].setBounds (slotX, paramArea.getY(), 65, labelHeight);
        paramCombos[i].setBounds (slotX, paramArea.getY() + labelHeight + 15, 65, 22);
    }

    // Position toggles after combos in their slots
    for (int i = 0; i < numActiveToggles && (numActiveKnobs + numActiveCombos + i) < numSlots; ++i)
    {
        int slot = numActiveKnobs + numActiveCombos + i;
        int slotX = paramArea.getX() + slot * slotWidth + (slotWidth - 75) / 2;
        paramToggles[i].setBounds (slotX, paramArea.getY() + labelHeight + 15, 75, 22);
    }

    bounds.removeFromBottom (5);

    // Effects chain row (no title, taller buttons)
    auto effectsArea = bounds.removeFromBottom (70).reduced (5);
    effectsArea.removeFromTop (8);  // Small top padding

    // Move buttons on left - same size
    const int moveButtonSize = 30;
    moveLeftButton.setBounds (effectsArea.removeFromLeft (moveButtonSize).reduced (2));
    effectsArea.removeFromLeft (3);
    moveRightButton.setBounds (effectsArea.removeFromLeft (moveButtonSize).reduced (2));
    effectsArea.removeFromLeft (10);

    // Effect buttons (taller - about double height)
    const int effectWidth = (effectsArea.getWidth() - 10) / 6;
    for (int i = 0; i < 6; ++i)
    {
        effectButtons[i].setBounds (effectsArea.removeFromLeft (effectWidth).reduced (2));
    }

    bounds.removeFromBottom (5);

    // Show/hide drone controls based on active tab
    bool showDrone = (activeTab == 0);
    dryWetKnob.setVisible (showDrone);
    smoothingKnob.setVisible (showDrone);
    thresholdKnob.setVisible (showDrone);
    tiltKnob.setVisible (showDrone);
    delayKnob.setVisible (showDrone);
    decayKnob.setVisible (showDrone);
    historyKnob.setVisible (showDrone);
    stereoWidthKnob.setVisible (showDrone);
    peakToggle.setVisible (showDrone);
    phaseToggle.setVisible (showDrone);
    pitchKnob.setVisible (showDrone);
    octaveKnob.setVisible (showDrone);

    // Show/hide loop controls based on active tab
    bool showLoops = (activeTab == 1);
    for (int i = 0; i < 8; ++i)
    {
        loopButtons[i].setVisible (showLoops);
        loopAutoButtons[i].setVisible (showLoops);
        loopPitchCombos[i].setVisible (showLoops);
        loopHPSliders[i].setVisible (showLoops);
        loopHPLabels[i].setVisible (showLoops);
        loopLPSliders[i].setVisible (showLoops);
        loopLPLabels[i].setVisible (showLoops);
        loopVolumeSliders[i].setVisible (showLoops);
        loopVolumeLabels[i].setVisible (showLoops);
        if (loopProgressBars[i])
            loopProgressBars[i]->setVisible (showLoops);
    }
    clearLoopsButton.setVisible (showLoops);

    // Show/hide modulation panel based on active tab
    bool showModulation = (activeTab == 2);
    if (modulationPanel)
        modulationPanel->setVisible (showModulation);

    // Full width for active tab
    auto layoutKnobWithLabel = [&](juce::Slider& knob, juce::Label& label, juce::Rectangle<int>& area) {
        auto knobArea = area.removeFromLeft (knobSize + 4);
        label.setBounds (knobArea.removeFromTop (labelHeight));
        knob.setBounds (knobArea.reduced (2));
    };

    if (activeTab == 0)
    {
        // ===== DRONE SECTION (full width) =====
        auto droneArea = bounds.reduced (5);
        droneArea.removeFromTop (25);  // Title space

        // Layout with rotated labels to the left of knobs
        const int rotatedLabelWidth = 50;  // Width for rotated label area
        const int knobWithLabel = rotatedLabelWidth + knobSize;

        // Calculate equal spacing for 4 knobs per row
        const int numKnobsPerRow = 4;
        int droneSpacing = (droneArea.getWidth() - (numKnobsPerRow * knobWithLabel)) / (numKnobsPerRow + 1);

        auto layoutRotatedKnobs = [&](juce::Rectangle<int>& rowArea, std::initializer_list<std::pair<juce::Slider*, juce::Label*>> knobs) {
            int x = rowArea.getX() + droneSpacing;
            for (auto& [knob, label] : knobs)
            {
                // Label to the left of knob (will be drawn rotated in paint)
                label->setBounds (x, rowArea.getY(), rotatedLabelWidth, knobSize);
                knob->setBounds (x + rotatedLabelWidth, rowArea.getY(), knobSize, knobSize);
                x += knobWithLabel + droneSpacing;
            }
        };

        auto droneRow1 = droneArea.removeFromTop (knobSize + 5);
        layoutRotatedKnobs (droneRow1, {{&dryWetKnob, &dryWetLabel}, {&smoothingKnob, &smoothingLabel},
                                         {&thresholdKnob, &thresholdLabel}, {&tiltKnob, &tiltLabel}});

        auto droneRow2 = droneArea.removeFromTop (knobSize + 5);
        layoutRotatedKnobs (droneRow2, {{&delayKnob, &delayLabel}, {&decayKnob, &decayLabel},
                                         {&historyKnob, &historyLabel}, {&stereoWidthKnob, &stereoWidthLabel}});

        droneArea.removeFromTop (3);
        auto toggleRow = droneArea.removeFromTop (20);
        int toggleSpacing = (droneArea.getWidth() - 220) / 3;
        peakToggle.setBounds (toggleRow.getX() + toggleSpacing, toggleRow.getY(), 100, 18);
        phaseToggle.setBounds (toggleRow.getX() + toggleSpacing + 110, toggleRow.getY(), 120, 18);

        // Pitch controls row (Live/Loop mix is now in header)
        droneArea.removeFromTop (5);
        auto pitchRow = droneArea.removeFromTop (knobSize + labelHeight + 18);  // Extra for value display
        int pitchSpacing = (droneArea.getWidth() - 2 * knobWithLabel) / 3;
        int pitchX = pitchRow.getX() + pitchSpacing;

        // Semitones (with value display)
        pitchLabel.setBounds (pitchX, pitchRow.getY(), rotatedLabelWidth, knobSize);
        pitchKnob.setBounds (pitchX + rotatedLabelWidth, pitchRow.getY(), knobSize, knobSize + labelHeight + 4);
        pitchX += knobWithLabel + pitchSpacing;

        // Octaves (with value display)
        octaveLabel.setBounds (pitchX, pitchRow.getY(), rotatedLabelWidth, knobSize);
        octaveKnob.setBounds (pitchX + rotatedLabelWidth, pitchRow.getY(), knobSize, knobSize + labelHeight + 4);
    }
    else if (activeTab == 1)
    {
        // ===== LOOPS SECTION (full width) =====
        auto loopsArea = bounds.reduced (5);

        // Title row with Clear All button on right
        auto loopsTitleRow = loopsArea.removeFromTop (25);
        clearLoopsButton.setBounds (loopsTitleRow.removeFromRight (70).reduced (2, 3));

        loopsArea.removeFromTop (5);

        // Per-loop controls - all 8 loops in a single row
        const int loopStripWidth = loopsArea.getWidth() / 8;
        const int smallKnob = 32;

        for (int i = 0; i < 8; ++i)
        {
            auto strip = loopsArea.removeFromLeft (loopStripWidth).reduced (2, 0);

            // Progress bar at top (thin bar showing playhead position)
            loopProgressBars[i]->setBounds (strip.removeFromTop (6).reduced (1, 0));
            strip.removeFromTop (1);

            // Loop button below progress bar
            loopButtons[i].setBounds (strip.removeFromTop (22).reduced (1, 0));
            strip.removeFromTop (1);

            // Auto button directly under loop button
            loopAutoButtons[i].setBounds (strip.removeFromTop (16).reduced (2, 0));
            strip.removeFromTop (1);

            // Pitch selector directly under auto button (no label)
            loopPitchLabels[i].setVisible (false);
            loopPitchCombos[i].setBounds (strip.removeFromTop (20).reduced (2, 0));
            strip.removeFromTop (2);

            // HP knob
            loopHPLabels[i].setBounds (strip.removeFromTop (10));
            loopHPSliders[i].setBounds (strip.removeFromTop (smallKnob).reduced (4, 0));
            strip.removeFromTop (1);

            // LP knob
            loopLPLabels[i].setBounds (strip.removeFromTop (10));
            loopLPSliders[i].setBounds (strip.removeFromTop (smallKnob).reduced (4, 0));
            strip.removeFromTop (2);

            // Volume slider (vertical) - takes remaining space
            loopVolumeLabels[i].setBounds (strip.removeFromTop (10));
            loopVolumeSliders[i].setBounds (strip.reduced (8, 0));
        }
    }
    else if (activeTab == 2)
    {
        // ===== MODULATION SECTION (full width) =====
        if (modulationPanel)
            modulationPanel->setBounds (bounds.reduced (5));
    }
}

void MainComponent::audioDeviceAboutToStart (juce::AudioIODevice* device)
{
    juce::FloatVectorOperations::disableDenormalisedNumberSupport();

    const int blockSize = device->getCurrentBufferSizeSamples();
    monoBuffer.setSize (1, blockSize, false, false, true);
    monoBuffer.clear();

    currentSampleRate = device->getCurrentSampleRate();
    currentBufferSize = blockSize;

    float sr = static_cast<float>(currentSampleRate);
    fftProcessorL.setSampleRate (sr);
    fftProcessorL.reset();
    fftProcessorR.setSampleRate (sr);
    fftProcessorR.reset();

    loopRecorder.prepareToPlay (currentSampleRate, blockSize);
    effectsChain.prepareToPlay (currentSampleRate, blockSize);
    modulationManager.prepareToPlay (currentSampleRate, blockSize);

    masterVolumeSmooth.reset (currentSampleRate, 0.02);  // 20ms smoothing
    masterVolumeSmooth.setCurrentAndTargetValue (masterVolume.load());
}

void MainComponent::audioDeviceStopped()
{
}

void MainComponent::audioDeviceIOCallbackWithContext (const float* const* inputChannelData,
                                                     int numInputChannels,
                                                     float* const* outputChannelData,
                                                     int numOutputChannels,
                                                     int numSamples,
                                                     const juce::AudioIODeviceCallbackContext&)
{
    const auto startTime = juce::Time::getHighResolutionTicks();

    for (int ch = 0; ch < numOutputChannels; ++ch)
        if (auto* out = outputChannelData[ch])
            juce::FloatVectorOperations::clear (out, numSamples);

    if (numSamples <= 0 || monoBuffer.getNumSamples() < numSamples)
        return;

    float* mono = monoBuffer.getWritePointer (0);
    juce::FloatVectorOperations::clear (mono, numSamples);

    int activeInputs = 0;
    for (int ch = 0; ch < numInputChannels; ++ch)
    {
        const float* in = inputChannelData[ch];
        if (in == nullptr) continue;
        juce::FloatVectorOperations::add (mono, in, numSamples);
        ++activeInputs;
    }

    if (activeInputs > 0)
        juce::FloatVectorOperations::multiply (mono, 1.0f / (float) activeInputs, numSamples);

    if (activeInputs > 0)
    {
        float sumSquares = 0.0f;
        for (int i = 0; i < numSamples; ++i)
            sumSquares += mono[i] * mono[i];
        inputLevel.store (std::sqrt (sumSquares / (float) numSamples) * 3.0f);
    }
    else
    {
        inputLevel.store (0.0f);
    }

    float outputSum = 0.0f;
    const float width = stereoWidth.load();
    const bool isRecording = loopRecorder.isRecording();
    const bool hasLoops = loopRecorder.hasAnyContent();
    const float mix = loopMix.load();  // 0 = live only, 1 = loops only
    const bool bypassed = masterBypass.load();
    const float volume = masterVolume.load();

    // Update smoothed master volume target
    masterVolumeSmooth.setTargetValue (volume);

    // Master bypass - just pass through silence (or could pass through dry input)
    if (bypassed)
    {
        // Still update loop recording if active
        if (isRecording && activeInputs > 0)
        {
            for (int i = 0; i < numSamples; ++i)
                loopRecorder.recordSample (mono[i]);
        }
        outputLevel.store (0.0f);
        return;
    }

    if (activeInputs > 0 || hasLoops)
    {
        // Modulation mix value (may be overridden by modulation)
        float currentMix = mix;

        for (int i = 0; i < numSamples; ++i)
        {
            float fftInput = 0.0f;
            float liveSample = 0.0f;

            if (activeInputs > 0)
            {
                liveSample = mono[i];
                if (isRecording)
                    loopRecorder.recordSample (liveSample);
            }

            // Split loop output: droneSend (immediate) and dryOutput (delayed)
            auto loopOut = hasLoops ? loopRecorder.getLoopMixSplit() : LoopRecorder::LoopMixOutput{};

            // During recording, the recording slot also feeds the drone
            float recDroneSend = isRecording ? loopRecorder.getRecordingDroneSend() : 0.0f;

            // Total drone send = playback loops + recording feed
            float totalDroneSend = loopOut.droneSend + recDroneSend;

            // Feed spectrum visualiser on Pi — per-loop (post filter) or master output
            if (usePiLayout && piLoopDetail)
            {
                if (piLoopMode)
                {
                    int sel = TouchLoopButton::selectedSlot;
                    piLoopDetail->pushVisSample (loopRecorder.getSlotLastFilteredSample (sel));
                }
                // else: we'll push master output after processing below
            }

            // Crossfade between live and loops based on mix — drone send goes to FFT
            fftInput = liveSample * (1.0f - currentMix) + totalDroneSend * currentMix;

            float outL, outR;
            if (width < 0.01f)
            {
                float processed = fftProcessorL.processSample (fftInput, false);
                outL = outR = processed;
            }
            else
            {
                float processedL = fftProcessorL.processSample (fftInput, false);
                float processedR = fftProcessorR.processSample (fftInput, false);
                float mid = (processedL + processedR) * 0.5f;
                outL = mid + (processedL - mid) * width;
                outR = mid + (processedR - mid) * width;
            }

            // Sum delayed/bounced dry loop output into the drone output before effects
            outL += loopOut.dryOutputL;
            outR += loopOut.dryOutputR;

            effectsChain.processSample (outL, outR);

            // Process modulation sources (envelope follower uses raw microphone input)
            modulationManager.processSample (liveSample, liveSample);

            // Apply modulation to targets
            float loopMixMod, masterVolumeMod;
            modulationManager.applyModulation (loopRecorder, effectsChain, loopMixMod, masterVolumeMod);

            // Update mix if modulated (-1 means not modulated)
            if (loopMixMod >= 0.0f)
                currentMix = loopMixMod;
            else
                currentMix = mix;

            // Apply smoothed master volume (with optional modulation multiplier)
            float smoothedVol = masterVolumeSmooth.getNextValue();
            if (masterVolumeMod >= 0.0f)
                smoothedVol *= masterVolumeMod;

            outL *= smoothedVol;
            outR *= smoothedVol;

            // Feed master output to spectrum visualiser in effect mode
            if (usePiLayout && piLoopDetail && !piLoopMode)
                piLoopDetail->pushVisSample ((outL + outR) * 0.5f);

            outputSum += outL * outL + outR * outR;

            if (numOutputChannels >= 1 && outputChannelData[0] != nullptr)
                outputChannelData[0][i] += outL;
            if (numOutputChannels >= 2 && outputChannelData[1] != nullptr)
                outputChannelData[1][i] += outR;
        }
    }

    outputLevel.store (std::sqrt (outputSum / (float) (numSamples * 2)) * 3.0f);

    const auto endTime = juce::Time::getHighResolutionTicks();
    const double elapsedSeconds = juce::Time::highResolutionTicksToSeconds (endTime - startTime);
    const double availableSeconds = (double) numSamples / currentSampleRate;
    const float load = (float) (elapsedSeconds / availableSeconds * 100.0);
    cpuLoad.store (cpuLoad.load() * 0.9f + load * 0.1f);
}

void MainComponent::timerCallback()
{
    // Re-scan for MIDI devices every ~2 seconds (every 60 timer ticks at 30Hz)
    if (++midiRescanCounter >= 60)
    {
        midiRescanCounter = 0;
        refreshMidiInputs();
    }

    bool learnMode = midiLearnActive.load();
    bool hasSelection = midiLearnHasSelection.load();

    for (int i = 0; i < 8; ++i)
    {
        juce::Colour buttonColour;

        // In MIDI learn mode with this button selected
        if (learnMode && hasSelection && midiLearnSelected.type == MidiMapping::LoopButton && midiLearnSelected.targetIndex == i)
        {
            buttonColour = juce::Colour (0xffff9900);  // Orange for selected
        }
        else if (loopRecorder.isRecording() && loopRecorder.getRecordingSlot() == i)
        {
            recordPulseCounter = (recordPulseCounter + 1) % 15;
            float pulse = 0.7f + 0.3f * std::sin (recordPulseCounter * 0.4f);
            buttonColour = juce::Colour::fromFloatRGBA (pulse, 0.1f, 0.1f, 1.0f);
        }
        else if (loopRecorder.isSlotActive (i))
        {
            buttonColour = juce::Colours::green;
        }
        else
        {
            buttonColour = juce::Colour (0xff2a2b31);
        }

        loopButtons[i].setColour (juce::TextButton::buttonColourId, buttonColour);

        // Repaint progress bar for smooth playhead animation
        if (loopProgressBars[i])
            loopProgressBars[i]->repaint();

        // Handle volume slider automation and modulation
        bool hasLevelAutomation = loopRecorder.slotHasLevelAutomation (i);
        bool isAutomationRunning = loopRecorder.isPreviewRunning (i);
        bool volumeModulated = modulationManager.isTargetModulated (ModulationTarget::Type::LoopVolume, i);

        // If slot has level automation or modulation, move slider to show current level
        if (hasLevelAutomation || isAutomationRunning)
        {
            float autoLevel = loopRecorder.getSlotAutomationLevel (i);
            if (std::abs (loopVolumeSliders[i].getValue() - autoLevel) > 0.01)
                loopVolumeSliders[i].setValue (autoLevel, juce::dontSendNotification);
        }
        else if (volumeModulated)
        {
            float modValue = modulationManager.getModulatedValue (ModulationTarget::Type::LoopVolume, i);
            if (modValue >= 0.0f && std::abs (loopVolumeSliders[i].getValue() - modValue) > 0.01)
                loopVolumeSliders[i].setValue (modValue, juce::dontSendNotification);
        }

        // Disable manual control if slot has level automation or modulation
        loopVolumeSliders[i].setEnabled (!hasLevelAutomation && !volumeModulated);

        // Handle HP slider modulation
        bool hpModulated = modulationManager.isTargetModulated (ModulationTarget::Type::LoopFilterHP, i);
        if (hpModulated)
        {
            float modValue = modulationManager.getModulatedValue (ModulationTarget::Type::LoopFilterHP, i);
            if (modValue >= 0.0f && std::abs (loopHPSliders[i].getValue() - modValue) > 1.0)
            {
                loopHPSliders[i].setValue (modValue, juce::dontSendNotification);
                int freq = (int) modValue;
                loopHPLabels[i].setText (juce::String (freq) + " Hz", juce::dontSendNotification);
            }
        }
        loopHPSliders[i].setEnabled (!hpModulated);

        // Handle LP slider modulation
        bool lpModulated = modulationManager.isTargetModulated (ModulationTarget::Type::LoopFilterLP, i);
        if (lpModulated)
        {
            float modValue = modulationManager.getModulatedValue (ModulationTarget::Type::LoopFilterLP, i);
            if (modValue >= 0.0f && std::abs (loopLPSliders[i].getValue() - modValue) > 1.0)
            {
                loopLPSliders[i].setValue (modValue, juce::dontSendNotification);
                int freq = (int) modValue;
                if (freq >= 1000)
                    loopLPLabels[i].setText (juce::String (freq / 1000.0f, 1) + "k", juce::dontSendNotification);
                else
                    loopLPLabels[i].setText (juce::String (freq) + " Hz", juce::dontSendNotification);
            }
        }
        loopLPSliders[i].setEnabled (!lpModulated);

        // Populate indicator data for Pi layout components
        if (usePiLayout)
        {
            LoopIndicatorData ind;
            ind.active = loopRecorder.isSlotActive (i);
            ind.recording = loopRecorder.isRecording() && loopRecorder.getRecordingSlot() == i;
            ind.volume = loopRecorder.getSlotVolume (i);
            ind.hpFreq = loopRecorder.getSlotHighPass (i);
            ind.lpFreq = loopRecorder.getSlotLowPass (i);
            ind.volumeModulated = volumeModulated;
            ind.hpModulated = hpModulated;
            ind.lpModulated = lpModulated;
            ind.hasAutomation = hasLevelAutomation;
            ind.automationLevel = loopRecorder.getSlotAutomationLevel (i);
            ind.bouncing = loopRecorder.isSlotBouncing (i);
            ind.bounceProgress = (loopBouncer.activeSlot.load() == i) ? loopBouncer.progress.load() : 0.0f;
            ind.bounced = loopRecorder.isSlotBounced (i);

            if (piLoopButtons[i])
                piLoopButtons[i]->indicatorData = ind;
            if (piMiniMixer)
                piMiniMixer->loopData[(size_t) i] = ind;
            if (piMultiOverview)
                piMultiOverview->loopData[(size_t) i] = ind;
        }
    }

    // Handle Live/Loop mix modulation
    bool loopMixModulated = modulationManager.isTargetModulated (ModulationTarget::Type::LoopMix);
    if (loopMixModulated)
    {
        float modValue = modulationManager.getModulatedValue (ModulationTarget::Type::LoopMix);
        if (modValue >= 0.0f && std::abs (loopMixKnob.getValue() - modValue) > 0.01)
            loopMixKnob.setValue (modValue, juce::dontSendNotification);
    }
    loopMixKnob.setEnabled (!loopMixModulated);

    // Handle Master volume modulation
    bool masterVolumeModulated = modulationManager.isTargetModulated (ModulationTarget::Type::MasterVolume);
    if (masterVolumeModulated)
    {
        float modValue = modulationManager.getModulatedValue (ModulationTarget::Type::MasterVolume);
        if (modValue >= 0.0f && std::abs (masterVolumeKnob.getValue() - modValue) > 0.01)
            masterVolumeKnob.setValue (modValue, juce::dontSendNotification);
    }
    masterVolumeKnob.setEnabled (!masterVolumeModulated);

    // Update effect parameter knobs to reflect modulation
    updateEffectParameterModulation();

    // Update MIDI learn button color
    if (learnMode)
    {
        if (hasSelection)
            midiLearnButton.setColour (juce::TextButton::buttonColourId, juce::Colour (0xffff9900));  // Orange when has selection
        else
            midiLearnButton.setColour (juce::TextButton::buttonColourId, juce::Colour (0xff5dd6c6));  // Accent color when active
    }
    else
    {
        midiLearnButton.setColour (juce::TextButton::buttonColourId, juce::Colour (0xff2a2b31));
    }

    repaint();
}

void MainComponent::handleIncomingMidiMessage (juce::MidiInput* source,
                                                const juce::MidiMessage& message)
{
    juce::ignoreUnused (source);

    std::cerr << "MIDI message received: " << message.getDescription() << std::endl;

    // All UI updates must happen on the message thread
    // Copy the relevant data we need
    const bool isCC = message.isController();
    const bool isNoteOn = message.isNoteOn();
    const bool isNoteOff = message.isNoteOff();
    const int ccNumber = isCC ? message.getControllerNumber() : 0;
    const int ccValue = isCC ? message.getControllerValue() : 0;
    const int noteNumber = (isNoteOn || isNoteOff) ? message.getNoteNumber() : 0;

    // Post to message thread for processing
    juce::MessageManager::callAsync ([this, isCC, isNoteOn, isNoteOff, ccNumber, ccValue, noteNumber]()
    {
        // Handle MIDI learn mode - only if we have a selection
        if (midiLearnActive.load() && midiLearnHasSelection.load())
        {
            if (isNoteOn)
            {
                std::cerr << "[MIDI Learn] Accepting NoteOn " << noteNumber << " for mapping" << std::endl;
                processMidiLearn (noteNumber, true);
            }
            else if (isCC)
            {
                // Require the CC value to change before accepting — this filters
                // out idle/background CC traffic and ensures we capture the knob
                // the user is actually moving.
                auto it = midiLearnFirstCC.find (ccNumber);
                if (it == midiLearnFirstCC.end())
                {
                    std::cerr << "[MIDI Learn] CC " << ccNumber << " first seen, baseline value=" << ccValue << std::endl;
                    midiLearnFirstCC[ccNumber] = ccValue;
                }
                else if (ccValue != it->second)
                {
                    std::cerr << "[MIDI Learn] CC " << ccNumber << " value changed (" << it->second << " -> " << ccValue << "), accepting for mapping" << std::endl;
                    processMidiLearn (ccNumber, false);
                }
            }
            return;
        }

        // MIDI-learned mappings take priority over encoder bank
        bool handledByLearnedMapping = false;

        if (isCC)
        {
            auto it = midiCCMappings.find (ccNumber);
            if (it != midiCCMappings.end())
            {
                handledByLearnedMapping = true;
                if (it->second.type == MidiMapping::Knob && it->second.knobPtr != nullptr)
                {
                    auto* knob = it->second.knobPtr;
                    double range = knob->getMaximum() - knob->getMinimum();

                    // Relative mode: 65 = CW (+1 detent), 63 = CCW (-1 detent)
                    if (ccValue == 65 || ccValue == 63)
                    {
                        double step = range / 100.0;  // 1% per detent
                        double delta = (ccValue == 65) ? step : -step;
                        knob->setValue (knob->getValue() + delta);
                    }
                    else
                    {
                        // Absolute mode fallback for other controllers
                        float normValue = ccValue / 127.0f;
                        knob->setValue (knob->getMinimum() + normValue * range);
                    }
                }
                else if (it->second.type == MidiMapping::LoopButton)
                {
                    int loopIdx = it->second.targetIndex;
                    if (loopIdx >= 0 && loopIdx < 8 && ccValue > 63)
                    {
                        if (usePiLayout)
                            piToggleLoop (loopIdx);
                        else
                            loopButtons[loopIdx].triggerClick();
                    }
                }
                else if (it->second.type == MidiMapping::Button && it->second.buttonPtr != nullptr)
                {
                    if (ccValue > 63)
                        it->second.buttonPtr->triggerClick();
                }
            }
        }

        if (isNoteOn && !handledByLearnedMapping)
        {
            auto it = midiNoteMappings.find (noteNumber);
            if (it != midiNoteMappings.end())
            {
                handledByLearnedMapping = true;
                if (it->second.type == MidiMapping::LoopButton)
                {
                    int loopIdx = it->second.targetIndex;
                    if (loopIdx >= 0 && loopIdx < 8)
                    {
                        if (usePiLayout)
                            piToggleLoop (loopIdx);
                        else
                            loopButtons[loopIdx].triggerClick();
                    }
                }
                else if (it->second.type == MidiMapping::Button && it->second.buttonPtr != nullptr)
                {
                    it->second.buttonPtr->triggerClick();
                }
            }
        }

        // Virtual encoder bank — contextual dispatch (only if no learned mapping handled it)
        bool handledByEncoder = false;
        if (isCC && !handledByLearnedMapping)
            handledByEncoder = encoderBank.handleCC (ccNumber, ccValue);
        if (isNoteOn && !handledByLearnedMapping && !handledByEncoder)
            handledByEncoder = encoderBank.handleNoteOn (noteNumber);

        // Default loop toggle notes: 44-51 (G#2-D#3) → toggle record/play/stop
        if (isNoteOn && !handledByLearnedMapping && !handledByEncoder)
        {
            int loopSlot = noteNumber - VirtualEncoderBank::loopToggleNoteBase;
            if (loopSlot >= 0 && loopSlot < 8)
            {
                if (usePiLayout)
                    piToggleLoop (loopSlot);
                else
                    loopButtons[loopSlot].triggerClick();
                handledByEncoder = true;
            }
        }

        // Handle NoteOff for encoder push button release
        if (isNoteOff)
            encoderBank.handleNoteOff (noteNumber);
    });
}

void MainComponent::refreshMidiInputs()
{
    auto midiInputs = juce::MidiInput::getAvailableDevices();
    for (const auto& input : midiInputs)
    {
        if (knownMidiInputIds.count (input.identifier) == 0)
        {
            std::cerr << "MIDI input connected: " << input.name << " [" << input.identifier << "]" << std::endl;
            deviceManager.setMidiInputDeviceEnabled (input.identifier, true);
            deviceManager.addMidiInputDeviceCallback (input.identifier, this);
            knownMidiInputIds.insert (input.identifier);
        }
    }
}

void MainComponent::toggleMidiLearnMode()
{
    if (midiLearnActive.load())
    {
        std::cerr << "[MIDI Learn] Exiting learn mode" << std::endl;
        exitMidiLearnMode();
    }
    else
    {
        std::cerr << "[MIDI Learn] Entering learn mode" << std::endl;
        midiLearnActive.store (true);
        midiLearnHasSelection.store (false);
        midiLearnSelected = MidiMapping();
        midiLearnButton.setButtonText ("Select...");
    }
}

void MainComponent::exitMidiLearnMode()
{
    midiLearnActive.store (false);
    midiLearnHasSelection.store (false);
    midiLearnSelected = MidiMapping();
    midiLearnButton.setButtonText ("MIDI Learn");
}

void MainComponent::selectControlForMidiLearn (juce::Slider* knob)
{
    if (!midiLearnActive.load())
        return;

    clearMidiLearnSelection();

    midiLearnSelected.type = MidiMapping::Knob;
    midiLearnSelected.knobPtr = knob;
    midiLearnHasSelection.store (true);
    midiLearnButton.setButtonText ("Waiting...");
    std::cerr << "[MIDI Learn] Selected knob: " << knob->getName() << " (ptr=" << (void*) knob << ")" << std::endl;
}

void MainComponent::selectLoopButtonForMidiLearn (int loopIndex)
{
    if (!midiLearnActive.load())
        return;

    clearMidiLearnSelection();

    midiLearnSelected.type = MidiMapping::LoopButton;
    midiLearnSelected.targetIndex = loopIndex;
    midiLearnHasSelection.store (true);
    midiLearnButton.setButtonText ("Loop " + juce::String (loopIndex + 1));
}

void MainComponent::selectButtonForMidiLearn (juce::Button* button)
{
    if (!midiLearnActive.load())
        return;

    clearMidiLearnSelection();

    midiLearnSelected.type = MidiMapping::Button;
    midiLearnSelected.buttonPtr = button;
    midiLearnHasSelection.store (true);
    midiLearnButton.setButtonText ("Waiting...");
}

void MainComponent::clearMidiLearnSelection()
{
    midiLearnSelected = MidiMapping();
    midiLearnHasSelection.store (false);
    midiLearnFirstCC.clear();
}

void MainComponent::processMidiLearn (int ccOrNote, bool isNote)
{
    // This is called on the message thread
    if (!midiLearnHasSelection.load())
        return;

    MidiMapping mapping = midiLearnSelected;

    const char* targetDesc = "unknown";
    if (mapping.type == MidiMapping::Knob)       targetDesc = "Knob";
    else if (mapping.type == MidiMapping::LoopButton)  targetDesc = "LoopButton";
    else if (mapping.type == MidiMapping::Button)      targetDesc = "Button";

    if (isNote)
    {
        midiNoteMappings[ccOrNote] = mapping;
        std::cerr << "[MIDI Learn] MAPPED Note " << ccOrNote << " -> " << targetDesc
                  << " (index=" << mapping.targetIndex << ")" << std::endl;
    }
    else
    {
        midiCCMappings[ccOrNote] = mapping;
        std::cerr << "[MIDI Learn] MAPPED CC " << ccOrNote << " -> " << targetDesc
                  << " (ptr=" << (void*) mapping.knobPtr << ")" << std::endl;

        // If this CC is in the encoder bank range, warn about the override
        if (encoderBank.isEncoderCC (ccOrNote))
            std::cerr << "[MIDI Learn] NOTE: CC " << ccOrNote << " is in encoder bank range (CC "
                      << VirtualEncoderBank::defaultCCBase << "-"
                      << (VirtualEncoderBank::defaultCCBase + VirtualEncoderBank::numEncoders - 1)
                      << ") -- learned mapping will take priority" << std::endl;
    }

    // Clear selection but stay in learn mode
    clearMidiLearnSelection();
    midiLearnButton.setButtonText ("Select...");
}

//==============================================================================
// PI LAYOUT
//==============================================================================

void MainComponent::initPiLayout()
{
    // Create touch loop buttons
    for (int i = 0; i < 8; ++i)
    {
        piLoopButtons[i] = std::make_unique<TouchLoopButton> (loopRecorder, i);
        piLoopButtons[i]->onSelect = [this](int slot) {
            // Short tap on a recording slot stops the recording
            if (loopRecorder.isRecording() && loopRecorder.getRecordingSlot() == slot)
                loopRecorder.stopRecording();
            piSelectLoop (slot);
        };
        piLoopButtons[i]->onToggle = [this](int slot) { piToggleLoop (slot); };
        addAndMakeVisible (*piLoopButtons[i]);
    }

    // Create detail strip
    piLoopDetail = std::make_unique<LoopDetailStrip> (loopRecorder);
    addAndMakeVisible (*piLoopDetail);

    // Wire detail strip callbacks
    piLoopDetail->octaveSelector.onChange = [this](int octave) {
        int slot = piLoopDetail->getSelectedLoop();
        loopRecorder.setSlotPitchOctave (slot, octave);
        loopPitchCombos[slot].setSelectedId (octave + 3, juce::dontSendNotification);
    };

    piLoopDetail->autoButton.onClick = [this]() {
        int slot = piLoopDetail->getSelectedLoop();
        auto* editor = new LoopAutomationEditor (loopRecorder, slot);
        juce::DialogWindow::LaunchOptions options;
        options.content.setOwned (editor);
        options.dialogTitle = "Loop " + juce::String (slot + 1) + " Automation";
        options.dialogBackgroundColour = juce::Colour (0xff17181d);
        options.escapeKeyTriggersCloseButton = true;
        options.useNativeTitleBar = false;
        options.resizable = false;
        options.launchAsync();
    };

    piLoopDetail->clearButton.onClick = [this]() {
        int slot = piLoopDetail->getSelectedLoop();
        loopRecorder.clearSlot (slot);
    };

    // Override tab buttons for Pi layout
    auto piUpdateTabColors = [this] {
        droneTabButton.setColour (juce::TextButton::buttonColourId,
            activeTab == 0 ? PiColours::accent.withAlpha (0.25f) : PiColours::buttonBg);
        droneTabButton.setColour (juce::TextButton::textColourOffId,
            activeTab == 0 ? PiColours::accentBright : PiColours::textNormal);
        modulationTabButton.setColour (juce::TextButton::buttonColourId,
            activeTab == 2 ? PiColours::accent.withAlpha (0.25f) : PiColours::buttonBg);
        modulationTabButton.setColour (juce::TextButton::textColourOffId,
            activeTab == 2 ? PiColours::accentBright : PiColours::textNormal);
        settingsButton.setColour (juce::TextButton::buttonColourId, PiColours::buttonBg);
        settingsButton.setColour (juce::TextButton::textColourOffId, PiColours::textNormal);
        resourcesButton.setColour (juce::TextButton::buttonColourId, PiColours::buttonBg);
        resourcesButton.setColour (juce::TextButton::textColourOffId, PiColours::textNormal);
    };

    droneTabButton.onClick = [this, piUpdateTabColors] {
        if (activeTab == 0)
        {
            // Already on drone tab — toggle page
            piDroneKnobPage = (piDroneKnobPage + 1) % 2;
            updateDroneParameterKnobs();
            return;
        }
        activeTab = 0;
        piDroneKnobPage = 0;
        piLoopMode = false;
        selectedEffectSlot = -1;
        TouchLoopButton::selectedSlot = -1;
        piUpdateTabColors();
        updateEffectButtonColors();
        updateDroneParameterKnobs();
        if (modulationPanel)
            modulationPanel->setVisible (false);
        // Restore indicator mode layout via resized
        resized();
        for (auto& btn : piLoopButtons)
            if (btn) btn->repaint();
    };

    modulationTabButton.onClick = [this, piUpdateTabColors] {
        activeTab = 2;
        piLoopMode = false;
        selectedEffectSlot = -1;
        TouchLoopButton::selectedSlot = -1;
        piUpdateTabColors();
        updateEffectButtonColors();
        // Hide desktop modulation panel in Pi mode; resized() handles indicator layout
        if (modulationPanel)
            modulationPanel->setVisible (false);
        resized();
        // Populate bottom knobs with modulation encoder controls
        updateModulationParameterKnobs();
        for (auto& btn : piLoopButtons)
            if (btn) btn->repaint();
    };

    piUpdateTabColors();

    // Effect buttons: tap selects effect and enters effect mode
    for (int i = 0; i < 6; ++i)
    {
        effectButtons[i].onClick = [this, i]() {
            piSelectEffect (i);
        };
    }

    // Set Pi-specific button styling
    bypassButton.setButtonText (masterBypass.load() ? "OFF" : "ON");
    bypassButton.setColour (juce::TextButton::buttonColourId,
                             masterBypass.load() ? PiColours::recording.withAlpha (0.3f) : PiColours::buttonBg);
    bypassButton.setColour (juce::TextButton::textColourOffId,
                             masterBypass.load() ? PiColours::recording : PiColours::textNormal);
    midiLearnButton.setColour (juce::TextButton::buttonColourId, PiColours::buttonBg);
    midiLearnButton.setColour (juce::TextButton::textColourOffId, PiColours::textDim);

    // Create mini mixer strip (always visible except on mod tab)
    piMiniMixer = std::make_unique<MiniMixerStrip> (loopRecorder);
    addAndMakeVisible (*piMiniMixer);

    // Create multi-loop overview (visible on mod tab only)
    piMultiOverview = std::make_unique<MultiLoopOverview> (loopRecorder);
    addChildComponent (*piMultiOverview);

    // Dev push buttons — simulate encoder push buttons for testing without MIDI controller
    for (int i = 0; i < 8; ++i)
    {
        piPushButtons[i].setButtonText ("P");
        piPushButtons[i].setColour (juce::TextButton::buttonColourId, PiColours::panelRaised);
        piPushButtons[i].setColour (juce::TextButton::textColourOffId, PiColours::textDim);
        piPushButtons[i].onClick = [this, i] {
            // Trigger the encoder bank's push button for this slot
            encoderBank.handleNoteOn (VirtualEncoderBank::defaultNoteBase + i);
            // Also send NoteOff shortly after (fire-and-forget)
            juce::Timer::callAfterDelay (100, [this, i] {
                encoderBank.handleNoteOff (VirtualEncoderBank::defaultNoteBase + i);
            });
        };
        addAndMakeVisible (piPushButtons[i]);
    }

    // Start in loop mode with loop 0 selected
    piLoopMode = true;
    piSelectLoop (0);
}

void MainComponent::piSelectLoop (int slot)
{
    // Enter loop mode — deselect effects, return to loops view
    activeTab = 1;
    piLoopMode = true;
    selectedEffectSlot = -1;
    updateEffectButtonColors();

    // Restore indicator layout (may have been replaced by mod panel)
    if (modulationPanel)
        modulationPanel->setVisible (false);

    // Unhighlight drone/mod tab buttons
    droneTabButton.setColour (juce::TextButton::buttonColourId, PiColours::buttonBg);
    droneTabButton.setColour (juce::TextButton::textColourOffId, PiColours::textNormal);
    modulationTabButton.setColour (juce::TextButton::buttonColourId, PiColours::buttonBg);
    modulationTabButton.setColour (juce::TextButton::textColourOffId, PiColours::textNormal);

    TouchLoopButton::selectedSlot = slot;
    piLoopDetail->setSelectedLoop (slot);
    piSyncDetailToLoop (slot);
    updateLoopParameterKnobs();
    resized();

    for (auto& btn : piLoopButtons)
        if (btn) btn->repaint();
}

void MainComponent::startBounce (int slot)
{
    if (slot < 0 || slot >= 8) return;
    if (! loopRecorder.isSlotActive (slot)) return;
    if (loopRecorder.isSlotBouncing (slot) || loopRecorder.isSlotBounced (slot)) return;

    // Mark as bouncing
    loopRecorder.setSlotBouncing (slot);

    // Snapshot drone parameters from the live FFT processor
    auto snapshot = DroneParameterSnapshot::fromProcessor (fftProcessorL);

    // Copy the loop buffer
    int length = loopRecorder.getSlotLength (slot);
    std::vector<float> buffer (length);
    for (int i = 0; i < length; ++i)
        buffer[i] = loopRecorder.getSampleAtIndex (slot, i);

    float trimStart = loopRecorder.getSlotTrimStart (slot);
    float trimEnd = loopRecorder.getSlotTrimEnd (slot);

    // Get pitch octave from combo (need to read the current setting)
    int pitchOctave = loopPitchCombos[slot].getSelectedId() - 3;  // ID 1-5 maps to -2 to +2

    loopBouncer.startBounce (slot, std::move (buffer), length, trimStart, trimEnd, pitchOctave, snapshot,
        [this] (int s, std::vector<float>&& l, std::vector<float>&& r, int len) {
            onBounceComplete (s, std::move (l), std::move (r), len);
        });
}

void MainComponent::cancelBounce()
{
    int slot = loopBouncer.activeSlot.load();
    loopBouncer.signalThreadShouldExit();
    loopBouncer.waitForThreadToExit (3000);
    if (slot >= 0 && slot < 8)
        loopRecorder.clearSlotBounceState (slot);
}

void MainComponent::onBounceComplete (int slot, std::vector<float>&& left, std::vector<float>&& right, int length)
{
    std::cerr << "[Bounce] onBounceComplete: slot=" << slot << " length=" << length
              << " leftSize=" << left.size() << " rightSize=" << right.size() << std::endl;

    // Store the result
    loopRecorder.setSlotBounceResult (slot, std::move (left), std::move (right), length);

    // Start the transition (align bounce heads with current playback position)
    double currentPos = loopRecorder.getSlotProgress (slot)
                        * loopRecorder.getSlotEffectiveLength (slot);

    std::cerr << "[Bounce] Starting transition: currentPos=" << currentPos << std::endl;
    loopRecorder.startBounceTransition (slot, currentPos);
}

void MainComponent::piSelectEffect (int slot)
{
    // Enter effect mode — deselect loops, return to loops view
    activeTab = 1;
    piLoopMode = false;
    TouchLoopButton::selectedSlot = -1;
    selectedEffectSlot = slot;

    // Restore indicator layout
    if (modulationPanel)
        modulationPanel->setVisible (false);

    droneTabButton.setColour (juce::TextButton::buttonColourId, PiColours::buttonBg);
    droneTabButton.setColour (juce::TextButton::textColourOffId, PiColours::textNormal);
    modulationTabButton.setColour (juce::TextButton::buttonColourId, PiColours::buttonBg);
    modulationTabButton.setColour (juce::TextButton::textColourOffId, PiColours::textNormal);

    updateEffectButtonColors();
    updateEffectParameterKnobs();
    resized();

    for (auto& btn : piLoopButtons)
        if (btn) btn->repaint();
}

void MainComponent::piToggleLoop (int slot)
{
    // Same logic as the desktop loop button onClick
    if (midiLearnActive.load())
    {
        selectLoopButtonForMidiLearn (slot);
        return;
    }

    if (loopRecorder.isRecording() && loopRecorder.getRecordingSlot() == slot)
        loopRecorder.stopRecording();
    else if (loopRecorder.isSlotActive (slot))
        loopRecorder.clearSlot (slot);
    else
        loopRecorder.startRecording (slot);

    // Also select this loop for detail view
    piSelectLoop (slot);
}

void MainComponent::updateDroneParameterKnobs()
{
    // Hide all existing param controls
    for (int i = 0; i < maxParamKnobs; ++i)
    {
        paramKnobs[i].setVisible (false);
        paramKnobs[i].onValueChange = nullptr;
        paramKnobs[i].textFromValueFunction = nullptr;
        paramLabels[i].setVisible (false);
    }
    for (int i = 0; i < 4; ++i)
    {
        paramCombos[i].setVisible (false);
        paramCombos[i].onChange = nullptr;
        paramComboLabels[i].setVisible (false);
        paramToggles[i].setVisible (false);
        paramToggles[i].onClick = nullptr;
    }
    numActiveKnobs = 0;
    numActiveCombos = 0;
    numActiveToggles = 0;
    encoderBank.clearAll();

    auto addKnob = [this](const juce::String& name, juce::Slider& source) {
        if (numActiveKnobs >= maxParamKnobs) return;
        int knobIndex = numActiveKnobs;
        auto& knob = paramKnobs[knobIndex];
        auto& label = paramLabels[knobIndex];

        knob.setRange (source.getRange().getStart(), source.getRange().getEnd(), source.getInterval());
        knob.setValue (source.getValue(), juce::dontSendNotification);
        knob.setTextValueSuffix (source.getTextValueSuffix());
        knob.onValueChange = [&knob, &source] {
            source.setValue (knob.getValue(), juce::sendNotificationSync);
        };
        knob.setVisible (true);

        label.setText (name, juce::dontSendNotification);
        label.setVisible (true);

        // Bind to virtual encoder bank
        if (knobIndex < VirtualEncoderBank::numEncoders)
        {
            encoderBank.bindEncoder (knobIndex, name,
                source.getRange().getStart(), source.getRange().getEnd(), source.getInterval(),
                [this, knobIndex, &source](float v) {
                    paramKnobs[knobIndex].setValue (v, juce::dontSendNotification);
                    source.setValue (v, juce::sendNotificationSync);
                },
                [this, knobIndex]() -> float {
                    return (float) paramKnobs[knobIndex].getValue();
                },
                source.getTextValueSuffix());
        }

        numActiveKnobs++;
    };

    auto addToggleAsKnob = [this](const juce::String& name, juce::ToggleButton& source) {
        if (numActiveKnobs >= maxParamKnobs) return;
        int knobIndex = numActiveKnobs;
        auto& knob = paramKnobs[knobIndex];
        auto& label = paramLabels[knobIndex];

        knob.setRange (0, 1, 1);
        knob.setValue (source.getToggleState() ? 1.0 : 0.0, juce::dontSendNotification);
        knob.setTextValueSuffix ("");
        knob.onValueChange = [&knob, &source] {
            source.setToggleState (knob.getValue() >= 0.5, juce::sendNotificationSync);
        };
        knob.setVisible (true);

        label.setText (name, juce::dontSendNotification);
        label.setVisible (true);

        // Bind to virtual encoder bank
        if (knobIndex < VirtualEncoderBank::numEncoders)
        {
            encoderBank.bindEncoder (knobIndex, name, 0, 1, 1,
                [this, knobIndex, &source](float v) {
                    paramKnobs[knobIndex].setValue (v, juce::dontSendNotification);
                    source.setToggleState (v >= 0.5f, juce::sendNotificationSync);
                },
                [this, knobIndex]() -> float {
                    return (float) paramKnobs[knobIndex].getValue();
                });
        }

        numActiveKnobs++;
    };

    if (piDroneKnobPage == 0)
    {
        addKnob ("Dry/Wet", dryWetKnob);
        addKnob ("Smooth", smoothingKnob);
        addKnob ("Thresh", thresholdKnob);
        addKnob ("Tilt", tiltKnob);
        addKnob ("Delay", delayKnob);
        addKnob ("Decay", decayKnob);
        addKnob ("History", historyKnob);
        addKnob ("Width", stereoWidthKnob);
    }
    else
    {
        addKnob ("Pitch", pitchKnob);
        addKnob ("Octave", octaveKnob);
        addToggleAsKnob ("Peak", peakToggle);
        addToggleAsKnob ("Phase", phaseToggle);
        addKnob ("Live/Loop", loopMixKnob);
        addKnob ("Volume", masterVolumeKnob);

        // Knob 7: Drone offset (delay between drone input and dry loop output)
        {
            if (numActiveKnobs < maxParamKnobs)
            {
                int knobIndex = numActiveKnobs;
                auto& knob = paramKnobs[knobIndex];
                auto& label = paramLabels[knobIndex];

                knob.setRange (0.5, 8.0, 0.1);
                knob.setValue (loopRecorder.getDroneOffset(), juce::dontSendNotification);
                knob.setTextValueSuffix (" s");
                knob.onValueChange = [this, knobIndex] {
                    loopRecorder.setDroneOffset ((float) paramKnobs[knobIndex].getValue());
                };
                knob.setVisible (true);
                label.setText ("Offset", juce::dontSendNotification);
                label.setVisible (true);

                if (knobIndex < VirtualEncoderBank::numEncoders)
                {
                    encoderBank.bindEncoder (knobIndex, "Offset", 0.5, 8.0, 0.1,
                        [this, knobIndex](float v) {
                            paramKnobs[knobIndex].setValue (v, juce::dontSendNotification);
                            loopRecorder.setDroneOffset (v);
                        },
                        [this, knobIndex]() -> float {
                            return (float) paramKnobs[knobIndex].getValue();
                        }, " s");
                }

                numActiveKnobs++;
            }
        }
    }

    resized();
}

void MainComponent::piSyncDetailToLoop (int slot)
{
    piLoopDetail->octaveSelector.setSelectedOctave (loopPitchCombos[slot].getSelectedId() - 3);
}

// Apply an automation preset with time scaling to a sequence
static Sequence applyPresetWithTimeScale (int presetIdx, float timeScale)
{
    presetIdx = juce::jlimit (0, AutomationPresets::numPresets - 1, presetIdx);
    Sequence seq = AutomationPresets::presets[presetIdx].build();

    // Scale all durations
    if (std::abs (timeScale - 1.0f) > 0.001f)
    {
        for (auto& cmd : seq.commands)
        {
            if (auto* w = std::get_if<Wait> (&cmd))
                w->durationSeconds *= timeScale;
            else if (auto* r = std::get_if<RampLevel> (&cmd))
                r->durationSeconds *= timeScale;
        }
    }
    return seq;
}
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
