aeobrien/DronemakerClonev3/DronemakerClonev3/Source/Effects/GranularEffect.cpp

#include "GranularEffect.h"
#include <cmath>

GranularEffect::GranularEffect()
{
}

void GranularEffect::prepareToPlay (double sr, int /*samplesPerBlock*/)
{
    sampleRate = sr;
    bufferSize = static_cast<int> (sr * bufferSeconds);

    bufferL.resize (bufferSize, 0.0f);
    bufferR.resize (bufferSize, 0.0f);

    dryWetSmooth.setSmoothingTime (sr, 10.0f);
    feedbackSmooth.setSmoothingTime (sr, 10.0f);

    reset();
}

void GranularEffect::reset()
{
    std::fill (bufferL.begin(), bufferL.end(), 0.0f);
    std::fill (bufferR.begin(), bufferR.end(), 0.0f);
    writePos = 0;
    grainSpawnCounter = 0;

    for (auto& grain : grains)
        grain.active = false;

    dampStateL = 0.0f;
    dampStateR = 0.0f;
}

void GranularEffect::updatePitchRatio()
{
    pitchRatio = std::pow (2.0f, pitch / 12.0f);
}

float GranularEffect::getWindowValue (double position, int length) const
{
    // Hann window
    if (length <= 0)
        return 0.0f;

    double normalized = position / static_cast<double> (length);
    if (normalized < 0.0 || normalized > 1.0)
        return 0.0f;

    return static_cast<float> (0.5 * (1.0 - std::cos (2.0 * juce::MathConstants<double>::pi * normalized)));
}

float GranularEffect::getInterpolatedSample (const std::vector<float>& buffer, double position) const
{
    if (bufferSize <= 0)
        return 0.0f;

    // Wrap position
    while (position < 0)
        position += bufferSize;
    while (position >= bufferSize)
        position -= bufferSize;

    int idx0 = static_cast<int> (position);
    int idx1 = (idx0 + 1) % bufferSize;
    float frac = static_cast<float> (position - idx0);

    return buffer[idx0] * (1.0f - frac) + buffer[idx1] * frac;
}

void GranularEffect::spawnGrain()
{
    // Find an inactive grain slot
    for (auto& grain : grains)
    {
        if (! grain.active)
        {
            // Calculate grain size (random between min and max)
            float grainSizeMs = grainSizeMinMs + random.nextFloat() * (grainSizeMaxMs - grainSizeMinMs);
            int grainLengthSamples = static_cast<int> (grainSizeMs * 0.001 * sampleRate);

            // Calculate delay time (random between min and max)
            float delayMs = delayMinMs + random.nextFloat() * (delayMaxMs - delayMinMs);
            int delaySamples = static_cast<int> (delayMs * 0.001 * sampleRate);

            // Apply spread as additional random offset
            int spreadOffset = static_cast<int> (spread * delaySamples * 0.5f);
            if (spreadOffset > 0)
                delaySamples += random.nextInt (spreadOffset * 2) - spreadOffset;

            // Clamp to valid buffer range
            delaySamples = juce::jlimit (grainLengthSamples, bufferSize - 1, delaySamples);

            // Start reading from the delayed position
            grain.readPosition = static_cast<double> (writePos - delaySamples);
            if (grain.readPosition < 0)
                grain.readPosition += bufferSize;

            grain.grainPosition = 0.0;
            grain.grainLength = grainLengthSamples;
            grain.pan = 0.3f + random.nextFloat() * 0.4f;  // Random pan between 0.3 and 0.7
            grain.active = true;

            break;
        }
    }
}

void GranularEffect::processSample (float& left, float& right)
{
    if (! enabled || bufferSize == 0)
        return;

    // Store dry signal
    float dryL = left;
    float dryR = right;

    // Write to buffer (feedback is added after grain processing below)
    bufferL[writePos] = left;
    bufferR[writePos] = right;

    // Spawn new grains based on density
    // Use average grain size for spawn interval calculation
    float avgGrainSizeMs = (grainSizeMinMs + grainSizeMaxMs) * 0.5f;
    int avgGrainLengthSamples = static_cast<int> (avgGrainSizeMs * 0.001 * sampleRate);
    grainSpawnInterval = static_cast<int> (avgGrainLengthSamples / density);

    grainSpawnCounter++;
    if (grainSpawnCounter >= grainSpawnInterval)
    {
        grainSpawnCounter = 0;
        spawnGrain();
    }

    // Process all active grains
    float wetL = 0.0f;
    float wetR = 0.0f;
    int activeCount = 0;

    for (auto& grain : grains)
    {
        if (grain.active)
        {
            // Get windowed sample
            float window = getWindowValue (grain.grainPosition, grain.grainLength);
            float sampleL = getInterpolatedSample (bufferL, grain.readPosition) * window;
            float sampleR = getInterpolatedSample (bufferR, grain.readPosition) * window;

            // Apply pan
            wetL += sampleL * (1.0f - grain.pan);
            wetR += sampleR * grain.pan;
            activeCount++;

            // Advance positions
            grain.readPosition += pitchRatio;
            if (grain.readPosition >= bufferSize)
                grain.readPosition -= bufferSize;

            grain.grainPosition += 1.0;

            // Deactivate grain when it ends
            if (grain.grainPosition >= grain.grainLength)
                grain.active = false;
        }
    }

    // Normalize
    if (activeCount > 1)
    {
        float norm = 1.0f / std::sqrt (static_cast<float> (activeCount));
        wetL *= norm;
        wetR *= norm;
    }

    // Get smoothed parameter values
    float feedback = feedbackSmooth.getNextValue();
    float dryWet = dryWetSmooth.getNextValue();

    // Feed grain output back into the buffer (creates reverb-like washes)
    if (feedback > 0.001f)
    {
        float fbL = wetL * feedback;
        float fbR = wetR * feedback;

        // Apply damping (one-pole LP on feedback — darkens each generation)
        // If damping not set explicitly, auto-damp proportionally to feedback
        float effectiveDamping = damping > 0.001f ? damping : feedback * 0.5f;
        if (effectiveDamping > 0.001f)
        {
            float dampFreq = 20000.0f * (1.0f - effectiveDamping * 0.95f);  // 20kHz down to 1kHz
            float dampCoeff = 1.0f - std::exp (-2.0f * juce::MathConstants<float>::pi * dampFreq / static_cast<float> (sampleRate));
            dampStateL += dampCoeff * (fbL - dampStateL);
            dampStateR += dampCoeff * (fbR - dampStateR);
            fbL = dampStateL;
            fbR = dampStateR;
        }

        bufferL[writePos] += fbL;
        bufferR[writePos] += fbR;
    }

    // Advance write position
    writePos = (writePos + 1) % bufferSize;

    // Dry/wet mix
    left = dryL * (1.0f - dryWet) + wetL * dryWet;
    right = dryR * (1.0f - dryWet) + wetR * dryWet;
}
