aeobrien/DronemakerClonev3/DronemakerClonev3/Source/Effects/DistortionEffect.cpp

#include "DistortionEffect.h"
#include <cmath>

DistortionEffect::DistortionEffect()
{
}

void DistortionEffect::prepareToPlay (double sr, int /*samplesPerBlock*/)
{
    sampleRate = sr;

    // Set up parameter smoothing (10ms smoothing time)
    driveSmooth.setSmoothingTime (sr, 10.0f);
    toneSmooth.setSmoothingTime (sr, 10.0f);
    dryWetSmooth.setSmoothingTime (sr, 10.0f);
    bitDepthSmooth.setSmoothingTime (sr, 20.0f);
    srReductionSmooth.setSmoothingTime (sr, 20.0f);
    asymmetrySmooth.setSmoothingTime (sr, 10.0f);
    preHPSmooth.setSmoothingTime (sr, 10.0f);

    reset();
}

void DistortionEffect::reset()
{
    dcStateL = dcStateR = 0.0f;
    dcPrevL = dcPrevR = 0.0f;
    toneStateL = toneStateR = 0.0f;
    preHPStateL = preHPStateR = 0.0f;
    srCounter = 0;
    holdL = holdR = 0.0f;
}

float DistortionEffect::processSoftClip (float sample, float drive)
{
    // Soft clipping using tanh - smooth, tube-like saturation
    // Apply drive as gain before saturation
    sample *= drive;

    // Tanh gives gradual saturation
    return std::tanh (sample);
}

float DistortionEffect::processHardClip (float sample, float drive)
{
    // Hard clipping - harsh, transistor-like distortion
    // Apply drive as gain
    sample *= drive;

    // Asymmetric hard clipping for more character
    if (sample > 0.7f)
        sample = 0.7f + (sample - 0.7f) * 0.1f;  // Compress positive peaks
    if (sample < -0.7f)
        sample = -0.7f + (sample + 0.7f) * 0.1f; // Compress negative peaks

    // Final hard limit
    return juce::jlimit (-1.0f, 1.0f, sample);
}

float DistortionEffect::processWavefold (float sample, float drive)
{
    // Wavefolder - creates complex harmonics by folding the waveform
    // Apply drive as gain
    sample *= drive;

    // Multi-stage wavefolder for more complex harmonics
    for (int stage = 0; stage < 4; ++stage)
    {
        if (sample > 1.0f)
            sample = 2.0f - sample;
        else if (sample < -1.0f)
            sample = -2.0f - sample;
    }

    return sample;
}

float DistortionEffect::processBitcrush (float sample, float& hold, int& counter, float bitDepth, float srReduction)
{
    // Sample rate reduction
    counter++;
    if (counter >= static_cast<int> (srReduction))
    {
        counter = 0;
        hold = sample;
    }

    // Bit depth reduction
    float levels = std::pow (2.0f, bitDepth);
    float quantized = std::round (hold * levels) / levels;

    return quantized;
}

float DistortionEffect::processDCBlock (float sample, float& state, float& prev)
{
    // Simple DC blocker: y[n] = x[n] - x[n-1] + 0.995 * y[n-1]
    float output = sample - prev + 0.995f * state;
    prev = sample;
    state = output;
    return output;
}

void DistortionEffect::processSample (float& left, float& right)
{
    if (! enabled)
        return;

    // Get smoothed parameter values
    float drive = driveSmooth.getNextValue();
    float tone = toneSmooth.getNextValue();
    float dryWet = dryWetSmooth.getNextValue();
    float bitDepth = bitDepthSmooth.getNextValue();
    float srReduction = srReductionSmooth.getNextValue();
    float asymmetry = asymmetrySmooth.getNextValue();
    float preHPFreq = preHPSmooth.getNextValue();

    // Auto gain compensation: reduce output proportionally to drive
    if (algorithm != Bitcrush)
        autoGainFactor = 1.0f / std::sqrt (drive);
    else
        autoGainFactor = 1.0f;

    // Pre-distortion highpass filter (removes low-end before saturation)
    if (preHPFreq > 25.0f)
    {
        float hpCoeff = 1.0f - std::exp (-2.0f * juce::MathConstants<float>::pi * preHPFreq / static_cast<float> (sampleRate));
        preHPStateL += hpCoeff * (left - preHPStateL);
        preHPStateR += hpCoeff * (right - preHPStateR);
        left = left - preHPStateL;
        right = right - preHPStateR;
    }

    float dryL = left;
    float dryR = right;

    // Calculate asymmetric drive values
    // asymmetry > 0: less drive on negative peaks (even harmonics, tube character)
    // asymmetry < 0: less drive on positive peaks
    float drivePos = drive;
    float driveNeg = drive;
    if (asymmetry > 0.01f)
        driveNeg = drive * (1.0f - asymmetry * 0.8f);  // Reduce negative drive up to 80%
    else if (asymmetry < -0.01f)
        drivePos = drive * (1.0f + asymmetry * 0.8f);   // Reduce positive drive up to 80%

    // Apply distortion algorithm with asymmetric drive
    float wetL, wetR;

    switch (algorithm)
    {
        case SoftClip:
            wetL = left >= 0.0f ? processSoftClip (left, drivePos) : processSoftClip (left, driveNeg);
            wetR = right >= 0.0f ? processSoftClip (right, drivePos) : processSoftClip (right, driveNeg);
            break;

        case HardClip:
            wetL = left >= 0.0f ? processHardClip (left, drivePos) : processHardClip (left, driveNeg);
            wetR = right >= 0.0f ? processHardClip (right, drivePos) : processHardClip (right, driveNeg);
            break;

        case Wavefold:
            wetL = left >= 0.0f ? processWavefold (left, drivePos) : processWavefold (left, driveNeg);
            wetR = right >= 0.0f ? processWavefold (right, drivePos) : processWavefold (right, driveNeg);
            break;

        case Bitcrush:
            wetL = processBitcrush (left, holdL, srCounter, bitDepth, srReduction);
            wetR = processBitcrush (right, holdR, srCounter, bitDepth, srReduction);
            break;

        default:
            wetL = left;
            wetR = right;
            break;
    }

    // DC blocking
    wetL = processDCBlock (wetL, dcStateL, dcPrevL);
    wetR = processDCBlock (wetR, dcStateR, dcPrevR);

    // Tone filter (one-pole LP, controlled by tone parameter)
    // tone = 0 → dark (low cutoff), tone = 1 → bright (high cutoff)
    float toneFreq = 500.0f + tone * 19500.0f;  // 500Hz to 20kHz
    float toneCoeff = 1.0f - std::exp (-2.0f * juce::MathConstants<float>::pi * toneFreq / static_cast<float> (sampleRate));

    toneStateL += toneCoeff * (wetL - toneStateL);
    toneStateR += toneCoeff * (wetR - toneStateR);

    wetL = toneStateL;
    wetR = toneStateR;

    // Dry/wet mix
    left = dryL * (1.0f - dryWet) + wetL * dryWet;
    right = dryR * (1.0f - dryWet) + wetR * dryWet;
}
