aeobrien/DronemakerClonev3/(commit log)

2026-01-05 Added loops, filters, delay and stereo.
2026-01-25 Fixed clicking when changing effect parameters, put drone and loops in different tabs.
    [DelayEffect.cpp, DelayEffect.h, DistortionEffect.cpp, DistortionEffect.h, EffectBase.h, FilterEffect.cpp, FilterEffect.h, LoopRecorder.cpp]
2026-03-02 Gitignore Example Code reference folder
    [teapot.obj]
2026-03-06 Add CMake build system and Raspberry Pi port roadmap
    CMakeLists.txt enables cross-platform builds (macOS + Linux/Pi) alongside
    the existing Projucer setup. Added build/ to .gitignore.
2026-03-06 Fix ALSA crash: move input channel setup out of audioDeviceAboutToStart
    Calling setAudioDeviceSetup from inside audioDeviceAboutToStart causes
    ALSA to restart the device mid-callback, leading to null channel pointers
    in JUCE's internal LevelMeter and a segfault. Input channel config now
    happens once in the constructor before the callback is registered.
    [MainComponent.cpp]
2026-03-06 Add MIDI debug logging for Linux troubleshooting
    Temporary DBG statements to diagnose MIDI device enumeration
    and message reception on Raspberry Pi / ALSA.
2026-03-06 Switch MIDI debug logging to stderr for release builds
    DBG only prints in debug mode. Use std::cerr so diagnostic
    output is visible when running release builds on the Pi.
2026-03-06 Fix MIDI input on Linux: periodic rescan for late-connecting devices
    ALSA MIDI devices may not be available at app startup. Added periodic
    re-scanning (every ~2s) to detect and enable newly connected MIDI
    devices automatically.
    [MainComponent.cpp, MainComponent.h]
2026-03-07 Add Pi touchscreen layout (1024x600)
    New touch-optimised layout for Raspberry Pi with 7" touchscreen:
    - Large loop buttons with built-in progress bars (short tap = select,
    long press = record/play/stop)
    - Loop detail strip shows controls for selected loop (octave direct-
    select buttons, HP/LP/volume sliders, auto/clear)
    - Effects row and param knobs scaled up for touch
    - No combo box popups (avoids X11 hang issue)
    Layout auto-activates on Linux. Override with --pi-layout or
    --desktop-layout command line flags. Desktop layout is unchanged.
    Also fixed MIDI loop button range from 4 to 8.
    [MainComponent.cpp, MainComponent.h, PiLayout.h]
2026-03-07 Pi layout UI overhaul: fix sizing, colours, bring back tabs
    Major changes:
    - Brought back Drone and Mod tab buttons in header (next to settings)
    - Moved mix/master volume off header (onto Drone page)
    - Drastically reduced effects/params section height — was over half
    the screen, now properly compact
    - New colour palette (PiColours namespace) — brighter, more contrast,
    better visual differentiation between states
    - Loop buttons: active loops glow teal, recording pulses red, selected
    gets bright accent border with playhead line
    - Fixed effect button text readability: selected uses teal text on dark
    tinted background instead of white on bright teal
    - Detail strip label shows selecte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
    [MainComponent.cpp, MainComponent.h, PiLayout.h]
2026-03-07 Fix Pi layout: anchor effects/params to bottom, fixed heights
    The params section was getting "remaining space" (~360px) causing
    tiny knobs floating in a massive area. Now:
    - All sections have fixed heights (header 34, loops 80, detail 78,
    effects 44, params 110)
    - Effects and params are anchored to the bottom edge of the screen
    - Knobs sized to fill their fixed area properly (knobSize x knobSize)
    - No more "remaining space" calculation
    [MainComponent.cpp]
2026-03-08 Pi layout: unified knob system, loop trimming, FFT spectrum analyzer
    - Mutual exclusion between loop and effect knob contexts
    - Loop knobs: selector, trim start/end, HP, LP, volume
    - Drone page with 2 pages (tap to toggle), includes master volume and live/loop mix
    - Combo boxes and toggles render as discrete knobs on Pi
    - FFT spectrum analyzer (4096-point, 128 bands, log frequency, amber→coral gradient)
    - Waveform display with trim markers and playhead
    - Per-loop post-filter audio visualization
    - Timer-based long press detection for loop buttons
    - Short press stops recording when loop is actively recording
    - Loop trim start/end with proper playback wrapping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
    [LoopRecorder.cpp, LoopRecorder.h, MainComponent.cpp, MainComponent.h, PiLayout.h]
2026-03-10 Add 8-encoder control system roadmap
    Detailed implementation plan for virtual encoder abstraction, contextual
    MIDI mapping, modulation page, automation presets, and kiosk deployment.
2026-03-10 Phase 1: Virtual encoder bank with default CC/note mapping
    - VirtualEncoderBank: 8 contextual encoder slots (CC 20-27) + 8 push
    button slots (Notes 36-43) that rebind when switching modes
    - MIDI handler dispatches to encoder bank before legacy mappings
    - Loop/effect/drone knob functions auto-bind to encoder bank on refresh
    - Default loop toggle notes 44-51 for record/play/stop (long-press equiv)
    - NoteOff handling added for push button release events
    - Roadmap updated with loop toggle note assignments
2026-03-10 Phase 2: Modulation page with 8-encoder control
    8 encoders fully control the modulation system:
    - Enc 1: Modulator selector (LFO1-4, EnvFollower, Rand1-2)
    - Enc 2: Rate/Attack, Enc 3: Shape/Release/Smoothness
    - Enc 4: Target slot (1/2/3)
    - Enc 5: Target parent (None, Loop1-8, effects, Master)
    - Enc 6: Target child parameter
    - Enc 7: Mod range min, Enc 8: Mod range max
    Push buttons: toggle enable (1), clear target (4), reset min/max (7/8)
    Hierarchical target lookup tables for parent/child resolution.
    Mod tab now uses encoder knobs instead of desktop modulation panel.
    [MainComponent.cpp, MainComponent.h]
2026-03-10 Phase 3: Automation presets on loop encoders 4 & 5
    - AutomationPresets.h: 10 built-in presets (Off, Fade In, Fade Out,
    Swell, Pulse, Delayed Entry, Fade+Hold, Fade+Stop, Long Swell, Stutter)
    - Encoder 4: select automation preset for current loop
    - Encoder 5: time scale multiplier (0.1x-10.0x) stretches all durations
    - Push button 4: toggle automation preview on selected loop
    - LoopSettings gains timeScale and presetIndex fields
    - Time scaling applied at preset selection (durations in sequence modified)
    - Modulation state variables added to MainComponent.h
2026-03-10 Phase 4: Kiosk mode support for Raspberry Pi
    Code changes:
    - Main.cpp: --kiosk flag for fullscreen, no decorations, hidden cursor
    - MainComponent.cpp: auto-select USB audio device on Linux (Scarlett Solo)
    Pi deployment files (pi-kiosk/):
    - dronemaker.service: systemd unit with watchdog (Restart=always)
    - kiosk-start.sh: xinit launcher with screen blanking prevention
    - update.sh: stop -> git pull -> build -> start convenience script
    - SETUP.md: full setup instructions, commands, and troubleshooting
    Skip kiosk by creating /boot/firmware/desktop-mode file, remove to restore.
    [Main.cpp, MainComponent.cpp]
2026-03-10 Fix GCC build errors: unused variable and shadowed variables
    Remove unused variable 's' in updateModulationParameterKnobs and
    rename inner 'settings' to 'slotSettings' in automation lambdas to
    avoid -Wshadow errors on GCC (Pi build).
    [MainComponent.cpp]
2026-03-11 Loop indicators, gain compensation, automation range modifier, and textFromValueFunction fixes
    - MiniMixerStrip and MultiLoopOverview for live per-loop status display
    - Auto gain compensation for distortion (1/sqrt(drive)) and tape saturation
    - EffectBase gains gainCompDB, autoGainComp, and autoGainFactor fields
    - EffectsChain applies per-effect gain compensation after processing
    - Volume knob becomes automation range modifier when level automation is active
    - All enum/named-value knobs use textFromValueFunction (bottom text box) instead of
    paramLabels (top label) — fixes source selector, LFO shape/rate, randomizer rate,
    target parent/child, automation preset selector
    - textFromValueFu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
    [DistortionEffect.cpp, EffectBase.h, EffectsChain.cpp, LoopRecorder.cpp, LoopRecorder.h, MainComponent.cpp, MainComponent.h, ModulationSource.h]
2026-03-11 Asymmetric distortion drive, pre-HP filter, and granular delay reverb feedback
    Distortion:
    - Asymmetric drive: separate positive/negative peak drive amounts (-1 to +1)
    creates even-order harmonics for tube-like character
    - Pre-distortion highpass filter (20-5000 Hz, log-scaled knob)
    thins bass before saturation for more articulate drones
    - Both new params wired to encoder knobs 5 and 6
    Granular:
    - Feedback parameter (0-0.95): grain output feeds back into the buffer,
    creating reverb-like washes that build and decay
    - Damping: one-pole LP filter on feedback path, darkens each generation
    Auto-damps proportionally to feedback when not set explicitly
    - Feedback replaces Spread on encoder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
    [DistortionEffect.cpp, DistortionEffect.h, GranularEffect.cpp, GranularEffect.h, MainComponent.cpp]
2026-03-11 Fix USB audio auto-detection: use correct JUCE API for device type
    getCurrentAudioDeviceType() returns a String, not a pointer. Use
    getAvailableDeviceTypes() to find the matching AudioIODeviceType
    object, then scan and enumerate device names.
    [MainComponent.cpp]
2026-03-11 Fix kiosk service: add TTY access for X server VT switching
    xinit needs console/VT access to start X. Add TTYPath, StandardInput,
    TTYReset and TTYVHangup to the systemd service.
2026-06-22 auto-snapshot Aidans-Laptop 20260622-222431
    [1456KK4BKBK_faceplate_only.stp, 1456KK4BKBK_whole_enclosure.stp, FaceplateOriginal.step, Faceplate_v1.step, Faceplate_v2.step, Faceplate_v2_with_components.step, Faceplate_v3.step, Faceplate_v3_assembly.step]
2026-06-26 chore(ledger): set Lane: personal (Taliesin/Switchboard routing)
