aeobrien/DronemakerClonev3/docs/audio-interface/Headphone-Out-Above.JPG

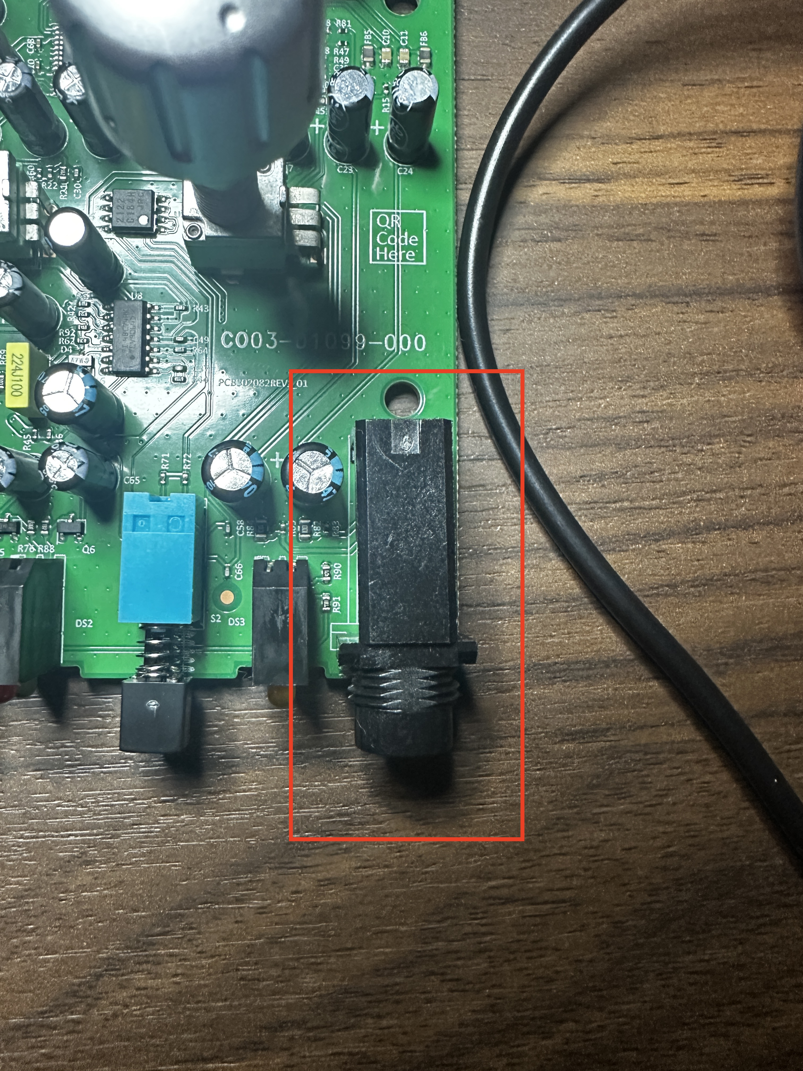
docs/audio-interface/Headphone-Out-Above.JPG
