aeobrien/DronemakerClonev3/docs/audio-interface/Instrument-In-Above.JPG

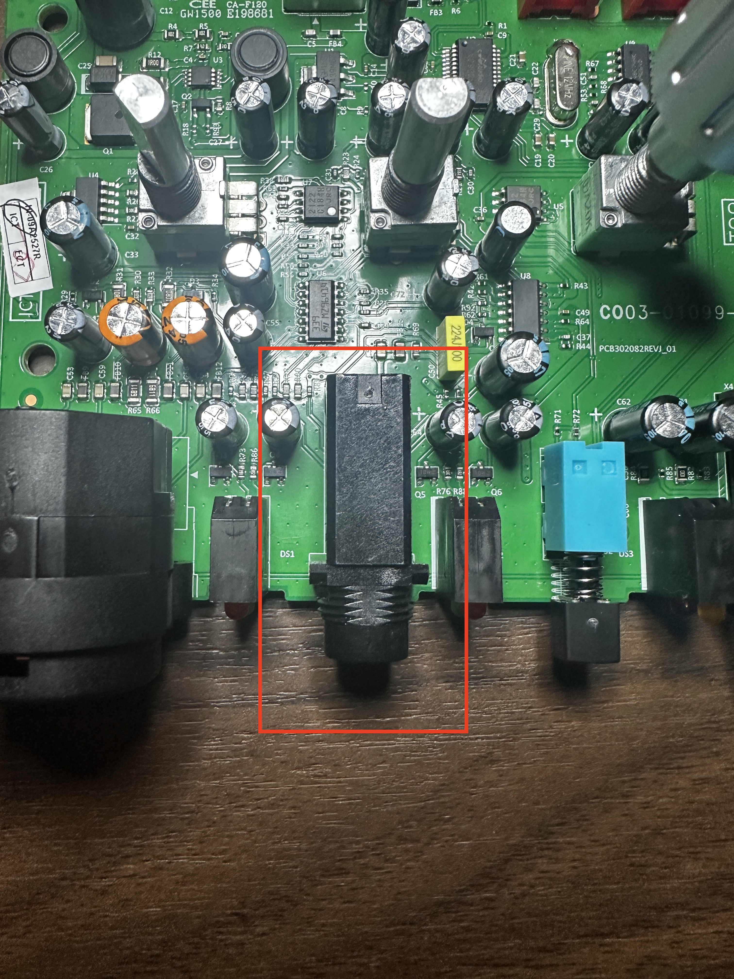
docs/audio-interface/Instrument-In-Above.JPG
