aeobrien/DronemakerClonev3/docs/audio-interface/Instrument-In-Pot-Above.JPG

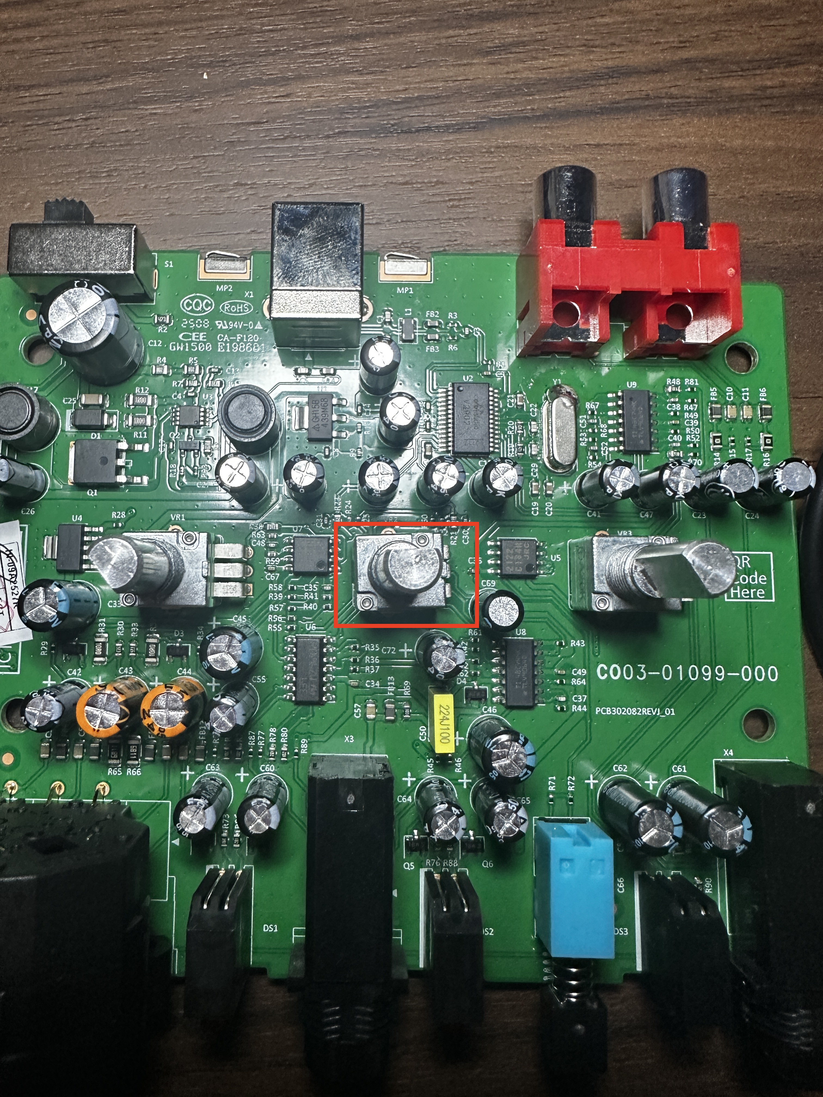
docs/audio-interface/Instrument-In-Pot-Above.JPG
