aeobrien/DronemakerClonev3/docs/audio-interface/Output-Pot-Above.JPG

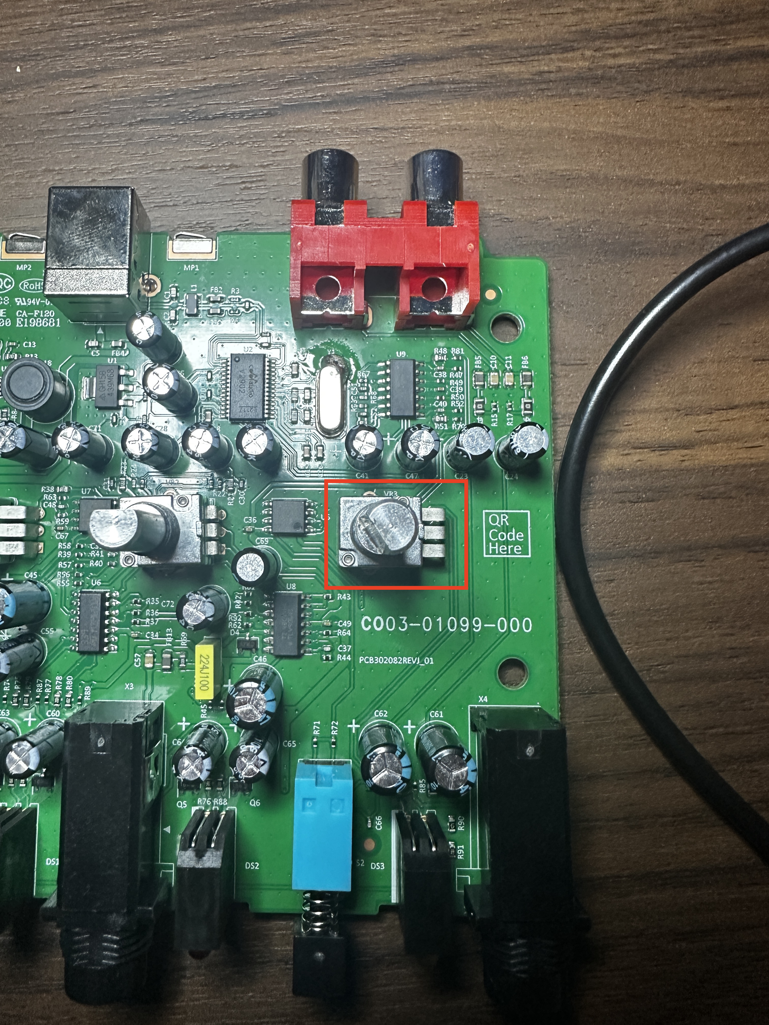
docs/audio-interface/Output-Pot-Above.JPG
