aeobrien/DronemakerClonev3/docs/audio-interface/Phantom-Switch-Above.JPG

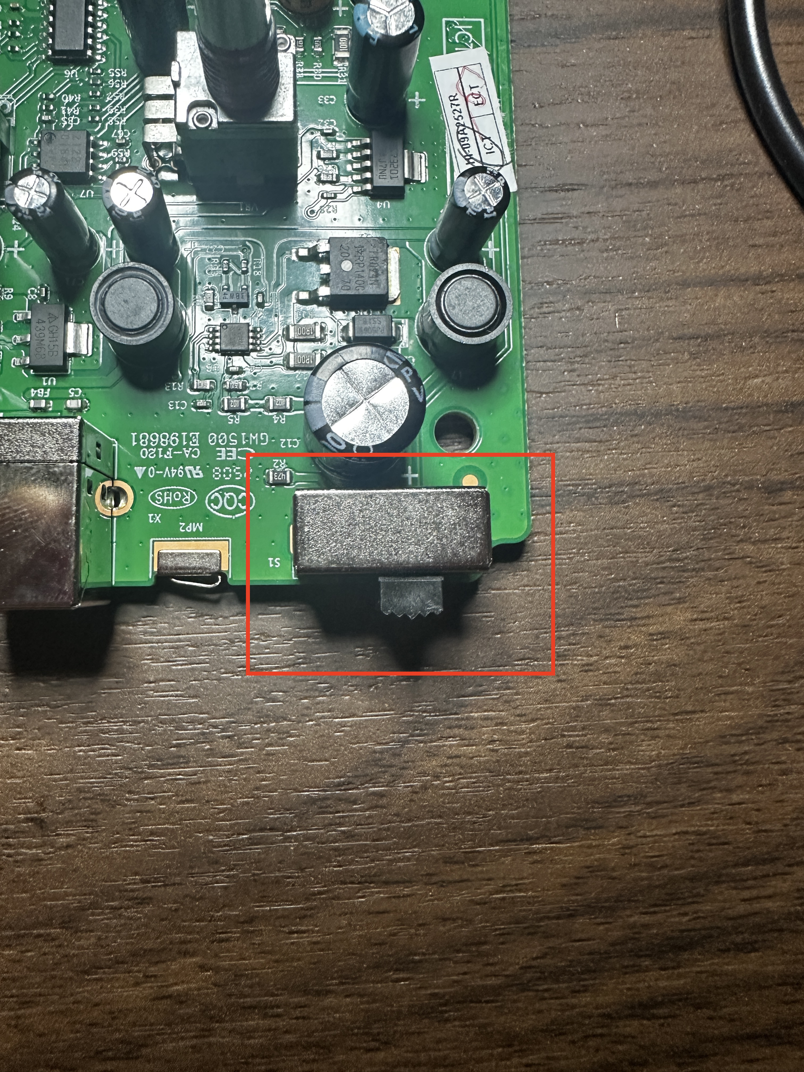
docs/audio-interface/Phantom-Switch-Above.JPG
