aeobrien/DronemakerClonev3/docs/audio-interface/RCA-Out-Above.JPG

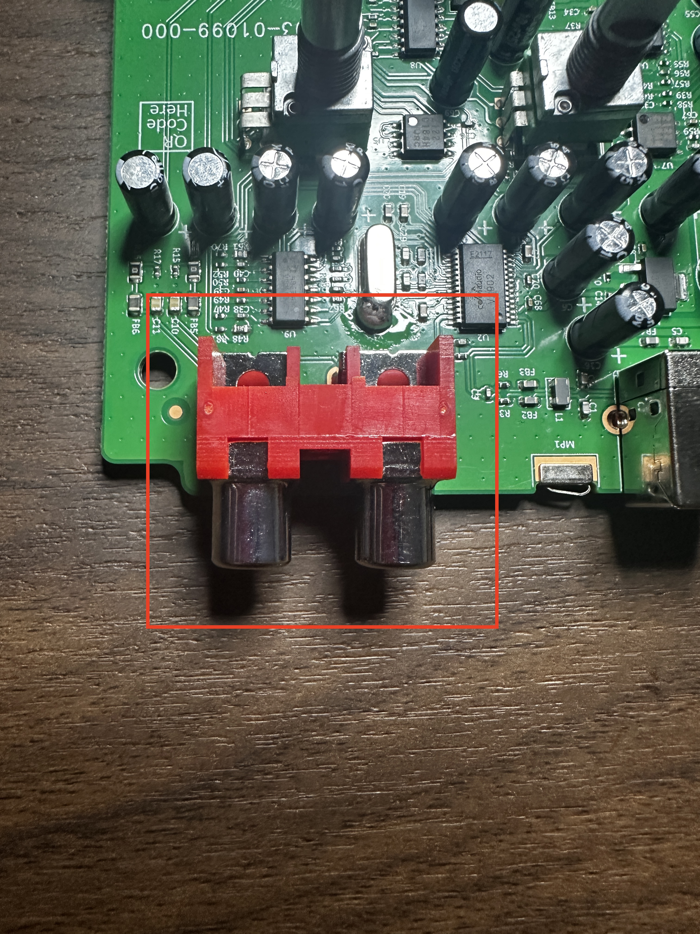
docs/audio-interface/RCA-Out-Above.JPG
