aeobrien/DronemakerClonev3/docs/audio-interface/XLR-TRS-In-Above.JPG

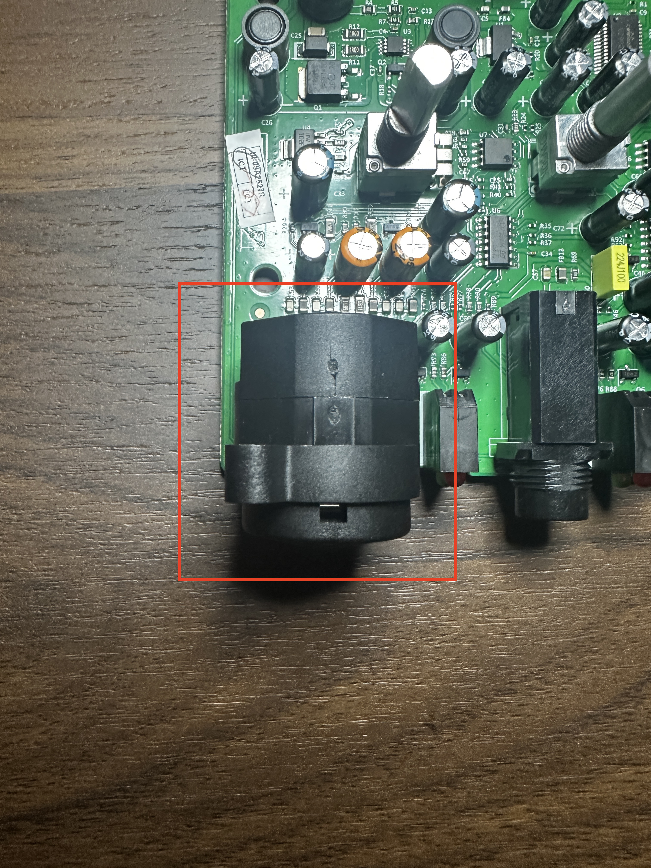
docs/audio-interface/XLR-TRS-In-Above.JPG
