aeobrien/DronemakerClonev3/docs/audio-interface/XLR-TRS-In-Pot-Above.JPG

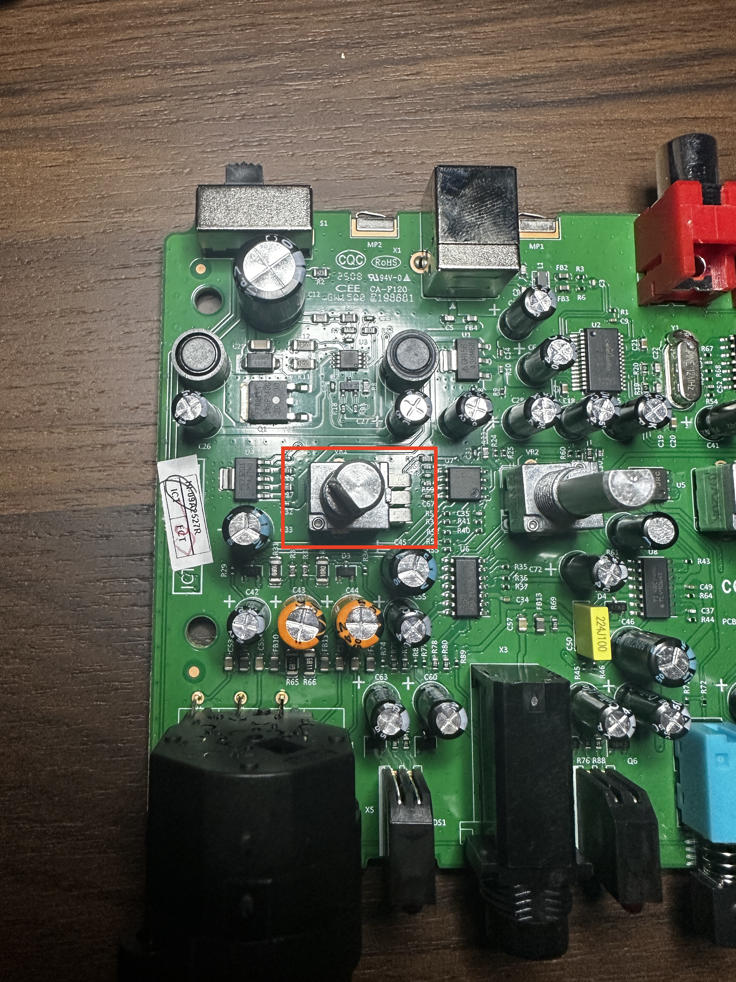
docs/audio-interface/XLR-TRS-In-Pot-Above.JPG
